alwaysmy/Artix-7_GTP_USB3_WCH_MCU/1_Hardware/SCH_XC7K35T_GTP_USB_Core_LiteRevB.1.sch_2025-10-08.pdf

# XC7A35TCSG325_USB3_Demo

2025-10-07

# 2025-09-28 XC7K35T_GTP_USB_Core_LiteRevB.1.sch

封面
A.W.2666
A.W.2666
Rev.A.0 | A3 | Xxx Studio

审阅

绘制

版本

### 创建日期 物料编码

页 | 共

### 原理图

### 更新日期

尺寸

图页

# 版本说明：这一版是无DDR版

## 1、在RevB上小改动，完善

# XC7K35T_GTP_USB_Core_LiteRevB.1

## CONFIG

# FPGA 配置

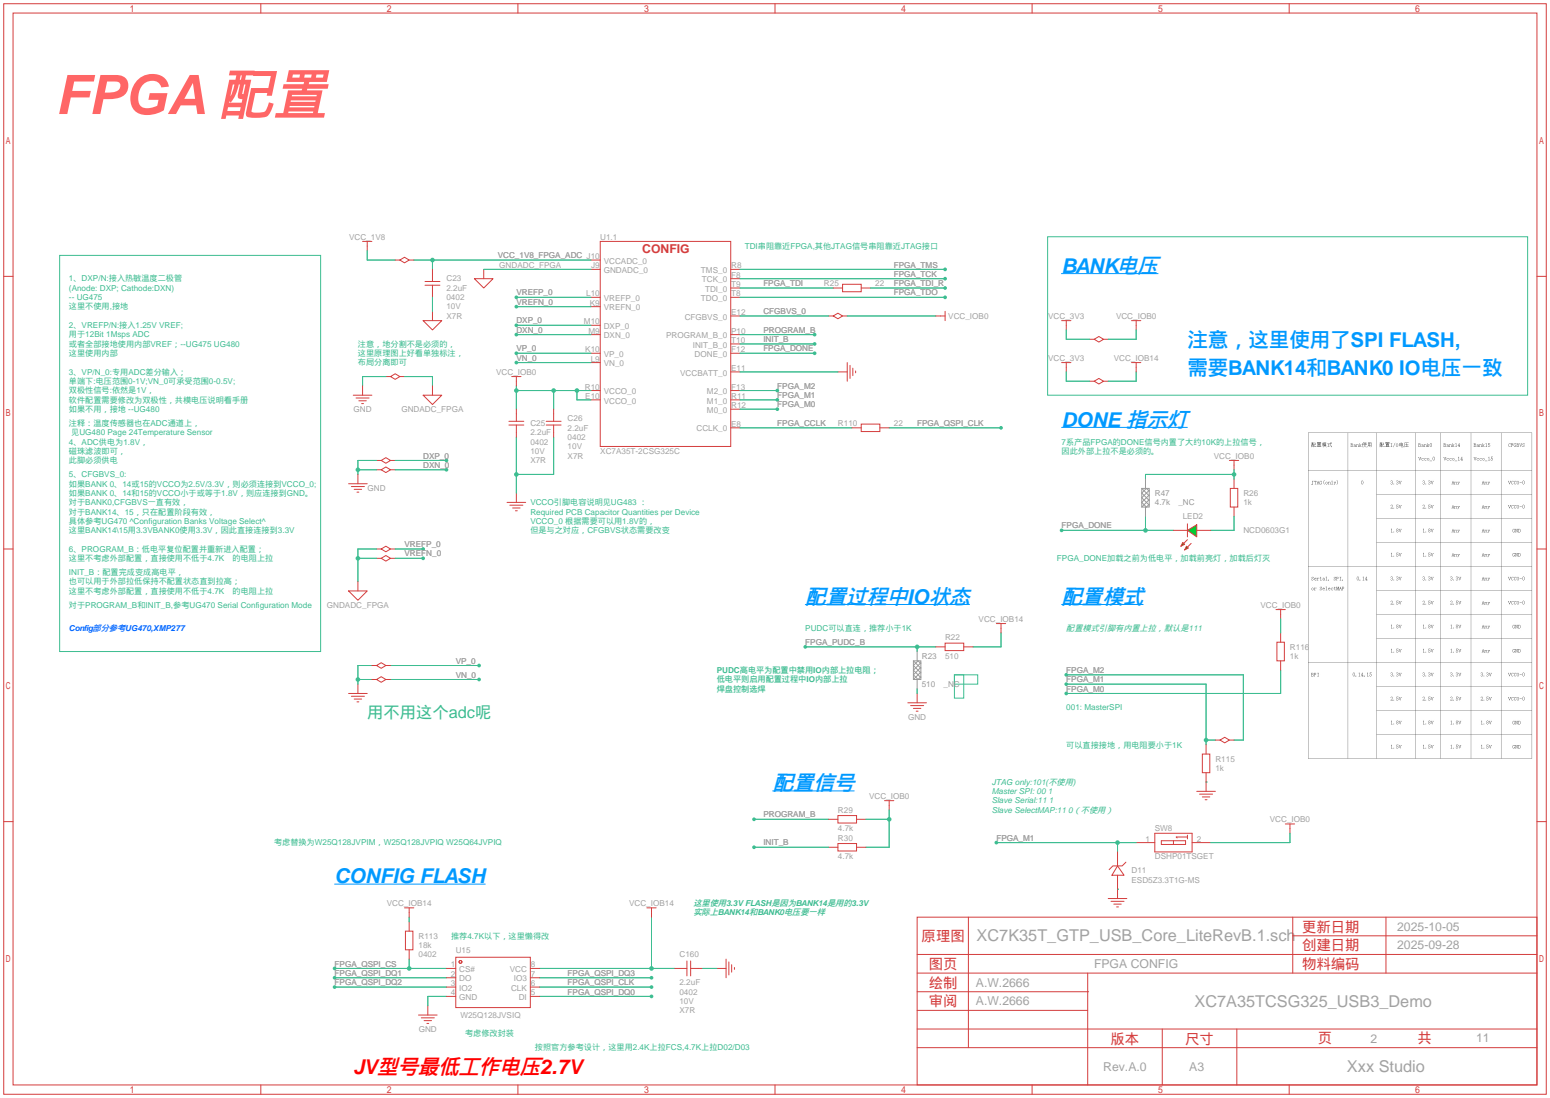
[picture p3: page 2]

VCCO引脚电容说明见UG483 ：
Required PCB Capacitor Quantities per Device
VCCO_0 根据需要可以用1.8V的，
但是与之对应，CFGBVS状态需要改变

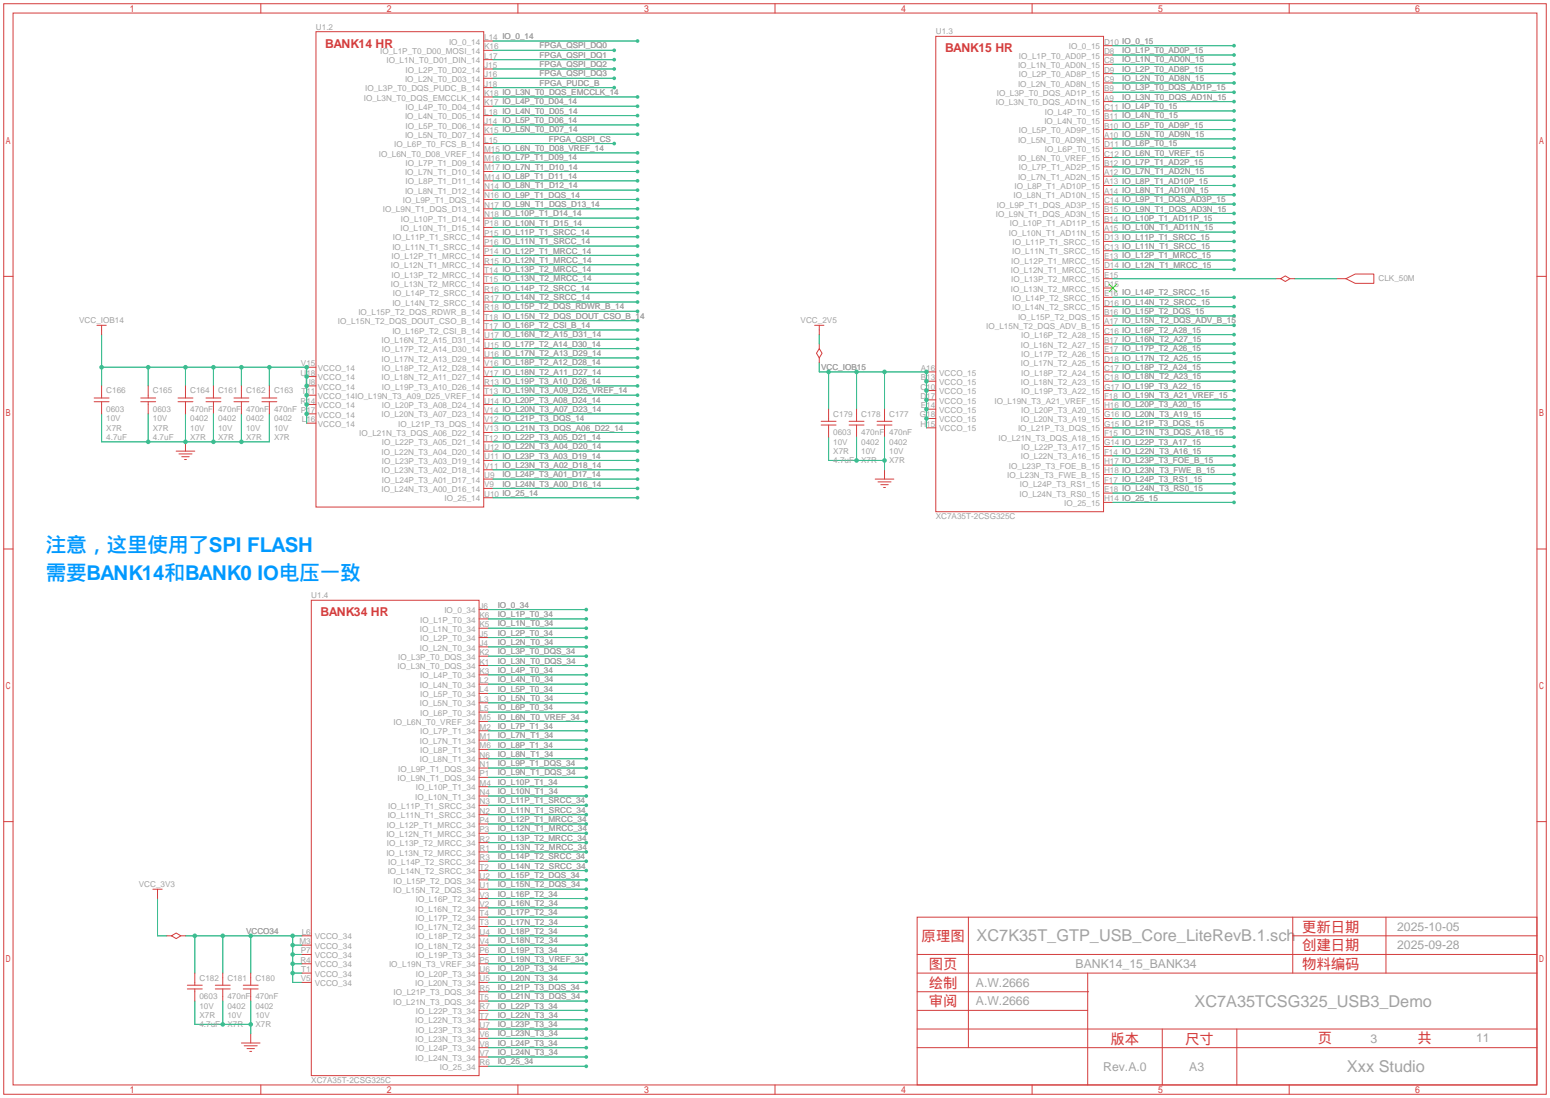
[picture p4: page 3]

## GTP

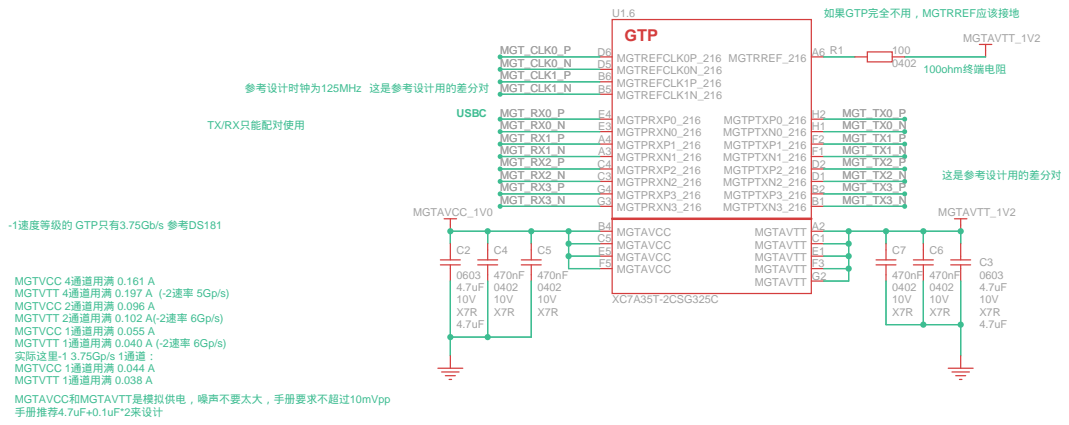
[picture p5: page 4]

## POWER

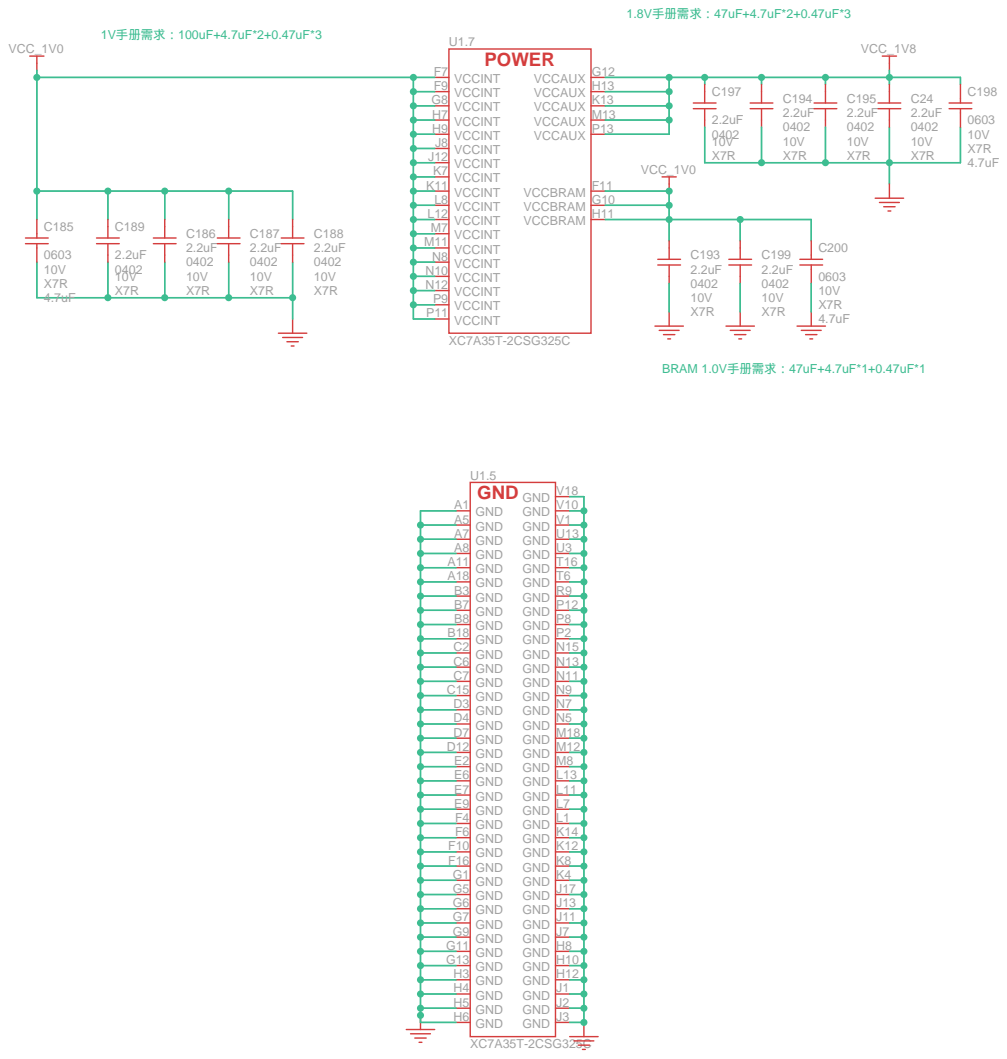
[picture p6: page 5]

# USB3和2都是差分90R

## 提供20对差分对

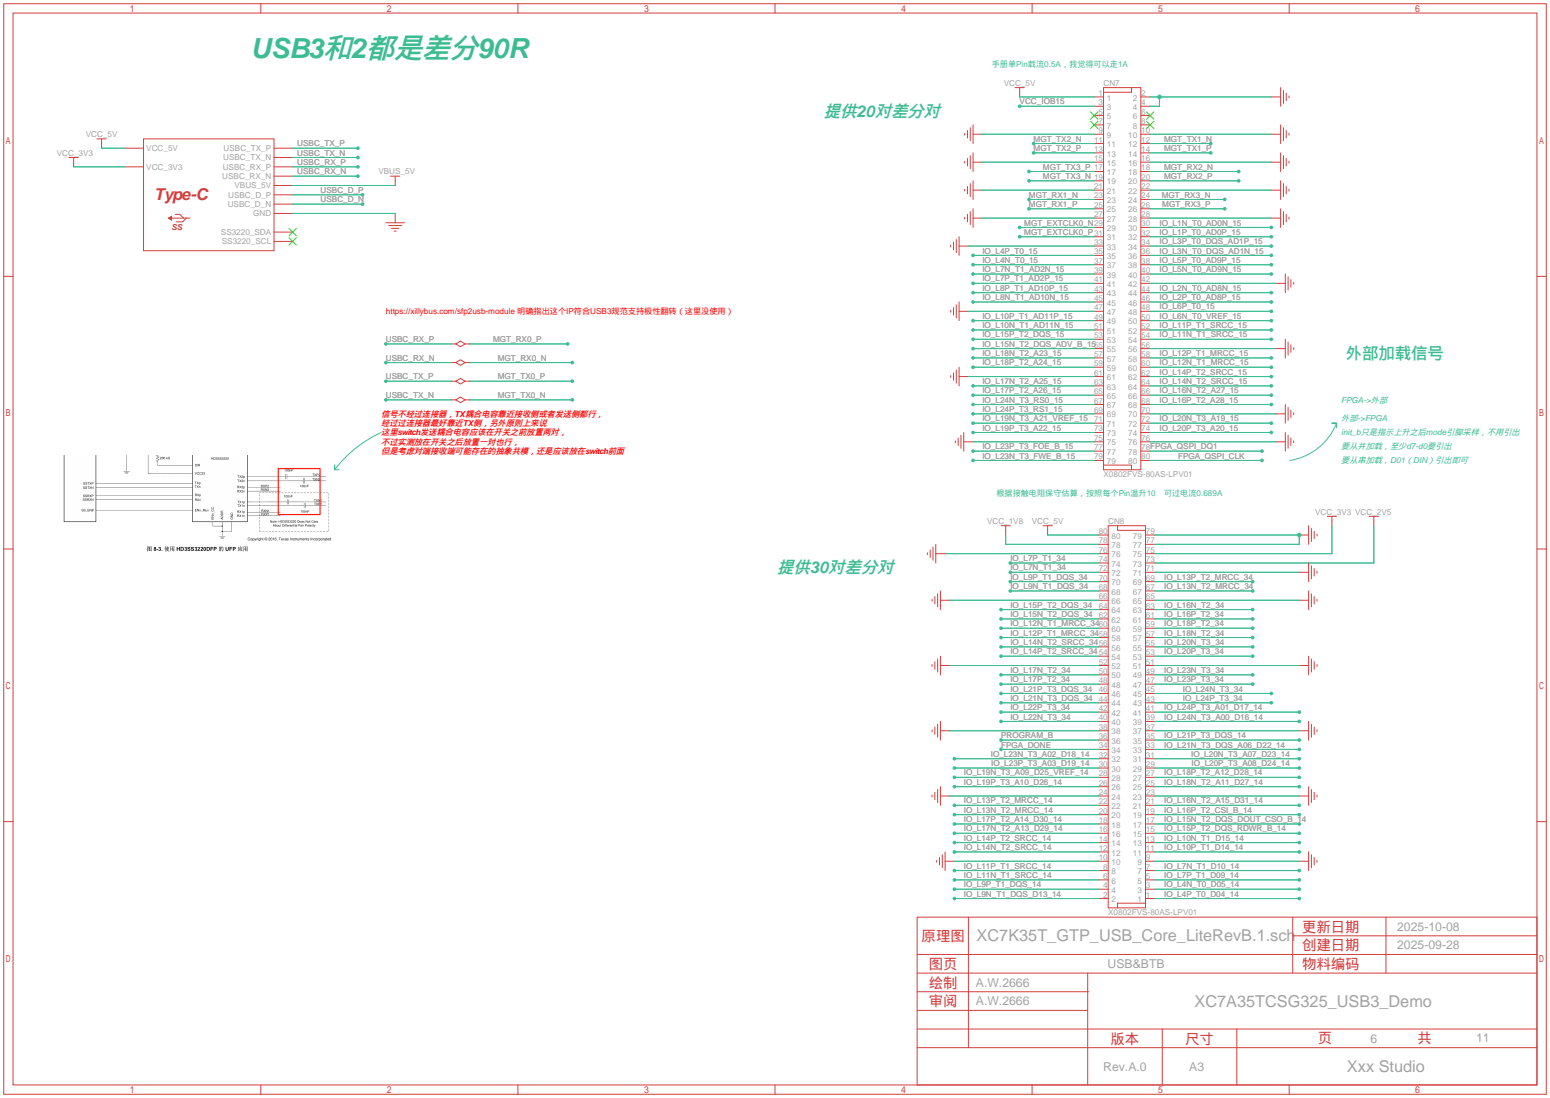
[picture p7: page 6]

https://xillybus.com/sfp2usb-module 明确指出这个IP符合USB3规范支持极性翻转（这里没使用）

# UFP 应用

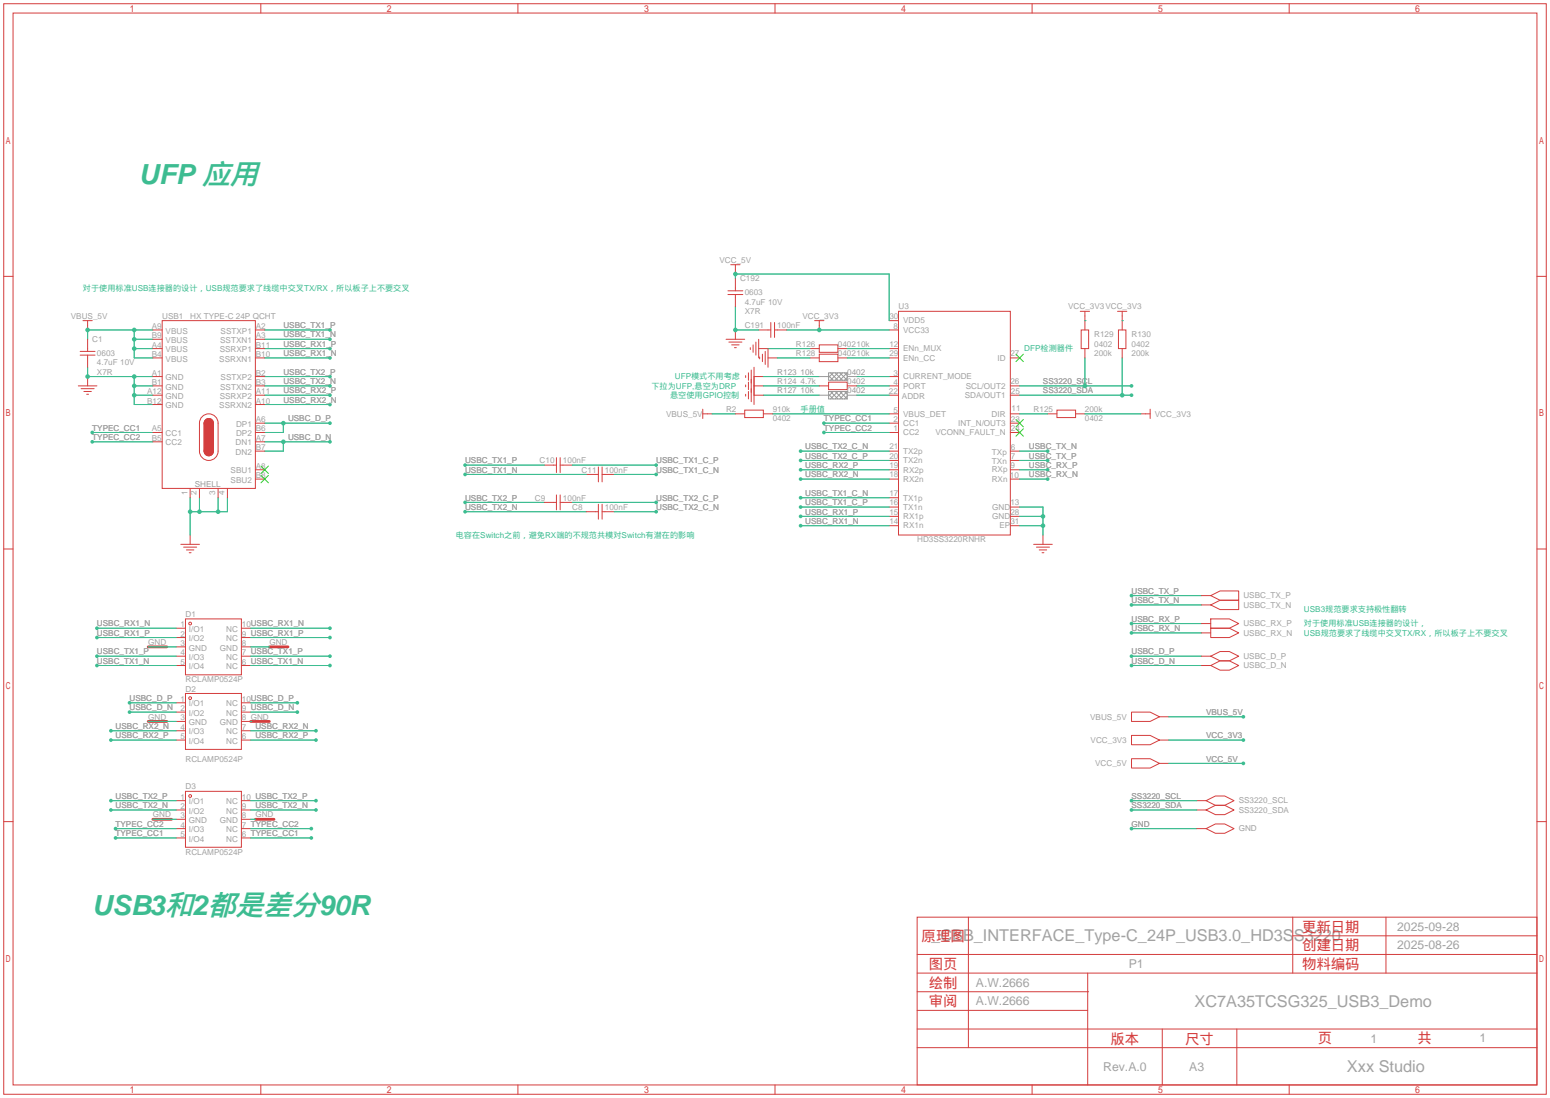
[picture p8: page 7]

对于使用标准USB连接器的设计，USB规范要求了线缆中交叉TX/RX，所以板子上不要交叉

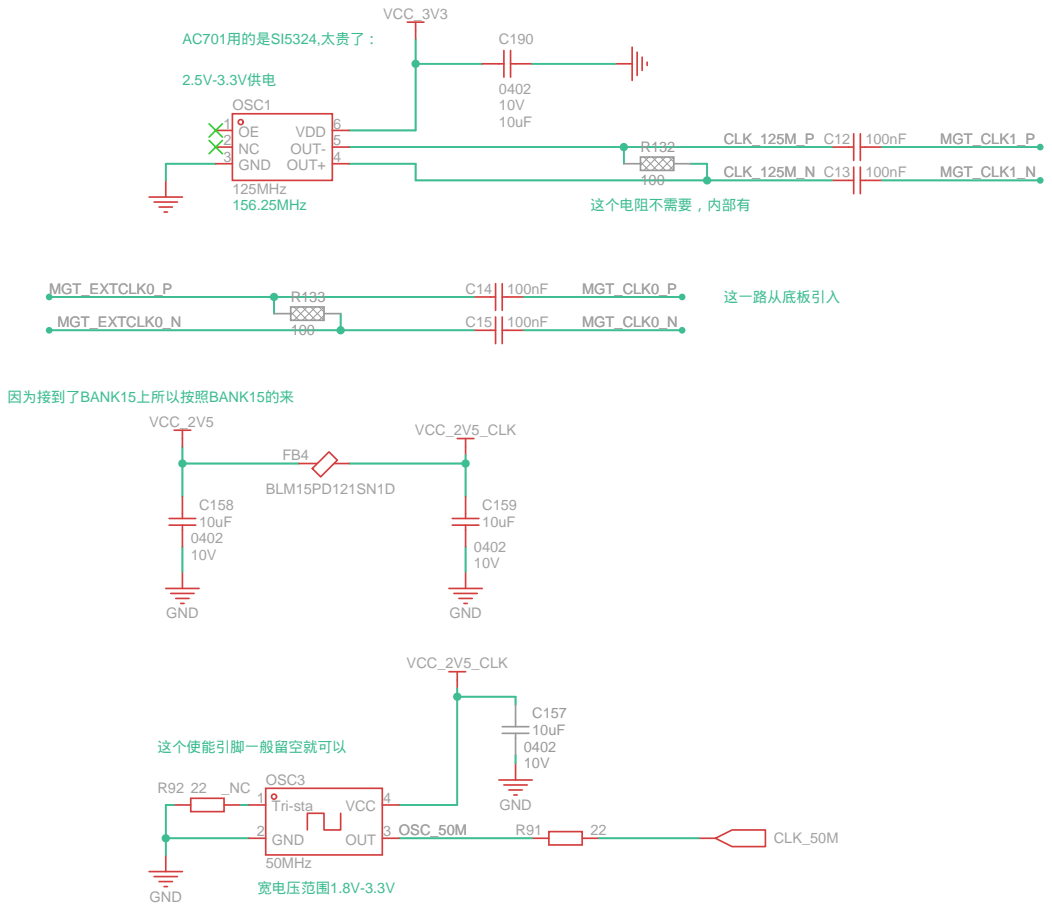
[picture p9: page 8]

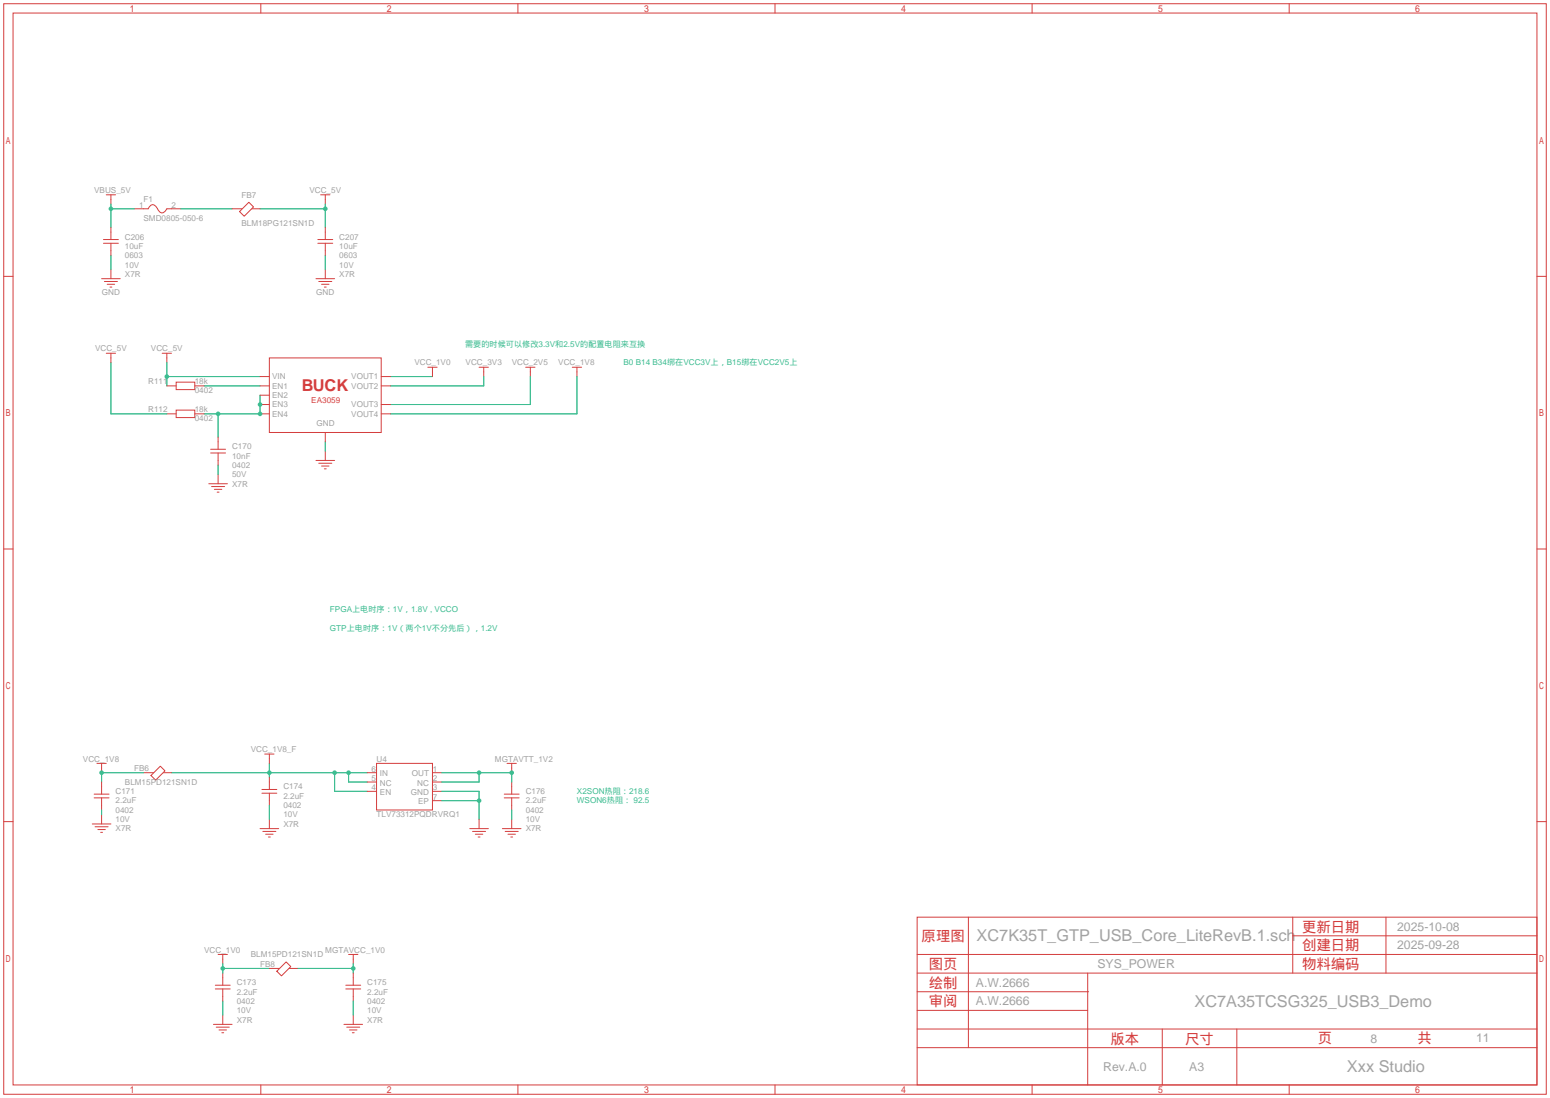
[picture p10: page 9]

# 输出范围0.6V to Vin 工作频率：1.5MHz

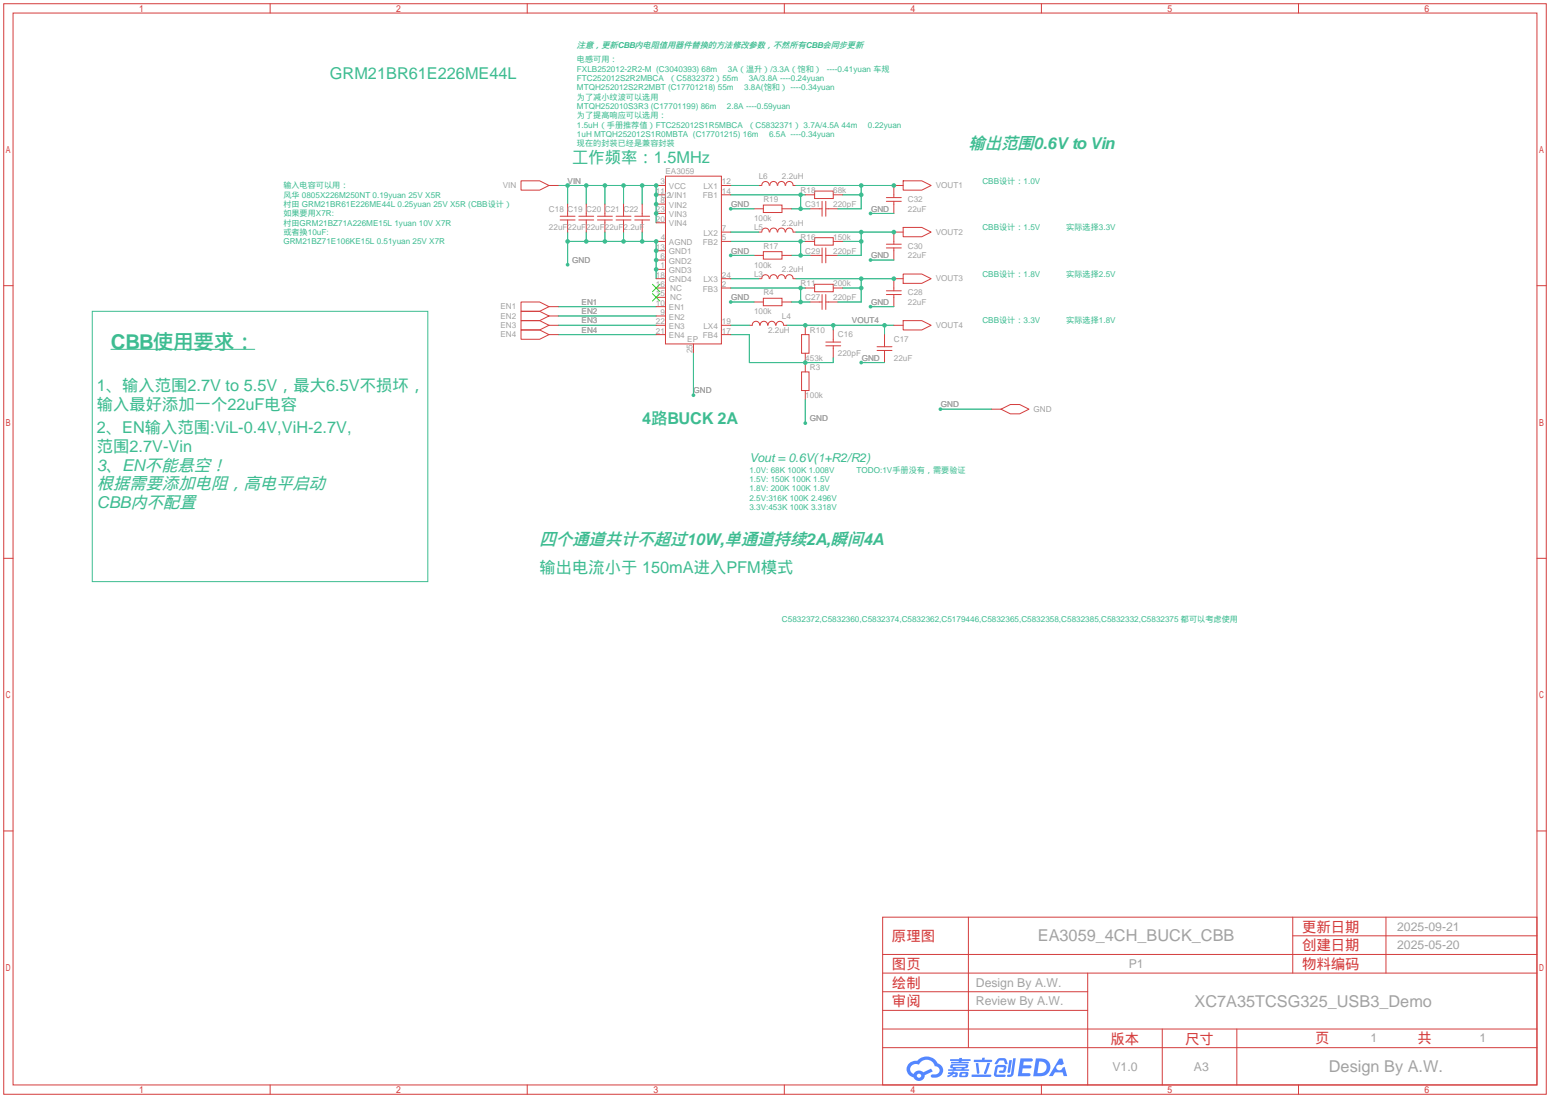
[picture p11: page 10]

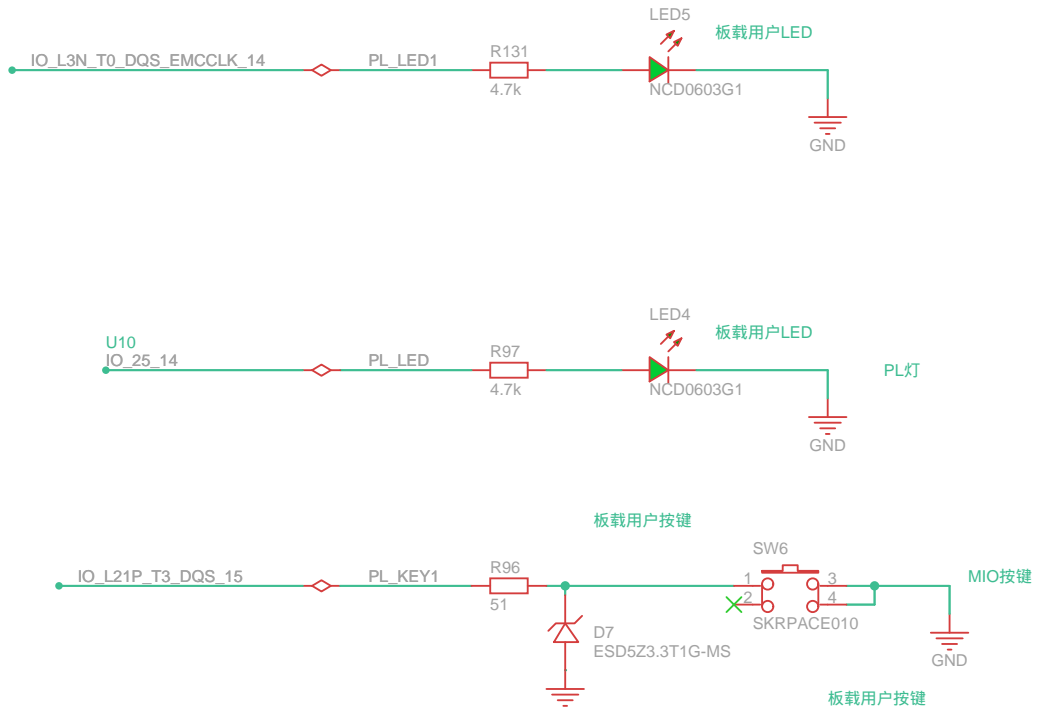
[picture p12: page 11]

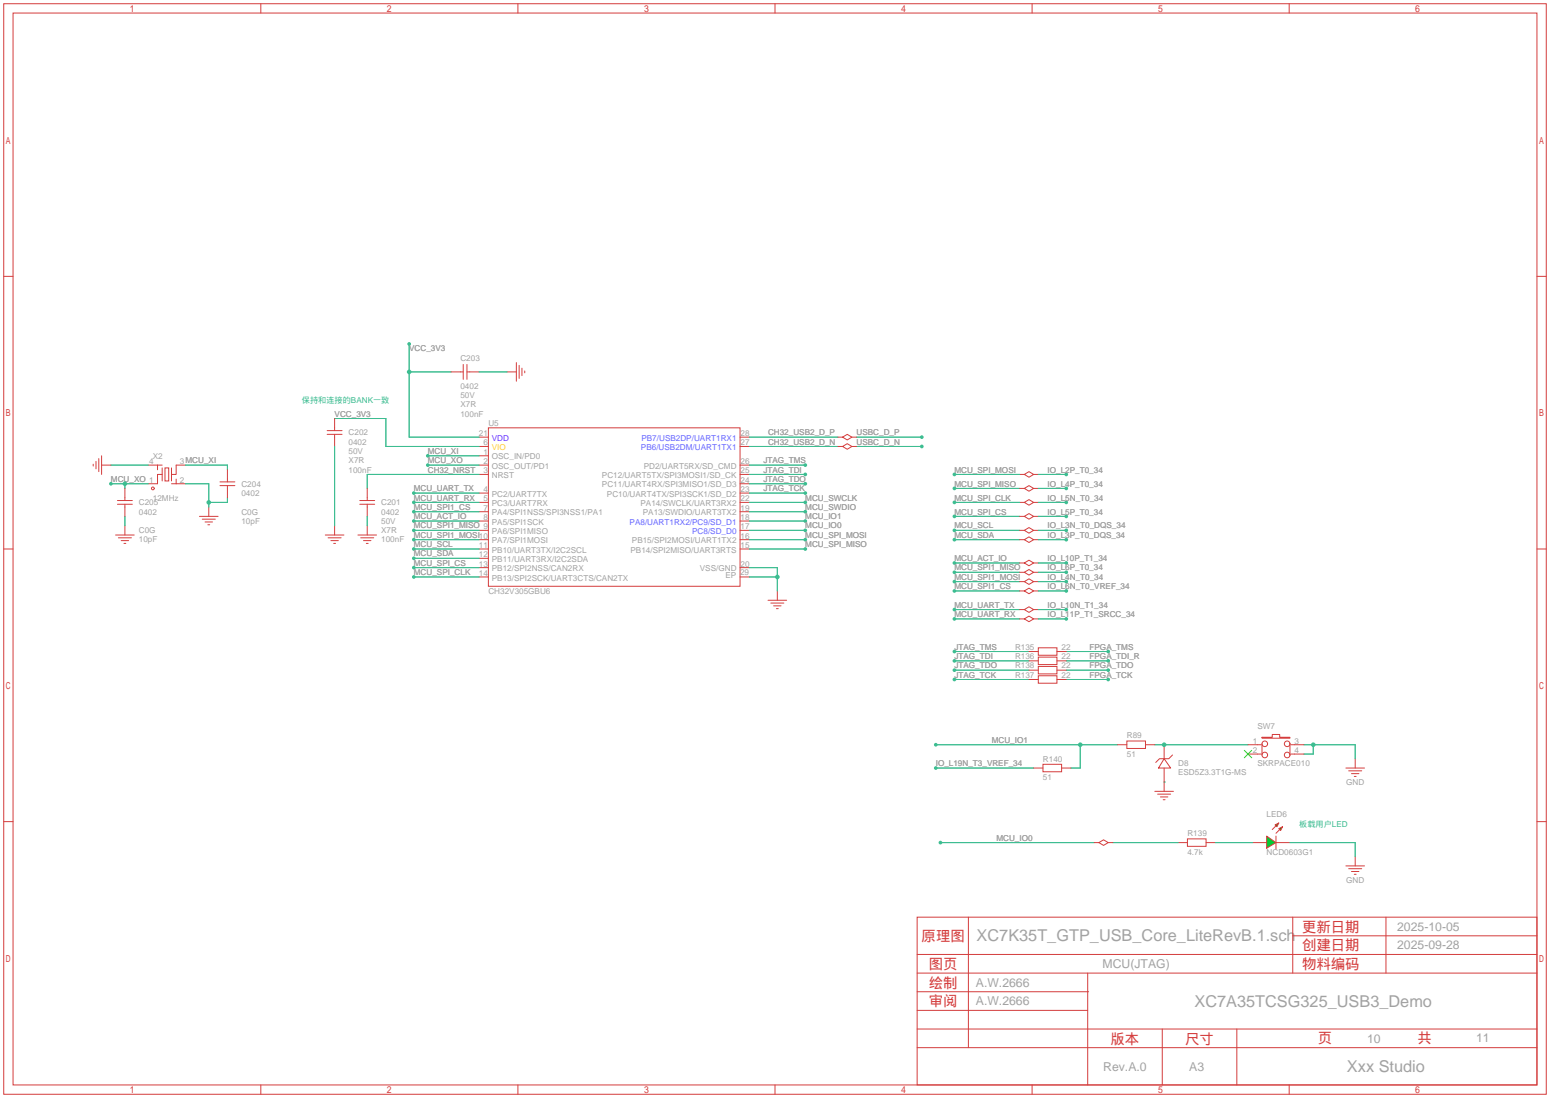
[picture p13: page 12]

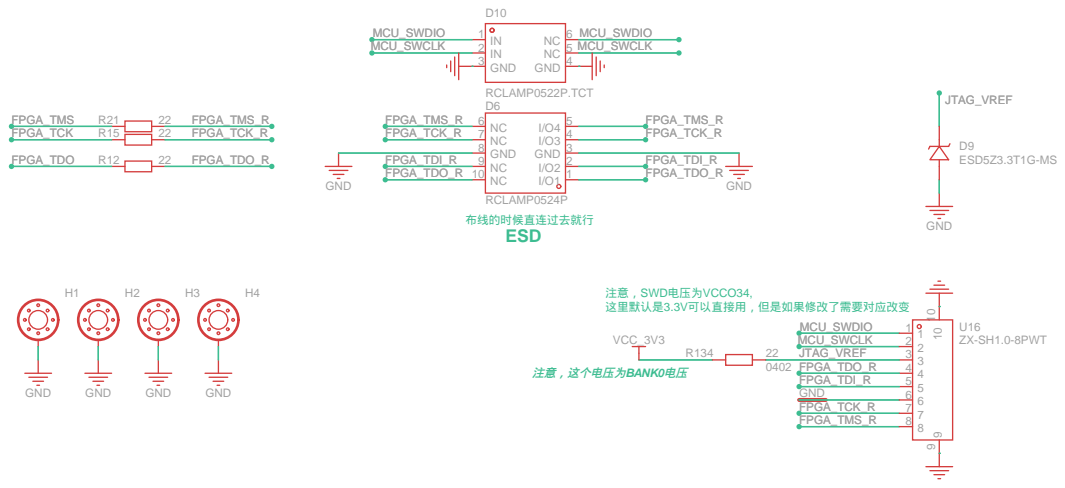
[picture p14: page 13]
