alwaysmy/Artix-7_GTP_USB3_WCH_MCU/(list of files, drawings)

Other design files:
1_Hardware/ProDoc_XC7K35T_GTP_USB_Core_LiteRevB.1.brd_2025-10-08.epro
