alwaysmy/Artix-7_GTP_USB3_WCH_MCU/2_Firmware/Artix-7_GTP_USB3_WCH_MCU_XillyUSB-USBC_SpeedTest/vivado-essentials/fifo_32/fifo_32_sim_netlist.v

// Copyright 1986-2019 Xilinx, Inc. All Rights Reserved.
// --------------------------------------------------------------------------------
// Tool Version: Vivado v.2018.3.1 (win64) Build 2489853 Tue Mar 26 04:20:25 MDT 2019
// Date        : Mon May 19 22:49:03 2025
// Host        : TS-Always running 64-bit major release  (build 9200)
// Command     : write_verilog -force -mode funcsim
//               D:/MyProjects/2_MyDesigns/USB3_Artix_GTP/xillyusb-bundle-artix7-trenz-1.10/vivado-essentials/fifo_32/fifo_32_sim_netlist.v
// Design      : fifo_32
// Purpose     : This verilog netlist is a functional simulation representation of the design and should not be modified
//               or synthesized. This netlist cannot be used for SDF annotated simulation.
// Device      : xc7a35tcsg325-2
// --------------------------------------------------------------------------------
`timescale 1 ps / 1 ps

(* CHECK_LICENSE_TYPE = "fifo_32,fifo_generator_v13_2_3,{}" *) (* downgradeipidentifiedwarnings = "yes" *) (* x_core_info = "fifo_generator_v13_2_3,Vivado 2018.3.1" *) 
(* NotValidForBitStream *)
module fifo_32
   (clk,
    srst,
    din,
    wr_en,
    rd_en,
    dout,
    full,
    empty);
  (* x_interface_info = "xilinx.com:signal:clock:1.0 core_clk CLK" *) (* x_interface_parameter = "XIL_INTERFACENAME core_clk, FREQ_HZ 100000000, PHASE 0.000, INSERT_VIP 0" *) input clk;
  input srst;
  (* x_interface_info = "xilinx.com:interface:fifo_write:1.0 FIFO_WRITE WR_DATA" *) input [31:0]din;
  (* x_interface_info = "xilinx.com:interface:fifo_write:1.0 FIFO_WRITE WR_EN" *) input wr_en;
  (* x_interface_info = "xilinx.com:interface:fifo_read:1.0 FIFO_READ RD_EN" *) input rd_en;
  (* x_interface_info = "xilinx.com:interface:fifo_read:1.0 FIFO_READ RD_DATA" *) output [31:0]dout;
  (* x_interface_info = "xilinx.com:interface:fifo_write:1.0 FIFO_WRITE FULL" *) output full;
  (* x_interface_info = "xilinx.com:interface:fifo_read:1.0 FIFO_READ EMPTY" *) output empty;

  wire clk;
  wire [31:0]din;
  wire [31:0]dout;
  wire empty;
  wire full;
  wire rd_en;
  wire srst;
  wire wr_en;
  wire NLW_U0_almost_empty_UNCONNECTED;
  wire NLW_U0_almost_full_UNCONNECTED;
  wire NLW_U0_axi_ar_dbiterr_UNCONNECTED;
  wire NLW_U0_axi_ar_overflow_UNCONNECTED;
  wire NLW_U0_axi_ar_prog_empty_UNCONNECTED;
  wire NLW_U0_axi_ar_prog_full_UNCONNECTED;
  wire NLW_U0_axi_ar_sbiterr_UNCONNECTED;
  wire NLW_U0_axi_ar_underflow_UNCONNECTED;
  wire NLW_U0_axi_aw_dbiterr_UNCONNECTED;
  wire NLW_U0_axi_aw_overflow_UNCONNECTED;
  wire NLW_U0_axi_aw_prog_empty_UNCONNECTED;
  wire NLW_U0_axi_aw_prog_full_UNCONNECTED;
  wire NLW_U0_axi_aw_sbiterr_UNCONNECTED;
  wire NLW_U0_axi_aw_underflow_UNCONNECTED;
  wire NLW_U0_axi_b_dbiterr_UNCONNECTED;
  wire NLW_U0_axi_b_overflow_UNCONNECTED;
  wire NLW_U0_axi_b_prog_empty_UNCONNECTED;
  wire NLW_U0_axi_b_prog_full_UNCONNECTED;
  wire NLW_U0_axi_b_sbiterr_UNCONNECTED;
  wire NLW_U0_axi_b_underflow_UNCONNECTED;
  wire NLW_U0_axi_r_dbiterr_UNCONNECTED;
  wire NLW_U0_axi_r_overflow_UNCONNECTED;
  wire NLW_U0_axi_r_prog_empty_UNCONNECTED;
  wire NLW_U0_axi_r_prog_full_UNCONNECTED;
  wire NLW_U0_axi_r_sbiterr_UNCONNECTED;
  wire NLW_U0_axi_r_underflow_UNCONNECTED;
  wire NLW_U0_axi_w_dbiterr_UNCONNECTED;
  wire NLW_U0_axi_w_overflow_UNCONNECTED;
  wire NLW_U0_axi_w_prog_empty_UNCONNECTED;
  wire NLW_U0_axi_w_prog_full_UNCONNECTED;
  wire NLW_U0_axi_w_sbiterr_UNCONNECTED;
  wire NLW_U0_axi_w_underflow_UNCONNECTED;
  wire NLW_U0_axis_dbiterr_UNCONNECTED;
  wire NLW_U0_axis_overflow_UNCONNECTED;
  wire NLW_U0_axis_prog_empty_UNCONNECTED;
  wire NLW_U0_axis_prog_full_UNCONNECTED;
  wire NLW_U0_axis_sbiterr_UNCONNECTED;
  wire NLW_U0_axis_underflow_UNCONNECTED;
  wire NLW_U0_dbiterr_UNCONNECTED;
  wire NLW_U0_m_axi_arvalid_UNCONNECTED;
  wire NLW_U0_m_axi_awvalid_UNCONNECTED;
  wire NLW_U0_m_axi_bready_UNCONNECTED;
  wire NLW_U0_m_axi_rready_UNCONNECTED;
  wire NLW_U0_m_axi_wlast_UNCONNECTED;
  wire NLW_U0_m_axi_wvalid_UNCONNECTED;
  wire NLW_U0_m_axis_tlast_UNCONNECTED;
  wire NLW_U0_m_axis_tvalid_UNCONNECTED;
  wire NLW_U0_overflow_UNCONNECTED;
  wire NLW_U0_prog_empty_UNCONNECTED;
  wire NLW_U0_prog_full_UNCONNECTED;
  wire NLW_U0_rd_rst_busy_UNCONNECTED;
  wire NLW_U0_s_axi_arready_UNCONNECTED;
  wire NLW_U0_s_axi_awready_UNCONNECTED;
  wire NLW_U0_s_axi_bvalid_UNCONNECTED;
  wire NLW_U0_s_axi_rlast_UNCONNECTED;
  wire NLW_U0_s_axi_rvalid_UNCONNECTED;
  wire NLW_U0_s_axi_wready_UNCONNECTED;
  wire NLW_U0_s_axis_tready_UNCONNECTED;
  wire NLW_U0_sbiterr_UNCONNECTED;
  wire NLW_U0_underflow_UNCONNECTED;
  wire NLW_U0_valid_UNCONNECTED;
  wire NLW_U0_wr_ack_UNCONNECTED;
  wire NLW_U0_wr_rst_busy_UNCONNECTED;
  wire [4:0]NLW_U0_axi_ar_data_count_UNCONNECTED;
  wire [4:0]NLW_U0_axi_ar_rd_data_count_UNCONNECTED;
  wire [4:0]NLW_U0_axi_ar_wr_data_count_UNCONNECTED;
  wire [4:0]NLW_U0_axi_aw_data_count_UNCONNECTED;
  wire [4:0]NLW_U0_axi_aw_rd_data_count_UNCONNECTED;
  wire [4:0]NLW_U0_axi_aw_wr_data_count_UNCONNECTED;
  wire [4:0]NLW_U0_axi_b_data_count_UNCONNECTED;
  wire [4:0]NLW_U0_axi_b_rd_data_count_UNCONNECTED;
  wire [4:0]NLW_U0_axi_b_wr_data_count_UNCONNECTED;
  wire [10:0]NLW_U0_axi_r_data_count_UNCONNECTED;
  wire [10:0]NLW_U0_axi_r_rd_data_count_UNCONNECTED;
  wire [10:0]NLW_U0_axi_r_wr_data_count_UNCONNECTED;
  wire [10:0]NLW_U0_axi_w_data_count_UNCONNECTED;
  wire [10:0]NLW_U0_axi_w_rd_data_count_UNCONNECTED;
  wire [10:0]NLW_U0_axi_w_wr_data_count_UNCONNECTED;
  wire [10:0]NLW_U0_axis_data_count_UNCONNECTED;
  wire [10:0]NLW_U0_axis_rd_data_count_UNCONNECTED;
  wire [10:0]NLW_U0_axis_wr_data_count_UNCONNECTED;
  wire [13:0]NLW_U0_data_count_UNCONNECTED;
  wire [31:0]NLW_U0_m_axi_araddr_UNCONNECTED;
  wire [1:0]NLW_U0_m_axi_arburst_UNCONNECTED;
  wire [3:0]NLW_U0_m_axi_arcache_UNCONNECTED;
  wire [0:0]NLW_U0_m_axi_arid_UNCONNECTED;
  wire [7:0]NLW_U0_m_axi_arlen_UNCONNECTED;
  wire [0:0]NLW_U0_m_axi_arlock_UNCONNECTED;
  wire [2:0]NLW_U0_m_axi_arprot_UNCONNECTED;
  wire [3:0]NLW_U0_m_axi_arqos_UNCONNECTED;
  wire [3:0]NLW_U0_m_axi_arregion_UNCONNECTED;
  wire [2:0]NLW_U0_m_axi_arsize_UNCONNECTED;
  wire [0:0]NLW_U0_m_axi_aruser_UNCONNECTED;
  wire [31:0]NLW_U0_m_axi_awaddr_UNCONNECTED;
  wire [1:0]NLW_U0_m_axi_awburst_UNCONNECTED;
  wire [3:0]NLW_U0_m_axi_awcache_UNCONNECTED;
  wire [0:0]NLW_U0_m_axi_awid_UNCONNECTED;
  wire [7:0]NLW_U0_m_axi_awlen_UNCONNECTED;
  wire [0:0]NLW_U0_m_axi_awlock_UNCONNECTED;
  wire [2:0]NLW_U0_m_axi_awprot_UNCONNECTED;
  wire [3:0]NLW_U0_m_axi_awqos_UNCONNECTED;
  wire [3:0]NLW_U0_m_axi_awregion_UNCONNECTED;
  wire [2:0]NLW_U0_m_axi_awsize_UNCONNECTED;
  wire [0:0]NLW_U0_m_axi_awuser_UNCONNECTED;
  wire [63:0]NLW_U0_m_axi_wdata_UNCONNECTED;
  wire [0:0]NLW_U0_m_axi_wid_UNCONNECTED;
  wire [7:0]NLW_U0_m_axi_wstrb_UNCONNECTED;
  wire [0:0]NLW_U0_m_axi_wuser_UNCONNECTED;
  wire [0:0]NLW_U0_m_axis_tdata_UNCONNECTED;
  wire [0:0]NLW_U0_m_axis_tdest_UNCONNECTED;
  wire [0:0]NLW_U0_m_axis_tid_UNCONNECTED;
  wire [0:0]NLW_U0_m_axis_tkeep_UNCONNECTED;
  wire [0:0]NLW_U0_m_axis_tstrb_UNCONNECTED;
  wire [3:0]NLW_U0_m_axis_tuser_UNCONNECTED;
  wire [13:0]NLW_U0_rd_data_count_UNCONNECTED;
  wire [0:0]NLW_U0_s_axi_bid_UNCONNECTED;
  wire [1:0]NLW_U0_s_axi_bresp_UNCONNECTED;
  wire [0:0]NLW_U0_s_axi_buser_UNCONNECTED;
  wire [63:0]NLW_U0_s_axi_rdata_UNCONNECTED;
  wire [0:0]NLW_U0_s_axi_rid_UNCONNECTED;
  wire [1:0]NLW_U0_s_axi_rresp_UNCONNECTED;
  wire [0:0]NLW_U0_s_axi_ruser_UNCONNECTED;
  wire [13:0]NLW_U0_wr_data_count_UNCONNECTED;

  (* C_ADD_NGC_CONSTRAINT = "0" *) 
  (* C_APPLICATION_TYPE_AXIS = "0" *) 
  (* C_APPLICATION_TYPE_RACH = "0" *) 
  (* C_APPLICATION_TYPE_RDCH = "0" *) 
  (* C_APPLICATION_TYPE_WACH = "0" *) 
  (* C_APPLICATION_TYPE_WDCH = "0" *) 
  (* C_APPLICATION_TYPE_WRCH = "0" *) 
  (* C_AXIS_TDATA_WIDTH = "1" *) 
  (* C_AXIS_TDEST_WIDTH = "1" *) 
  (* C_AXIS_TID_WIDTH = "1" *) 
  (* C_AXIS_TKEEP_WIDTH = "1" *) 
  (* C_AXIS_TSTRB_WIDTH = "1" *) 
  (* C_AXIS_TUSER_WIDTH = "4" *) 
  (* C_AXIS_TYPE = "0" *) 
  (* C_AXI_ADDR_WIDTH = "32" *) 
  (* C_AXI_ARUSER_WIDTH = "1" *) 
  (* C_AXI_AWUSER_WIDTH = "1" *) 
  (* C_AXI_BUSER_WIDTH = "1" *) 
  (* C_AXI_DATA_WIDTH = "64" *) 
  (* C_AXI_ID_WIDTH = "1" *) 
  (* C_AXI_LEN_WIDTH = "8" *) 
  (* C_AXI_LOCK_WIDTH = "1" *) 
  (* C_AXI_RUSER_WIDTH = "1" *) 
  (* C_AXI_TYPE = "1" *) 
  (* C_AXI_WUSER_WIDTH = "1" *) 
  (* C_COMMON_CLOCK = "1" *) 
  (* C_COUNT_TYPE = "0" *) 
  (* C_DATA_COUNT_WIDTH = "14" *) 
  (* C_DEFAULT_VALUE = "BlankString" *) 
  (* C_DIN_WIDTH = "32" *) 
  (* C_DIN_WIDTH_AXIS = "1" *) 
  (* C_DIN_WIDTH_RACH = "32" *) 
  (* C_DIN_WIDTH_RDCH = "64" *) 
  (* C_DIN_WIDTH_WACH = "1" *) 
  (* C_DIN_WIDTH_WDCH = "64" *) 
  (* C_DIN_WIDTH_WRCH = "2" *) 
  (* C_DOUT_RST_VAL = "0" *) 
  (* C_DOUT_WIDTH = "32" *) 
  (* C_ENABLE_RLOCS = "0" *) 
  (* C_ENABLE_RST_SYNC = "1" *) 
  (* C_EN_SAFETY_CKT = "0" *) 
  (* C_ERROR_INJECTION_TYPE = "0" *) 
  (* C_ERROR_INJECTION_TYPE_AXIS = "0" *) 
  (* C_ERROR_INJECTION_TYPE_RACH = "0" *) 
  (* C_ERROR_INJECTION_TYPE_RDCH = "0" *) 
  (* C_ERROR_INJECTION_TYPE_WACH = "0" *) 
  (* C_ERROR_INJECTION_TYPE_WDCH = "0" *) 
  (* C_ERROR_INJECTION_TYPE_WRCH = "0" *) 
  (* C_FAMILY = "artix7" *) 
  (* C_FULL_FLAGS_RST_VAL = "0" *) 
  (* C_HAS_ALMOST_EMPTY = "0" *) 
  (* C_HAS_ALMOST_FULL = "0" *) 
  (* C_HAS_AXIS_TDATA = "0" *) 
  (* C_HAS_AXIS_TDEST = "0" *) 
  (* C_HAS_AXIS_TID = "0" *) 
  (* C_HAS_AXIS_TKEEP = "0" *) 
  (* C_HAS_AXIS_TLAST = "0" *) 
  (* C_HAS_AXIS_TREADY = "1" *) 
  (* C_HAS_AXIS_TSTRB = "0" *) 
  (* C_HAS_AXIS_TUSER = "1" *) 
  (* C_HAS_AXI_ARUSER = "0" *) 
  (* C_HAS_AXI_AWUSER = "0" *) 
  (* C_HAS_AXI_BUSER = "0" *) 
  (* C_HAS_AXI_ID = "0" *) 
  (* C_HAS_AXI_RD_CHANNEL = "1" *) 
  (* C_HAS_AXI_RUSER = "0" *) 
  (* C_HAS_AXI_WR_CHANNEL = "1" *) 
  (* C_HAS_AXI_WUSER = "0" *) 
  (* C_HAS_BACKUP = "0" *) 
  (* C_HAS_DATA_COUNT = "0" *) 
  (* C_HAS_DATA_COUNTS_AXIS = "0" *) 
  (* C_HAS_DATA_COUNTS_RACH = "0" *) 
  (* C_HAS_DATA_COUNTS_RDCH = "0" *) 
  (* C_HAS_DATA_COUNTS_WACH = "0" *) 
  (* C_HAS_DATA_COUNTS_WDCH = "0" *) 
  (* C_HAS_DATA_COUNTS_WRCH = "0" *) 
  (* C_HAS_INT_CLK = "0" *) 
  (* C_HAS_MASTER_CE = "0" *) 
  (* C_HAS_MEMINIT_FILE = "0" *) 
  (* C_HAS_OVERFLOW = "0" *) 
  (* C_HAS_PROG_FLAGS_AXIS = "0" *) 
  (* C_HAS_PROG_FLAGS_RACH = "0" *) 
  (* C_HAS_PROG_FLAGS_RDCH = "0" *) 
  (* C_HAS_PROG_FLAGS_WACH = "0" *) 
  (* C_HAS_PROG_FLAGS_WDCH = "0" *) 
  (* C_HAS_PROG_FLAGS_WRCH = "0" *) 
  (* C_HAS_RD_DATA_COUNT = "0" *) 
  (* C_HAS_RD_RST = "0" *) 
  (* C_HAS_RST = "0" *) 
  (* C_HAS_SLAVE_CE = "0" *) 
  (* C_HAS_SRST = "1" *) 
  (* C_HAS_UNDERFLOW = "0" *) 
  (* C_HAS_VALID = "0" *) 
  (* C_HAS_WR_ACK = "0" *) 
  (* C_HAS_WR_DATA_COUNT = "0" *) 
  (* C_HAS_WR_RST = "0" *) 
  (* C_IMPLEMENTATION_TYPE = "0" *) 
  (* C_IMPLEMENTATION_TYPE_AXIS = "1" *) 
  (* C_IMPLEMENTATION_TYPE_RACH = "1" *) 
  (* C_IMPLEMENTATION_TYPE_RDCH = "1" *) 
  (* C_IMPLEMENTATION_TYPE_WACH = "1" *) 
  (* C_IMPLEMENTATION_TYPE_WDCH = "1" *) 
  (* C_IMPLEMENTATION_TYPE_WRCH = "1" *) 
  (* C_INIT_WR_PNTR_VAL = "0" *) 
  (* C_INTERFACE_TYPE = "0" *) 
  (* C_MEMORY_TYPE = "1" *) 
  (* C_MIF_FILE_NAME = "BlankString" *) 
  (* C_MSGON_VAL = "1" *) 
  (* C_OPTIMIZATION_MODE = "0" *) 
  (* C_OVERFLOW_LOW = "0" *) 
  (* C_POWER_SAVING_MODE = "0" *) 
  (* C_PRELOAD_LATENCY = "1" *) 
  (* C_PRELOAD_REGS = "0" *) 
  (* C_PRIM_FIFO_TYPE = "8kx4" *) 
  (* C_PRIM_FIFO_TYPE_AXIS = "1kx18" *) 
  (* C_PRIM_FIFO_TYPE_RACH = "512x36" *) 
  (* C_PRIM_FIFO_TYPE_RDCH = "1kx36" *) 
  (* C_PRIM_FIFO_TYPE_WACH = "512x36" *) 
  (* C_PRIM_FIFO_TYPE_WDCH = "1kx36" *) 
  (* C_PRIM_FIFO_TYPE_WRCH = "512x36" *) 
  (* C_PROG_EMPTY_THRESH_ASSERT_VAL = "2" *) 
  (* C_PROG_EMPTY_THRESH_ASSERT_VAL_AXIS = "1022" *) 
  (* C_PROG_EMPTY_THRESH_ASSERT_VAL_RACH = "1022" *) 
  (* C_PROG_EMPTY_THRESH_ASSERT_VAL_RDCH = "1022" *) 
  (* C_PROG_EMPTY_THRESH_ASSERT_VAL_WACH = "1022" *) 
  (* C_PROG_EMPTY_THRESH_ASSERT_VAL_WDCH = "1022" *) 
  (* C_PROG_EMPTY_THRESH_ASSERT_VAL_WRCH = "1022" *) 
  (* C_PROG_EMPTY_THRESH_NEGATE_VAL = "3" *) 
  (* C_PROG_EMPTY_TYPE = "0" *) 
  (* C_PROG_EMPTY_TYPE_AXIS = "0" *) 
  (* C_PROG_EMPTY_TYPE_RACH = "0" *) 
  (* C_PROG_EMPTY_TYPE_RDCH = "0" *) 
  (* C_PROG_EMPTY_TYPE_WACH = "0" *) 
  (* C_PROG_EMPTY_TYPE_WDCH = "0" *) 
  (* C_PROG_EMPTY_TYPE_WRCH = "0" *) 
  (* C_PROG_FULL_THRESH_ASSERT_VAL = "16382" *) 
  (* C_PROG_FULL_THRESH_ASSERT_VAL_AXIS = "1023" *) 
  (* C_PROG_FULL_THRESH_ASSERT_VAL_RACH = "1023" *) 
  (* C_PROG_FULL_THRESH_ASSERT_VAL_RDCH = "1023" *) 
  (* C_PROG_FULL_THRESH_ASSERT_VAL_WACH = "1023" *) 
  (* C_PROG_FULL_THRESH_ASSERT_VAL_WDCH = "1023" *) 
  (* C_PROG_FULL_THRESH_ASSERT_VAL_WRCH = "1023" *) 
  (* C_PROG_FULL_THRESH_NEGATE_VAL = "16381" *) 
  (* C_PROG_FULL_TYPE = "0" *) 
  (* C_PROG_FULL_TYPE_AXIS = "0" *) 
  (* C_PROG_FULL_TYPE_RACH = "0" *) 
  (* C_PROG_FULL_TYPE_RDCH = "0" *) 
  (* C_PROG_FULL_TYPE_WACH = "0" *) 
  (* C_PROG_FULL_TYPE_WDCH = "0" *) 
  (* C_PROG_FULL_TYPE_WRCH = "0" *) 
  (* C_RACH_TYPE = "0" *) 
  (* C_RDCH_TYPE = "0" *) 
  (* C_RD_DATA_COUNT_WIDTH = "14" *) 
  (* C_RD_DEPTH = "16384" *) 
  (* C_RD_FREQ = "1" *) 
  (* C_RD_PNTR_WIDTH = "14" *) 
  (* C_REG_SLICE_MODE_AXIS = "0" *) 
  (* C_REG_SLICE_MODE_RACH = "0" *) 
  (* C_REG_SLICE_MODE_RDCH = "0" *) 
  (* C_REG_SLICE_MODE_WACH = "0" *) 
  (* C_REG_SLICE_MODE_WDCH = "0" *) 
  (* C_REG_SLICE_MODE_WRCH = "0" *) 
  (* C_SELECT_XPM = "0" *) 
  (* C_SYNCHRONIZER_STAGE = "2" *) 
  (* C_UNDERFLOW_LOW = "0" *) 
  (* C_USE_COMMON_OVERFLOW = "0" *) 
  (* C_USE_COMMON_UNDERFLOW = "0" *) 
  (* C_USE_DEFAULT_SETTINGS = "0" *) 
  (* C_USE_DOUT_RST = "1" *) 
  (* C_USE_ECC = "0" *) 
  (* C_USE_ECC_AXIS = "0" *) 
  (* C_USE_ECC_RACH = "0" *) 
  (* C_USE_ECC_RDCH = "0" *) 
  (* C_USE_ECC_WACH = "0" *) 
  (* C_USE_ECC_WDCH = "0" *) 
  (* C_USE_ECC_WRCH = "0" *) 
  (* C_USE_EMBEDDED_REG = "0" *) 
  (* C_USE_FIFO16_FLAGS = "0" *) 
  (* C_USE_FWFT_DATA_COUNT = "0" *) 
  (* C_USE_PIPELINE_REG = "0" *) 
  (* C_VALID_LOW = "0" *) 
  (* C_WACH_TYPE = "0" *) 
  (* C_WDCH_TYPE = "0" *) 
  (* C_WRCH_TYPE = "0" *) 
  (* C_WR_ACK_LOW = "0" *) 
  (* C_WR_DATA_COUNT_WIDTH = "14" *) 
  (* C_WR_DEPTH = "16384" *) 
  (* C_WR_DEPTH_AXIS = "1024" *) 
  (* C_WR_DEPTH_RACH = "16" *) 
  (* C_WR_DEPTH_RDCH = "1024" *) 
  (* C_WR_DEPTH_WACH = "16" *) 
  (* C_WR_DEPTH_WDCH = "1024" *) 
  (* C_WR_DEPTH_WRCH = "16" *) 
  (* C_WR_FREQ = "1" *) 
  (* C_WR_PNTR_WIDTH = "14" *) 
  (* C_WR_PNTR_WIDTH_AXIS = "10" *) 
  (* C_WR_PNTR_WIDTH_RACH = "4" *) 
  (* C_WR_PNTR_WIDTH_RDCH = "10" *) 
  (* C_WR_PNTR_WIDTH_WACH = "4" *) 
  (* C_WR_PNTR_WIDTH_WDCH = "10" *) 
  (* C_WR_PNTR_WIDTH_WRCH = "4" *) 
  (* C_WR_RESPONSE_LATENCY = "1" *) 
  fifo_32_fifo_generator_v13_2_3 U0
       (.almost_empty(NLW_U0_almost_empty_UNCONNECTED),
        .almost_full(NLW_U0_almost_full_UNCONNECTED),
        .axi_ar_data_count(NLW_U0_axi_ar_data_count_UNCONNECTED[4:0]),
        .axi_ar_dbiterr(NLW_U0_axi_ar_dbiterr_UNCONNECTED),
        .axi_ar_injectdbiterr(1'b0),
        .axi_ar_injectsbiterr(1'b0),
        .axi_ar_overflow(NLW_U0_axi_ar_overflow_UNCONNECTED),
        .axi_ar_prog_empty(NLW_U0_axi_ar_prog_empty_UNCONNECTED),
        .axi_ar_prog_empty_thresh({1'b0,1'b0,1'b0,1'b0}),
        .axi_ar_prog_full(NLW_U0_axi_ar_prog_full_UNCONNECTED),
        .axi_ar_prog_full_thresh({1'b0,1'b0,1'b0,1'b0}),
        .axi_ar_rd_data_count(NLW_U0_axi_ar_rd_data_count_UNCONNECTED[4:0]),
        .axi_ar_sbiterr(NLW_U0_axi_ar_sbiterr_UNCONNECTED),
        .axi_ar_underflow(NLW_U0_axi_ar_underflow_UNCONNECTED),
        .axi_ar_wr_data_count(NLW_U0_axi_ar_wr_data_count_UNCONNECTED[4:0]),
        .axi_aw_data_count(NLW_U0_axi_aw_data_count_UNCONNECTED[4:0]),
        .axi_aw_dbiterr(NLW_U0_axi_aw_dbiterr_UNCONNECTED),
        .axi_aw_injectdbiterr(1'b0),
        .axi_aw_injectsbiterr(1'b0),
        .axi_aw_overflow(NLW_U0_axi_aw_overflow_UNCONNECTED),
        .axi_aw_prog_empty(NLW_U0_axi_aw_prog_empty_UNCONNECTED),
        .axi_aw_prog_empty_thresh({1'b0,1'b0,1'b0,1'b0}),
        .axi_aw_prog_full(NLW_U0_axi_aw_prog_full_UNCONNECTED),
        .axi_aw_prog_full_thresh({1'b0,1'b0,1'b0,1'b0}),
        .axi_aw_rd_data_count(NLW_U0_axi_aw_rd_data_count_UNCONNECTED[4:0]),
        .axi_aw_sbiterr(NLW_U0_axi_aw_sbiterr_UNCONNECTED),
        .axi_aw_underflow(NLW_U0_axi_aw_underflow_UNCONNECTED),
        .axi_aw_wr_data_count(NLW_U0_axi_aw_wr_data_count_UNCONNECTED[4:0]),
        .axi_b_data_count(NLW_U0_axi_b_data_count_UNCONNECTED[4:0]),
        .axi_b_dbiterr(NLW_U0_axi_b_dbiterr_UNCONNECTED),
        .axi_b_injectdbiterr(1'b0),
        .axi_b_injectsbiterr(1'b0),
        .axi_b_overflow(NLW_U0_axi_b_overflow_UNCONNECTED),
        .axi_b_prog_empty(NLW_U0_axi_b_prog_empty_UNCONNECTED),
        .axi_b_prog_empty_thresh({1'b0,1'b0,1'b0,1'b0}),
        .axi_b_prog_full(NLW_U0_axi_b_prog_full_UNCONNECTED),
        .axi_b_prog_full_thresh({1'b0,1'b0,1'b0,1'b0}),
        .axi_b_rd_data_count(NLW_U0_axi_b_rd_data_count_UNCONNECTED[4:0]),
        .axi_b_sbiterr(NLW_U0_axi_b_sbiterr_UNCONNECTED),
        .axi_b_underflow(NLW_U0_axi_b_underflow_UNCONNECTED),
        .axi_b_wr_data_count(NLW_U0_axi_b_wr_data_count_UNCONNECTED[4:0]),
        .axi_r_data_count(NLW_U0_axi_r_data_count_UNCONNECTED[10:0]),
        .axi_r_dbiterr(NLW_U0_axi_r_dbiterr_UNCONNECTED),
        .axi_r_injectdbiterr(1'b0),
        .axi_r_injectsbiterr(1'b0),
        .axi_r_overflow(NLW_U0_axi_r_overflow_UNCONNECTED),
        .axi_r_prog_empty(NLW_U0_axi_r_prog_empty_UNCONNECTED),
        .axi_r_prog_empty_thresh({1'b0,1'b0,1'b0,1'b0,1'b0,1'b0,1'b0,1'b0,1'b0,1'b0}),
        .axi_r_prog_full(NLW_U0_axi_r_prog_full_UNCONNECTED),
        .axi_r_prog_full_thresh({1'b0,1'b0,1'b0,1'b0,1'b0,1'b0,1'b0,1'b0,1'b0,1'b0}),
        .axi_r_rd_data_count(NLW_U0_axi_r_rd_data_count_UNCONNECTED[10:0]),
        .axi_r_sbiterr(NLW_U0_axi_r_sbiterr_UNCONNECTED),
        .axi_r_underflow(NLW_U0_axi_r_underflow_UNCONNECTED),
        .axi_r_wr_data_count(NLW_U0_axi_r_wr_data_count_UNCONNECTED[10:0]),
        .axi_w_data_count(NLW_U0_axi_w_data_count_UNCONNECTED[10:0]),
        .axi_w_dbiterr(NLW_U0_axi_w_dbiterr_UNCONNECTED),
        .axi_w_injectdbiterr(1'b0),
        .axi_w_injectsbiterr(1'b0),
        .axi_w_overflow(NLW_U0_axi_w_overflow_UNCONNECTED),
        .axi_w_prog_empty(NLW_U0_axi_w_prog_empty_UNCONNECTED),
        .axi_w_prog_empty_thresh({1'b0,1'b0,1'b0,1'b0,1'b0,1'b0,1'b0,1'b0,1'b0,1'b0}),
        .axi_w_prog_full(NLW_U0_axi_w_prog_full_UNCONNECTED),
        .axi_w_prog_full_thresh({1'b0,1'b0,1'b0,1'b0,1'b0,1'b0,1'b0,1'b0,1'b0,1'b0}),
        .axi_w_rd_data_count(NLW_U0_axi_w_rd_data_count_UNCONNECTED[10:0]),
        .axi_w_sbiterr(NLW_U0_axi_w_sbiterr_UNCONNECTED),
        .axi_w_underflow(NLW_U0_axi_w_underflow_UNCONNECTED),
        .axi_w_wr_data_count(NLW_U0_axi_w_wr_data_count_UNCONNECTED[10:0]),
        .axis_data_count(NLW_U0_axis_data_count_UNCONNECTED[10:0]),
        .axis_dbiterr(NLW_U0_axis_dbiterr_UNCONNECTED),
        .axis_injectdbiterr(1'b0),
        .axis_injectsbiterr(1'b0),
        .axis_overflow(NLW_U0_axis_overflow_UNCONNECTED),
        .axis_prog_empty(NLW_U0_axis_prog_empty_UNCONNECTED),
        .axis_prog_empty_thresh({1'b0,1'b0,1'b0,1'b0,1'b0,1'b0,1'b0,1'b0,1'b0,1'b0}),
        .axis_prog_full(NLW_U0_axis_prog_full_UNCONNECTED),
        .axis_prog_full_thresh({1'b0,1'b0,1'b0,1'b0,1'b0,1'b0,1'b0,1'b0,1'b0,1'b0}),
        .axis_rd_data_count(NLW_U0_axis_rd_data_count_UNCONNECTED[10:0]),
        .axis_sbiterr(NLW_U0_axis_sbiterr_UNCONNECTED),
        .axis_underflow(NLW_U0_axis_underflow_UNCONNECTED),
        .axis_wr_data_count(NLW_U0_axis_wr_data_count_UNCONNECTED[10:0]),
        .backup(1'b0),
        .backup_marker(1'b0),
        .clk(clk),
        .data_count(NLW_U0_data_count_UNCONNECTED[13:0]),
        .dbiterr(NLW_U0_dbiterr_UNCONNECTED),
        .din(din),
        .dout(dout),
        .empty(empty),
        .full(full),
        .injectdbiterr(1'b0),
        .injectsbiterr(1'b0),
        .int_clk(1'b0),
        .m_aclk(1'b0),
        .m_aclk_en(1'b0),
        .m_axi_araddr(NLW_U0_m_axi_araddr_UNCONNECTED[31:0]),
        .m_axi_arburst(NLW_U0_m_axi_arburst_UNCONNECTED[1:0]),
        .m_axi_arcache(NLW_U0_m_axi_arcache_UNCONNECTED[3:0]),
        .m_axi_arid(NLW_U0_m_axi_arid_UNCONNECTED[0]),
        .m_axi_arlen(NLW_U0_m_axi_arlen_UNCONNECTED[7:0]),
        .m_axi_arlock(NLW_U0_m_axi_arlock_UNCONNECTED[0]),
        .m_axi_arprot(NLW_U0_m_axi_arprot_UNCONNECTED[2:0]),
        .m_axi_arqos(NLW_U0_m_axi_arqos_UNCONNECTED[3:0]),
        .m_axi_arready(1'b0),
        .m_axi_arregion(NLW_U0_m_axi_arregion_UNCONNECTED[3:0]),
        .m_axi_arsize(NLW_U0_m_axi_arsize_UNCONNECTED[2:0]),
        .m_axi_aruser(NLW_U0_m_axi_aruser_UNCONNECTED[0]),
        .m_axi_arvalid(NLW_U0_m_axi_arvalid_UNCONNECTED),
        .m_axi_awaddr(NLW_U0_m_axi_awaddr_UNCONNECTED[31:0]),
        .m_axi_awburst(NLW_U0_m_axi_awburst_UNCONNECTED[1:0]),
        .m_axi_awcache(NLW_U0_m_axi_awcache_UNCONNECTED[3:0]),
        .m_axi_awid(NLW_U0_m_axi_awid_UNCONNECTED[0]),
        .m_axi_awlen(NLW_U0_m_axi_awlen_UNCONNECTED[7:0]),
        .m_axi_awlock(NLW_U0_m_axi_awlock_UNCONNECTED[0]),
        .m_axi_awprot(NLW_U0_m_axi_awprot_UNCONNECTED[2:0]),
        .m_axi_awqos(NLW_U0_m_axi_awqos_UNCONNECTED[3:0]),
        .m_axi_awready(1'b0),
        .m_axi_awregion(NLW_U0_m_axi_awregion_UNCONNECTED[3:0]),
        .m_axi_awsize(NLW_U0_m_axi_awsize_UNCONNECTED[2:0]),
        .m_axi_awuser(NLW_U0_m_axi_awuser_UNCONNECTED[0]),
        .m_axi_awvalid(NLW_U0_m_axi_awvalid_UNCONNECTED),
        .m_axi_bid(1'b0),
        .m_axi_bready(NLW_U0_m_axi_bready_UNCONNECTED),
        .m_axi_bresp({1'b0,1'b0}),
        .m_axi_buser(1'b0),
        .m_axi_bvalid(1'b0),
        .m_axi_rdata({1'b0,1'b0,1'b0,1'b0,1'b0,1'b0,1'b0,1'b0,1'b0,1'b0,1'b0,1'b0,1'b0,1'b0,1'b0,1'b0,1'b0,1'b0,1'b0,1'b0,1'b0,1'b0,1'b0,1'b0,1'b0,1'b0,1'b0,1'b0,1'b0,1'b0,1'b0,1'b0,1'b0,1'b0,1'b0,1'b0,1'b0,1'b0,1'b0,1'b0,1'b0,1'b0,1'b0,1'b0,1'b0,1'b0,1'b0,1'b0,1'b0,1'b0,1'b0,1'b0,1'b0,1'b0,1'b0,1'b0,1'b0,1'b0,1'b0,1'b0,1'b0,1'b0,1'b0,1'b0}),
        .m_axi_rid(1'b0),
        .m_axi_rlast(1'b0),
        .m_axi_rready(NLW_U0_m_axi_rready_UNCONNECTED),
        .m_axi_rresp({1'b0,1'b0}),
        .m_axi_ruser(1'b0),
        .m_axi_rvalid(1'b0),
        .m_axi_wdata(NLW_U0_m_axi_wdata_UNCONNECTED[63:0]),
        .m_axi_wid(NLW_U0_m_axi_wid_UNCONNECTED[0]),
        .m_axi_wlast(NLW_U0_m_axi_wlast_UNCONNECTED),
        .m_axi_wready(1'b0),
        .m_axi_wstrb(NLW_U0_m_axi_wstrb_UNCONNECTED[7:0]),
        .m_axi_wuser(NLW_U0_m_axi_wuser_UNCONNECTED[0]),
        .m_axi_wvalid(NLW_U0_m_axi_wvalid_UNCONNECTED),
        .m_axis_tdata(NLW_U0_m_axis_tdata_UNCONNECTED[0]),
        .m_axis_tdest(NLW_U0_m_axis_tdest_UNCONNECTED[0]),
        .m_axis_tid(NLW_U0_m_axis_tid_UNCONNECTED[0]),
        .m_axis_tkeep(NLW_U0_m_axis_tkeep_UNCONNECTED[0]),
        .m_axis_tlast(NLW_U0_m_axis_tlast_UNCONNECTED),
        .m_axis_tready(1'b0),
        .m_axis_tstrb(NLW_U0_m_axis_tstrb_UNCONNECTED[0]),
        .m_axis_tuser(NLW_U0_m_axis_tuser_UNCONNECTED[3:0]),
        .m_axis_tvalid(NLW_U0_m_axis_tvalid_UNCONNECTED),
        .overflow(NLW_U0_overflow_UNCONNECTED),
        .prog_empty(NLW_U0_prog_empty_UNCONNECTED),
        .prog_empty_thresh({1'b0,1'b0,1'b0,1'b0,1'b0,1'b0,1'b0,1'b0,1'b0,1'b0,1'b0,1'b0,1'b0,1'b0}),
        .prog_empty_thresh_assert({1'b0,1'b0,1'b0,1'b0,1'b0,1'b0,1'b0,1'b0,1'b0,1'b0,1'b0,1'b0,1'b0,1'b0}),
        .prog_empty_thresh_negate({1'b0,1'b0,1'b0,1'b0,1'b0,1'b0,1'b0,1'b0,1'b0,1'b0,1'b0,1'b0,1'b0,1'b0}),
        .prog_full(NLW_U0_prog_full_UNCONNECTED),
        .prog_full_thresh({1'b0,1'b0,1'b0,1'b0,1'b0,1'b0,1'b0,1'b0,1'b0,1'b0,1'b0,1'b0,1'b0,1'b0}),
        .prog_full_thresh_assert({1'b0,1'b0,1'b0,1'b0,1'b0,1'b0,1'b0,1'b0,1'b0,1'b0,1'b0,1'b0,1'b0,1'b0}),
        .prog_full_thresh_negate({1'b0,1'b0,1'b0,1'b0,1'b0,1'b0,1'b0,1'b0,1'b0,1'b0,1'b0,1'b0,1'b0,1'b0}),
        .rd_clk(1'b0),
        .rd_data_count(NLW_U0_rd_data_count_UNCONNECTED[13:0]),
        .rd_en(rd_en),
        .rd_rst(1'b0),
        .rd_rst_busy(NLW_U0_rd_rst_busy_UNCONNECTED),
        .rst(1'b0),
        .s_aclk(1'b0),
        .s_aclk_en(1'b0),
        .s_aresetn(1'b0),
        .s_axi_araddr({1'b0,1'b0,1'b0,1'b0,1'b0,1'b0,1'b0,1'b0,1'b0,1'b0,1'b0,1'b0,1'b0,1'b0,1'b0,1'b0,1'b0,1'b0,1'b0,1'b0,1'b0,1'b0,1'b0,1'b0,1'b0,1'b0,1'b0,1'b0,1'b0,1'b0,1'b0,1'b0}),
        .s_axi_arburst({1'b0,1'b0}),
        .s_axi_arcache({1'b0,1'b0,1'b0,1'b0}),
        .s_axi_arid(1'b0),
        .s_axi_arlen({1'b0,1'b0,1'b0,1'b0,1'b0,1'b0,1'b0,1'b0}),
        .s_axi_arlock(1'b0),
        .s_axi_arprot({1'b0,1'b0,1'b0}),
        .s_axi_arqos({1'b0,1'b0,1'b0,1'b0}),
        .s_axi_arready(NLW_U0_s_axi_arready_UNCONNECTED),
        .s_axi_arregion({1'b0,1'b0,1'b0,1'b0}),
        .s_axi_arsize({1'b0,1'b0,1'b0}),
        .s_axi_aruser(1'b0),
        .s_axi_arvalid(1'b0),
        .s_axi_awaddr({1'b0,1'b0,1'b0,1'b0,1'b0,1'b0,1'b0,1'b0,1'b0,1'b0,1'b0,1'b0,1'b0,1'b0,1'b0,1'b0,1'b0,1'b0,1'b0,1'b0,1'b0,1'b0,1'b0,1'b0,1'b0,1'b0,1'b0,1'b0,1'b0,1'b0,1'b0,1'b0}),
        .s_axi_awburst({1'b0,1'b0}),
        .s_axi_awcache({1'b0,1'b0,1'b0,1'b0}),
        .s_axi_awid(1'b0),
        .s_axi_awlen({1'b0,1'b0,1'b0,1'b0,1'b0,1'b0,1'b0,1'b0}),
        .s_axi_awlock(1'b0),
        .s_axi_awprot({1'b0,1'b0,1'b0}),
        .s_axi_awqos({1'b0,1'b0,1'b0,1'b0}),
        .s_axi_awready(NLW_U0_s_axi_awready_UNCONNECTED),
        .s_axi_awregion({1'b0,1'b0,1'b0,1'b0}),
        .s_axi_awsize({1'b0,1'b0,1'b0}),
        .s_axi_awuser(1'b0),
        .s_axi_awvalid(1'b0),
        .s_axi_bid(NLW_U0_s_axi_bid_UNCONNECTED[0]),
        .s_axi_bready(1'b0),
        .s_axi_bresp(NLW_U0_s_axi_bresp_UNCONNECTED[1:0]),
        .s_axi_buser(NLW_U0_s_axi_buser_UNCONNECTED[0]),
        .s_axi_bvalid(NLW_U0_s_axi_bvalid_UNCONNECTED),
        .s_axi_rdata(NLW_U0_s_axi_rdata_UNCONNECTED[63:0]),
        .s_axi_rid(NLW_U0_s_axi_rid_UNCONNECTED[0]),
        .s_axi_rlast(NLW_U0_s_axi_rlast_UNCONNECTED),
        .s_axi_rready(1'b0),
        .s_axi_rresp(NLW_U0_s_axi_rresp_UNCONNECTED[1:0]),
        .s_axi_ruser(NLW_U0_s_axi_ruser_UNCONNECTED[0]),
        .s_axi_rvalid(NLW_U0_s_axi_rvalid_UNCONNECTED),
        .s_axi_wdata({1'b0,1'b0,1'b0,1'b0,1'b0,1'b0,1'b0,1'b0,1'b0,1'b0,1'b0,1'b0,1'b0,1'b0,1'b0,1'b0,1'b0,1'b0,1'b0,1'b0,1'b0,1'b0,1'b0,1'b0,1'b0,1'b0,1'b0,1'b0,1'b0,1'b0,1'b0,1'b0,1'b0,1'b0,1'b0,1'b0,1'b0,1'b0,1'b0,1'b0,1'b0,1'b0,1'b0,1'b0,1'b0,1'b0,1'b0,1'b0,1'b0,1'b0,1'b0,1'b0,1'b0,1'b0,1'b0,1'b0,1'b0,1'b0,1'b0,1'b0,1'b0,1'b0,1'b0,1'b0}),
        .s_axi_wid(1'b0),
        .s_axi_wlast(1'b0),
        .s_axi_wready(NLW_U0_s_axi_wready_UNCONNECTED),
        .s_axi_wstrb({1'b0,1'b0,1'b0,1'b0,1'b0,1'b0,1'b0,1'b0}),
        .s_axi_wuser(1'b0),
        .s_axi_wvalid(1'b0),
        .s_axis_tdata(1'b0),
        .s_axis_tdest(1'b0),
        .s_axis_tid(1'b0),
        .s_axis_tkeep(1'b0),
        .s_axis_tlast(1'b0),
        .s_axis_tready(NLW_U0_s_axis_tready_UNCONNECTED),
        .s_axis_tstrb(1'b0),
        .s_axis_tuser({1'b0,1'b0,1'b0,1'b0}),
        .s_axis_tvalid(1'b0),
        .sbiterr(NLW_U0_sbiterr_UNCONNECTED),
        .sleep(1'b0),
        .srst(srst),
        .underflow(NLW_U0_underflow_UNCONNECTED),
        .valid(NLW_U0_valid_UNCONNECTED),
        .wr_ack(NLW_U0_wr_ack_UNCONNECTED),
        .wr_clk(1'b0),
        .wr_data_count(NLW_U0_wr_data_count_UNCONNECTED[13:0]),
        .wr_en(wr_en),
        .wr_rst(1'b0),
        .wr_rst_busy(NLW_U0_wr_rst_busy_UNCONNECTED));
endmodule

(* ORIG_REF_NAME = "blk_mem_gen_generic_cstr" *) 
module fifo_32_blk_mem_gen_generic_cstr
   (dout,
    clk,
    \DEVICE_7SERIES.NO_BMM_INFO.SDP.SIMPLE_PRIM36.ram ,
    \DEVICE_7SERIES.NO_BMM_INFO.SDP.SIMPLE_PRIM36.ram_0 ,
    srst,
    Q,
    \DEVICE_7SERIES.NO_BMM_INFO.SDP.SIMPLE_PRIM36.ram_1 ,
    din,
    \DEVICE_7SERIES.NO_BMM_INFO.SDP.SIMPLE_PRIM36.ram_2 ,
    \DEVICE_7SERIES.NO_BMM_INFO.SDP.SIMPLE_PRIM36.ram_3 ,
    ena_array,
    enb_array,
    \DEVICE_7SERIES.NO_BMM_INFO.SDP.SIMPLE_PRIM36.ram_4 ,
    \DEVICE_7SERIES.NO_BMM_INFO.SDP.SIMPLE_PRIM36.ram_5 ,
    WEA,
    \DEVICE_7SERIES.NO_BMM_INFO.SDP.SIMPLE_PRIM36.ram_6 ,
    out,
    rd_en);
  output [31:0]dout;
  input clk;
  input \DEVICE_7SERIES.NO_BMM_INFO.SDP.SIMPLE_PRIM36.ram ;
  input \DEVICE_7SERIES.NO_BMM_INFO.SDP.SIMPLE_PRIM36.ram_0 ;
  input srst;
  input [13:0]Q;
  input [13:0]\DEVICE_7SERIES.NO_BMM_INFO.SDP.SIMPLE_PRIM36.ram_1 ;
  input [31:0]din;
  input [0:0]\DEVICE_7SERIES.NO_BMM_INFO.SDP.SIMPLE_PRIM36.ram_2 ;
  input [1:0]\DEVICE_7SERIES.NO_BMM_INFO.SDP.SIMPLE_PRIM36.ram_3 ;
  input [2:0]ena_array;
  input [2:0]enb_array;
  input \DEVICE_7SERIES.NO_BMM_INFO.SDP.SIMPLE_PRIM36.ram_4 ;
  input \DEVICE_7SERIES.NO_BMM_INFO.SDP.SIMPLE_PRIM36.ram_5 ;
  input [1:0]WEA;
  input [0:0]\DEVICE_7SERIES.NO_BMM_INFO.SDP.SIMPLE_PRIM36.ram_6 ;
  input out;
  input rd_en;

  wire \DEVICE_7SERIES.NO_BMM_INFO.SDP.SIMPLE_PRIM36.ram ;
  wire \DEVICE_7SERIES.NO_BMM_INFO.SDP.SIMPLE_PRIM36.ram_0 ;
  wire [13:0]\DEVICE_7SERIES.NO_BMM_INFO.SDP.SIMPLE_PRIM36.ram_1 ;
  wire [0:0]\DEVICE_7SERIES.NO_BMM_INFO.SDP.SIMPLE_PRIM36.ram_2 ;
  wire [1:0]\DEVICE_7SERIES.NO_BMM_INFO.SDP.SIMPLE_PRIM36.ram_3 ;
  wire \DEVICE_7SERIES.NO_BMM_INFO.SDP.SIMPLE_PRIM36.ram_4 ;
  wire \DEVICE_7SERIES.NO_BMM_INFO.SDP.SIMPLE_PRIM36.ram_5 ;
  wire [0:0]\DEVICE_7SERIES.NO_BMM_INFO.SDP.SIMPLE_PRIM36.ram_6 ;
  wire [13:0]Q;
  wire [1:0]WEA;
  wire clk;
  wire [31:0]din;
  wire [31:0]dout;
  wire [2:0]ena_array;
  wire [2:0]enb_array;
  wire out;
  wire \ramloop[10].ram.r_n_0 ;
  wire \ramloop[10].ram.r_n_1 ;
  wire \ramloop[10].ram.r_n_2 ;
  wire \ramloop[10].ram.r_n_3 ;
  wire \ramloop[10].ram.r_n_4 ;
  wire \ramloop[10].ram.r_n_5 ;
  wire \ramloop[10].ram.r_n_6 ;
  wire \ramloop[10].ram.r_n_7 ;
  wire \ramloop[10].ram.r_n_8 ;
  wire \ramloop[11].ram.r_n_0 ;
  wire \ramloop[11].ram.r_n_1 ;
  wire \ramloop[11].ram.r_n_2 ;
  wire \ramloop[11].ram.r_n_3 ;
  wire \ramloop[11].ram.r_n_4 ;
  wire \ramloop[11].ram.r_n_5 ;
  wire \ramloop[11].ram.r_n_6 ;
  wire \ramloop[11].ram.r_n_7 ;
  wire \ramloop[11].ram.r_n_8 ;
  wire \ramloop[12].ram.r_n_0 ;
  wire \ramloop[12].ram.r_n_1 ;
  wire \ramloop[12].ram.r_n_2 ;
  wire \ramloop[12].ram.r_n_3 ;
  wire \ramloop[12].ram.r_n_4 ;
  wire \ramloop[12].ram.r_n_5 ;
  wire \ramloop[12].ram.r_n_6 ;
  wire \ramloop[12].ram.r_n_7 ;
  wire \ramloop[12].ram.r_n_8 ;
  wire \ramloop[13].ram.r_n_0 ;
  wire \ramloop[13].ram.r_n_1 ;
  wire \ramloop[13].ram.r_n_2 ;
  wire \ramloop[13].ram.r_n_3 ;
  wire \ramloop[13].ram.r_n_4 ;
  wire \ramloop[13].ram.r_n_5 ;
  wire \ramloop[13].ram.r_n_6 ;
  wire \ramloop[13].ram.r_n_7 ;
  wire \ramloop[13].ram.r_n_8 ;
  wire \ramloop[14].ram.r_n_0 ;
  wire \ramloop[14].ram.r_n_1 ;
  wire \ramloop[14].ram.r_n_2 ;
  wire \ramloop[14].ram.r_n_3 ;
  wire \ramloop[14].ram.r_n_4 ;
  wire \ramloop[14].ram.r_n_5 ;
  wire \ramloop[14].ram.r_n_6 ;
  wire \ramloop[14].ram.r_n_7 ;
  wire \ramloop[14].ram.r_n_8 ;
  wire \ramloop[3].ram.r_n_0 ;
  wire \ramloop[3].ram.r_n_1 ;
  wire \ramloop[3].ram.r_n_2 ;
  wire \ramloop[3].ram.r_n_3 ;
  wire \ramloop[3].ram.r_n_4 ;
  wire \ramloop[3].ram.r_n_5 ;
  wire \ramloop[3].ram.r_n_6 ;
  wire \ramloop[3].ram.r_n_7 ;
  wire \ramloop[3].ram.r_n_8 ;
  wire \ramloop[4].ram.r_n_0 ;
  wire \ramloop[4].ram.r_n_1 ;
  wire \ramloop[4].ram.r_n_2 ;
  wire \ramloop[4].ram.r_n_3 ;
  wire \ramloop[4].ram.r_n_4 ;
  wire \ramloop[4].ram.r_n_5 ;
  wire \ramloop[4].ram.r_n_6 ;
  wire \ramloop[4].ram.r_n_7 ;
  wire \ramloop[4].ram.r_n_8 ;
  wire \ramloop[5].ram.r_n_0 ;
  wire \ramloop[5].ram.r_n_1 ;
  wire \ramloop[5].ram.r_n_2 ;
  wire \ramloop[5].ram.r_n_3 ;
  wire \ramloop[5].ram.r_n_4 ;
  wire \ramloop[5].ram.r_n_5 ;
  wire \ramloop[5].ram.r_n_6 ;
  wire \ramloop[5].ram.r_n_7 ;
  wire \ramloop[5].ram.r_n_8 ;
  wire \ramloop[6].ram.r_n_0 ;
  wire \ramloop[6].ram.r_n_1 ;
  wire \ramloop[6].ram.r_n_2 ;
  wire \ramloop[6].ram.r_n_3 ;
  wire \ramloop[6].ram.r_n_4 ;
  wire \ramloop[6].ram.r_n_5 ;
  wire \ramloop[6].ram.r_n_6 ;
  wire \ramloop[6].ram.r_n_7 ;
  wire \ramloop[6].ram.r_n_8 ;
  wire \ramloop[7].ram.r_n_0 ;
  wire \ramloop[7].ram.r_n_1 ;
  wire \ramloop[7].ram.r_n_2 ;
  wire \ramloop[7].ram.r_n_3 ;
  wire \ramloop[7].ram.r_n_4 ;
  wire \ramloop[7].ram.r_n_5 ;
  wire \ramloop[7].ram.r_n_6 ;
  wire \ramloop[7].ram.r_n_7 ;
  wire \ramloop[7].ram.r_n_8 ;
  wire \ramloop[8].ram.r_n_0 ;
  wire \ramloop[8].ram.r_n_1 ;
  wire \ramloop[8].ram.r_n_2 ;
  wire \ramloop[8].ram.r_n_3 ;
  wire \ramloop[8].ram.r_n_4 ;
  wire \ramloop[8].ram.r_n_5 ;
  wire \ramloop[8].ram.r_n_6 ;
  wire \ramloop[8].ram.r_n_7 ;
  wire \ramloop[8].ram.r_n_8 ;
  wire \ramloop[9].ram.r_n_0 ;
  wire \ramloop[9].ram.r_n_1 ;
  wire \ramloop[9].ram.r_n_2 ;
  wire \ramloop[9].ram.r_n_3 ;
  wire \ramloop[9].ram.r_n_4 ;
  wire \ramloop[9].ram.r_n_5 ;
  wire \ramloop[9].ram.r_n_6 ;
  wire \ramloop[9].ram.r_n_7 ;
  wire \ramloop[9].ram.r_n_8 ;
  wire rd_en;
  wire srst;

  fifo_32_blk_mem_gen_mux__parameterized0 \has_mux_b.B 
       (.DOBDO({\ramloop[13].ram.r_n_0 ,\ramloop[13].ram.r_n_1 ,\ramloop[13].ram.r_n_2 ,\ramloop[13].ram.r_n_3 ,\ramloop[13].ram.r_n_4 ,\ramloop[13].ram.r_n_5 ,\ramloop[13].ram.r_n_6 ,\ramloop[13].ram.r_n_7 }),
        .DOPBDOP(\ramloop[13].ram.r_n_8 ),
        .clk(clk),
        .dout(dout[31:5]),
        .\dout[12] ({\ramloop[5].ram.r_n_0 ,\ramloop[5].ram.r_n_1 ,\ramloop[5].ram.r_n_2 ,\ramloop[5].ram.r_n_3 ,\ramloop[5].ram.r_n_4 ,\ramloop[5].ram.r_n_5 ,\ramloop[5].ram.r_n_6 ,\ramloop[5].ram.r_n_7 }),
        .\dout[12]_0 ({\ramloop[6].ram.r_n_0 ,\ramloop[6].ram.r_n_1 ,\ramloop[6].ram.r_n_2 ,\ramloop[6].ram.r_n_3 ,\ramloop[6].ram.r_n_4 ,\ramloop[6].ram.r_n_5 ,\ramloop[6].ram.r_n_6 ,\ramloop[6].ram.r_n_7 }),
        .\dout[12]_1 ({\ramloop[3].ram.r_n_0 ,\ramloop[3].ram.r_n_1 ,\ramloop[3].ram.r_n_2 ,\ramloop[3].ram.r_n_3 ,\ramloop[3].ram.r_n_4 ,\ramloop[3].ram.r_n_5 ,\ramloop[3].ram.r_n_6 ,\ramloop[3].ram.r_n_7 }),
        .\dout[12]_2 ({\ramloop[4].ram.r_n_0 ,\ramloop[4].ram.r_n_1 ,\ramloop[4].ram.r_n_2 ,\ramloop[4].ram.r_n_3 ,\ramloop[4].ram.r_n_4 ,\ramloop[4].ram.r_n_5 ,\ramloop[4].ram.r_n_6 ,\ramloop[4].ram.r_n_7 }),
        .\dout[13] (\ramloop[5].ram.r_n_8 ),
        .\dout[13]_0 (\ramloop[6].ram.r_n_8 ),
        .\dout[13]_1 (\ramloop[3].ram.r_n_8 ),
        .\dout[13]_2 (\ramloop[4].ram.r_n_8 ),
        .\dout[21] ({\ramloop[9].ram.r_n_0 ,\ramloop[9].ram.r_n_1 ,\ramloop[9].ram.r_n_2 ,\ramloop[9].ram.r_n_3 ,\ramloop[9].ram.r_n_4 ,\ramloop[9].ram.r_n_5 ,\ramloop[9].ram.r_n_6 ,\ramloop[9].ram.r_n_7 }),
        .\dout[21]_0 ({\ramloop[10].ram.r_n_0 ,\ramloop[10].ram.r_n_1 ,\ramloop[10].ram.r_n_2 ,\ramloop[10].ram.r_n_3 ,\ramloop[10].ram.r_n_4 ,\ramloop[10].ram.r_n_5 ,\ramloop[10].ram.r_n_6 ,\ramloop[10].ram.r_n_7 }),
        .\dout[21]_1 ({\ramloop[7].ram.r_n_0 ,\ramloop[7].ram.r_n_1 ,\ramloop[7].ram.r_n_2 ,\ramloop[7].ram.r_n_3 ,\ramloop[7].ram.r_n_4 ,\ramloop[7].ram.r_n_5 ,\ramloop[7].ram.r_n_6 ,\ramloop[7].ram.r_n_7 }),
        .\dout[21]_2 ({\ramloop[8].ram.r_n_0 ,\ramloop[8].ram.r_n_1 ,\ramloop[8].ram.r_n_2 ,\ramloop[8].ram.r_n_3 ,\ramloop[8].ram.r_n_4 ,\ramloop[8].ram.r_n_5 ,\ramloop[8].ram.r_n_6 ,\ramloop[8].ram.r_n_7 }),
        .\dout[22] (\ramloop[9].ram.r_n_8 ),
        .\dout[22]_0 (\ramloop[10].ram.r_n_8 ),
        .\dout[22]_1 (\ramloop[7].ram.r_n_8 ),
        .\dout[22]_2 (\ramloop[8].ram.r_n_8 ),
        .\dout[30] ({\ramloop[14].ram.r_n_0 ,\ramloop[14].ram.r_n_1 ,\ramloop[14].ram.r_n_2 ,\ramloop[14].ram.r_n_3 ,\ramloop[14].ram.r_n_4 ,\ramloop[14].ram.r_n_5 ,\ramloop[14].ram.r_n_6 ,\ramloop[14].ram.r_n_7 }),
        .\dout[30]_0 ({\ramloop[11].ram.r_n_0 ,\ramloop[11].ram.r_n_1 ,\ramloop[11].ram.r_n_2 ,\ramloop[11].ram.r_n_3 ,\ramloop[11].ram.r_n_4 ,\ramloop[11].ram.r_n_5 ,\ramloop[11].ram.r_n_6 ,\ramloop[11].ram.r_n_7 }),
        .\dout[30]_1 ({\ramloop[12].ram.r_n_0 ,\ramloop[12].ram.r_n_1 ,\ramloop[12].ram.r_n_2 ,\ramloop[12].ram.r_n_3 ,\ramloop[12].ram.r_n_4 ,\ramloop[12].ram.r_n_5 ,\ramloop[12].ram.r_n_6 ,\ramloop[12].ram.r_n_7 }),
        .\dout[31] (\ramloop[14].ram.r_n_8 ),
        .\dout[31]_0 (\ramloop[11].ram.r_n_8 ),
        .\dout[31]_1 (\ramloop[12].ram.r_n_8 ),
        .\no_softecc_sel_reg.ce_pri.sel_pipe_reg[1]_0 (\DEVICE_7SERIES.NO_BMM_INFO.SDP.SIMPLE_PRIM36.ram_1 [13:12]),
        .out(out),
        .rd_en(rd_en),
        .srst(srst));
  fifo_32_blk_mem_gen_prim_width \ramloop[0].ram.r 
       (.\DEVICE_7SERIES.NO_BMM_INFO.SDP.SIMPLE_PRIM18.ram (\DEVICE_7SERIES.NO_BMM_INFO.SDP.SIMPLE_PRIM36.ram ),
        .\DEVICE_7SERIES.NO_BMM_INFO.SDP.SIMPLE_PRIM18.ram_0 (\DEVICE_7SERIES.NO_BMM_INFO.SDP.SIMPLE_PRIM36.ram_0 ),
        .\DEVICE_7SERIES.NO_BMM_INFO.SDP.SIMPLE_PRIM18.ram_1 (\DEVICE_7SERIES.NO_BMM_INFO.SDP.SIMPLE_PRIM36.ram_1 ),
        .\DEVICE_7SERIES.NO_BMM_INFO.SDP.SIMPLE_PRIM18.ram_2 (\DEVICE_7SERIES.NO_BMM_INFO.SDP.SIMPLE_PRIM36.ram_2 ),
        .Q(Q),
        .clk(clk),
        .din(din[0]),
        .dout(dout[0]),
        .srst(srst));
  fifo_32_blk_mem_gen_prim_width__parameterized9 \ramloop[10].ram.r 
       (.\DEVICE_7SERIES.NO_BMM_INFO.SDP.SIMPLE_PRIM36.ram ({\ramloop[10].ram.r_n_0 ,\ramloop[10].ram.r_n_1 ,\ramloop[10].ram.r_n_2 ,\ramloop[10].ram.r_n_3 ,\ramloop[10].ram.r_n_4 ,\ramloop[10].ram.r_n_5 ,\ramloop[10].ram.r_n_6 ,\ramloop[10].ram.r_n_7 }),
        .\DEVICE_7SERIES.NO_BMM_INFO.SDP.SIMPLE_PRIM36.ram_0 (\ramloop[10].ram.r_n_8 ),
        .\DEVICE_7SERIES.NO_BMM_INFO.SDP.SIMPLE_PRIM36.ram_1 (\DEVICE_7SERIES.NO_BMM_INFO.SDP.SIMPLE_PRIM36.ram_4 ),
        .\DEVICE_7SERIES.NO_BMM_INFO.SDP.SIMPLE_PRIM36.ram_2 (\DEVICE_7SERIES.NO_BMM_INFO.SDP.SIMPLE_PRIM36.ram_5 ),
        .\DEVICE_7SERIES.NO_BMM_INFO.SDP.SIMPLE_PRIM36.ram_3 (\DEVICE_7SERIES.NO_BMM_INFO.SDP.SIMPLE_PRIM36.ram_1 [11:0]),
        .Q(Q[11:0]),
        .WEA(WEA),
        .clk(clk),
        .din(din[22:14]),
        .srst(srst));
  fifo_32_blk_mem_gen_prim_width__parameterized10 \ramloop[11].ram.r 
       (.\DEVICE_7SERIES.NO_BMM_INFO.SDP.SIMPLE_PRIM36.ram ({\ramloop[11].ram.r_n_0 ,\ramloop[11].ram.r_n_1 ,\ramloop[11].ram.r_n_2 ,\ramloop[11].ram.r_n_3 ,\ramloop[11].ram.r_n_4 ,\ramloop[11].ram.r_n_5 ,\ramloop[11].ram.r_n_6 ,\ramloop[11].ram.r_n_7 }),
        .\DEVICE_7SERIES.NO_BMM_INFO.SDP.SIMPLE_PRIM36.ram_0 (\ramloop[11].ram.r_n_8 ),
        .\DEVICE_7SERIES.NO_BMM_INFO.SDP.SIMPLE_PRIM36.ram_1 (\DEVICE_7SERIES.NO_BMM_INFO.SDP.SIMPLE_PRIM36.ram_1 [11:0]),
        .\DEVICE_7SERIES.NO_BMM_INFO.SDP.SIMPLE_PRIM36.ram_2 (\DEVICE_7SERIES.NO_BMM_INFO.SDP.SIMPLE_PRIM36.ram_6 ),
        .Q(Q[11:0]),
        .clk(clk),
        .din(din[31:23]),
        .ena_array(ena_array[0]),
        .enb_array(enb_array[0]),
        .srst(srst));
  fifo_32_blk_mem_gen_prim_width__parameterized11 \ramloop[12].ram.r 
       (.\DEVICE_7SERIES.NO_BMM_INFO.SDP.SIMPLE_PRIM36.ram ({\ramloop[12].ram.r_n_0 ,\ramloop[12].ram.r_n_1 ,\ramloop[12].ram.r_n_2 ,\ramloop[12].ram.r_n_3 ,\ramloop[12].ram.r_n_4 ,\ramloop[12].ram.r_n_5 ,\ramloop[12].ram.r_n_6 ,\ramloop[12].ram.r_n_7 }),
        .\DEVICE_7SERIES.NO_BMM_INFO.SDP.SIMPLE_PRIM36.ram_0 (\ramloop[12].ram.r_n_8 ),
        .\DEVICE_7SERIES.NO_BMM_INFO.SDP.SIMPLE_PRIM36.ram_1 (\DEVICE_7SERIES.NO_BMM_INFO.SDP.SIMPLE_PRIM36.ram_1 [11:0]),
        .Q(Q[11:0]),
        .WEA(WEA[0]),
        .clk(clk),
        .din(din[31:23]),
        .ena_array(ena_array[1]),
        .enb_array(enb_array[1]),
        .srst(srst));
  fifo_32_blk_mem_gen_prim_width__parameterized12 \ramloop[13].ram.r 
       (.\DEVICE_7SERIES.NO_BMM_INFO.SDP.SIMPLE_PRIM36.ram (\DEVICE_7SERIES.NO_BMM_INFO.SDP.SIMPLE_PRIM36.ram_1 [11:0]),
        .\DEVICE_7SERIES.NO_BMM_INFO.SDP.SIMPLE_PRIM36.ram_0 (\DEVICE_7SERIES.NO_BMM_INFO.SDP.SIMPLE_PRIM36.ram_6 ),
        .DOBDO({\ramloop[13].ram.r_n_0 ,\ramloop[13].ram.r_n_1 ,\ramloop[13].ram.r_n_2 ,\ramloop[13].ram.r_n_3 ,\ramloop[13].ram.r_n_4 ,\ramloop[13].ram.r_n_5 ,\ramloop[13].ram.r_n_6 ,\ramloop[13].ram.r_n_7 }),
        .DOPBDOP(\ramloop[13].ram.r_n_8 ),
        .Q(Q[11:0]),
        .clk(clk),
        .din(din[31:23]),
        .ena_array(ena_array[2]),
        .enb_array(enb_array[2]),
        .srst(srst));
  fifo_32_blk_mem_gen_prim_width__parameterized13 \ramloop[14].ram.r 
       (.\DEVICE_7SERIES.NO_BMM_INFO.SDP.SIMPLE_PRIM36.ram ({\ramloop[14].ram.r_n_0 ,\ramloop[14].ram.r_n_1 ,\ramloop[14].ram.r_n_2 ,\ramloop[14].ram.r_n_3 ,\ramloop[14].ram.r_n_4 ,\ramloop[14].ram.r_n_5 ,\ramloop[14].ram.r_n_6 ,\ramloop[14].ram.r_n_7 }),
        .\DEVICE_7SERIES.NO_BMM_INFO.SDP.SIMPLE_PRIM36.ram_0 (\ramloop[14].ram.r_n_8 ),
        .\DEVICE_7SERIES.NO_BMM_INFO.SDP.SIMPLE_PRIM36.ram_1 (\DEVICE_7SERIES.NO_BMM_INFO.SDP.SIMPLE_PRIM36.ram_4 ),
        .\DEVICE_7SERIES.NO_BMM_INFO.SDP.SIMPLE_PRIM36.ram_2 (\DEVICE_7SERIES.NO_BMM_INFO.SDP.SIMPLE_PRIM36.ram_5 ),
        .\DEVICE_7SERIES.NO_BMM_INFO.SDP.SIMPLE_PRIM36.ram_3 (\DEVICE_7SERIES.NO_BMM_INFO.SDP.SIMPLE_PRIM36.ram_1 [11:0]),
        .Q(Q[11:0]),
        .WEA(WEA[0]),
        .clk(clk),
        .din(din[31:23]),
        .srst(srst));
  fifo_32_blk_mem_gen_prim_width__parameterized0 \ramloop[1].ram.r 
       (.\DEVICE_7SERIES.NO_BMM_INFO.SDP.SIMPLE_PRIM36.ram (\DEVICE_7SERIES.NO_BMM_INFO.SDP.SIMPLE_PRIM36.ram ),
        .\DEVICE_7SERIES.NO_BMM_INFO.SDP.SIMPLE_PRIM36.ram_0 (\DEVICE_7SERIES.NO_BMM_INFO.SDP.SIMPLE_PRIM36.ram_0 ),
        .\DEVICE_7SERIES.NO_BMM_INFO.SDP.SIMPLE_PRIM36.ram_1 (\DEVICE_7SERIES.NO_BMM_INFO.SDP.SIMPLE_PRIM36.ram_1 ),
        .\DEVICE_7SERIES.NO_BMM_INFO.SDP.SIMPLE_PRIM36.ram_2 (\DEVICE_7SERIES.NO_BMM_INFO.SDP.SIMPLE_PRIM36.ram_3 [1]),
        .Q(Q),
        .clk(clk),
        .din(din[2:1]),
        .dout(dout[2:1]),
        .srst(srst));
  fifo_32_blk_mem_gen_prim_width__parameterized1 \ramloop[2].ram.r 
       (.\DEVICE_7SERIES.NO_BMM_INFO.SDP.SIMPLE_PRIM36.ram (\DEVICE_7SERIES.NO_BMM_INFO.SDP.SIMPLE_PRIM36.ram ),
        .\DEVICE_7SERIES.NO_BMM_INFO.SDP.SIMPLE_PRIM36.ram_0 (\DEVICE_7SERIES.NO_BMM_INFO.SDP.SIMPLE_PRIM36.ram_0 ),
        .\DEVICE_7SERIES.NO_BMM_INFO.SDP.SIMPLE_PRIM36.ram_1 (\DEVICE_7SERIES.NO_BMM_INFO.SDP.SIMPLE_PRIM36.ram_1 ),
        .\DEVICE_7SERIES.NO_BMM_INFO.SDP.SIMPLE_PRIM36.ram_2 (\DEVICE_7SERIES.NO_BMM_INFO.SDP.SIMPLE_PRIM36.ram_2 ),
        .Q(Q),
        .clk(clk),
        .din(din[4:3]),
        .dout(dout[4:3]),
        .srst(srst));
  fifo_32_blk_mem_gen_prim_width__parameterized2 \ramloop[3].ram.r 
       (.\DEVICE_7SERIES.NO_BMM_INFO.SDP.SIMPLE_PRIM36.ram ({\ramloop[3].ram.r_n_0 ,\ramloop[3].ram.r_n_1 ,\ramloop[3].ram.r_n_2 ,\ramloop[3].ram.r_n_3 ,\ramloop[3].ram.r_n_4 ,\ramloop[3].ram.r_n_5 ,\ramloop[3].ram.r_n_6 ,\ramloop[3].ram.r_n_7 }),
        .\DEVICE_7SERIES.NO_BMM_INFO.SDP.SIMPLE_PRIM36.ram_0 (\ramloop[3].ram.r_n_8 ),
        .\DEVICE_7SERIES.NO_BMM_INFO.SDP.SIMPLE_PRIM36.ram_1 (\DEVICE_7SERIES.NO_BMM_INFO.SDP.SIMPLE_PRIM36.ram_1 [11:0]),
        .\DEVICE_7SERIES.NO_BMM_INFO.SDP.SIMPLE_PRIM36.ram_2 (\DEVICE_7SERIES.NO_BMM_INFO.SDP.SIMPLE_PRIM36.ram_3 [1]),
        .Q(Q[11:0]),
        .clk(clk),
        .din(din[13:5]),
        .ena_array(ena_array[0]),
        .enb_array(enb_array[0]),
        .srst(srst));
  fifo_32_blk_mem_gen_prim_width__parameterized3 \ramloop[4].ram.r 
       (.\DEVICE_7SERIES.NO_BMM_INFO.SDP.SIMPLE_PRIM36.ram ({\ramloop[4].ram.r_n_0 ,\ramloop[4].ram.r_n_1 ,\ramloop[4].ram.r_n_2 ,\ramloop[4].ram.r_n_3 ,\ramloop[4].ram.r_n_4 ,\ramloop[4].ram.r_n_5 ,\ramloop[4].ram.r_n_6 ,\ramloop[4].ram.r_n_7 }),
        .\DEVICE_7SERIES.NO_BMM_INFO.SDP.SIMPLE_PRIM36.ram_0 (\ramloop[4].ram.r_n_8 ),
        .\DEVICE_7SERIES.NO_BMM_INFO.SDP.SIMPLE_PRIM36.ram_1 (\DEVICE_7SERIES.NO_BMM_INFO.SDP.SIMPLE_PRIM36.ram_1 [11:0]),
        .\DEVICE_7SERIES.NO_BMM_INFO.SDP.SIMPLE_PRIM36.ram_2 (\DEVICE_7SERIES.NO_BMM_INFO.SDP.SIMPLE_PRIM36.ram_2 ),
        .Q(Q[11:0]),
        .clk(clk),
        .din(din[13:5]),
        .ena_array(ena_array[1]),
        .enb_array(enb_array[1]),
        .srst(srst));
  fifo_32_blk_mem_gen_prim_width__parameterized4 \ramloop[5].ram.r 
       (.\DEVICE_7SERIES.NO_BMM_INFO.SDP.SIMPLE_PRIM36.ram ({\ramloop[5].ram.r_n_0 ,\ramloop[5].ram.r_n_1 ,\ramloop[5].ram.r_n_2 ,\ramloop[5].ram.r_n_3 ,\ramloop[5].ram.r_n_4 ,\ramloop[5].ram.r_n_5 ,\ramloop[5].ram.r_n_6 ,\ramloop[5].ram.r_n_7 }),
        .\DEVICE_7SERIES.NO_BMM_INFO.SDP.SIMPLE_PRIM36.ram_0 (\ramloop[5].ram.r_n_8 ),
        .\DEVICE_7SERIES.NO_BMM_INFO.SDP.SIMPLE_PRIM36.ram_1 (\DEVICE_7SERIES.NO_BMM_INFO.SDP.SIMPLE_PRIM36.ram_1 [11:0]),
        .\DEVICE_7SERIES.NO_BMM_INFO.SDP.SIMPLE_PRIM36.ram_2 (\DEVICE_7SERIES.NO_BMM_INFO.SDP.SIMPLE_PRIM36.ram_3 ),
        .Q(Q[11:0]),
        .clk(clk),
        .din(din[13:5]),
        .ena_array(ena_array[2]),
        .enb_array(enb_array[2]),
        .srst(srst));
  fifo_32_blk_mem_gen_prim_width__parameterized5 \ramloop[6].ram.r 
       (.\DEVICE_7SERIES.NO_BMM_INFO.SDP.SIMPLE_PRIM36.ram ({\ramloop[6].ram.r_n_0 ,\ramloop[6].ram.r_n_1 ,\ramloop[6].ram.r_n_2 ,\ramloop[6].ram.r_n_3 ,\ramloop[6].ram.r_n_4 ,\ramloop[6].ram.r_n_5 ,\ramloop[6].ram.r_n_6 ,\ramloop[6].ram.r_n_7 }),
        .\DEVICE_7SERIES.NO_BMM_INFO.SDP.SIMPLE_PRIM36.ram_0 (\ramloop[6].ram.r_n_8 ),
        .\DEVICE_7SERIES.NO_BMM_INFO.SDP.SIMPLE_PRIM36.ram_1 (\DEVICE_7SERIES.NO_BMM_INFO.SDP.SIMPLE_PRIM36.ram_4 ),
        .\DEVICE_7SERIES.NO_BMM_INFO.SDP.SIMPLE_PRIM36.ram_2 (\DEVICE_7SERIES.NO_BMM_INFO.SDP.SIMPLE_PRIM36.ram_5 ),
        .\DEVICE_7SERIES.NO_BMM_INFO.SDP.SIMPLE_PRIM36.ram_3 (\DEVICE_7SERIES.NO_BMM_INFO.SDP.SIMPLE_PRIM36.ram_1 [11:0]),
        .Q(Q[11:0]),
        .WEA(WEA[1]),
        .clk(clk),
        .din(din[13:5]),
        .srst(srst));
  fifo_32_blk_mem_gen_prim_width__parameterized6 \ramloop[7].ram.r 
       (.\DEVICE_7SERIES.NO_BMM_INFO.SDP.SIMPLE_PRIM36.ram ({\ramloop[7].ram.r_n_0 ,\ramloop[7].ram.r_n_1 ,\ramloop[7].ram.r_n_2 ,\ramloop[7].ram.r_n_3 ,\ramloop[7].ram.r_n_4 ,\ramloop[7].ram.r_n_5 ,\ramloop[7].ram.r_n_6 ,\ramloop[7].ram.r_n_7 }),
        .\DEVICE_7SERIES.NO_BMM_INFO.SDP.SIMPLE_PRIM36.ram_0 (\ramloop[7].ram.r_n_8 ),
        .\DEVICE_7SERIES.NO_BMM_INFO.SDP.SIMPLE_PRIM36.ram_1 (\DEVICE_7SERIES.NO_BMM_INFO.SDP.SIMPLE_PRIM36.ram_1 [11:0]),
        .\DEVICE_7SERIES.NO_BMM_INFO.SDP.SIMPLE_PRIM36.ram_2 (\DEVICE_7SERIES.NO_BMM_INFO.SDP.SIMPLE_PRIM36.ram_3 [0]),
        .Q(Q[11:0]),
        .clk(clk),
        .din(din[22:14]),
        .ena_array(ena_array[0]),
        .enb_array(enb_array[0]),
        .srst(srst));
  fifo_32_blk_mem_gen_prim_width__parameterized7 \ramloop[8].ram.r 
       (.\DEVICE_7SERIES.NO_BMM_INFO.SDP.SIMPLE_PRIM36.ram ({\ramloop[8].ram.r_n_0 ,\ramloop[8].ram.r_n_1 ,\ramloop[8].ram.r_n_2 ,\ramloop[8].ram.r_n_3 ,\ramloop[8].ram.r_n_4 ,\ramloop[8].ram.r_n_5 ,\ramloop[8].ram.r_n_6 ,\ramloop[8].ram.r_n_7 }),
        .\DEVICE_7SERIES.NO_BMM_INFO.SDP.SIMPLE_PRIM36.ram_0 (\ramloop[8].ram.r_n_8 ),
        .\DEVICE_7SERIES.NO_BMM_INFO.SDP.SIMPLE_PRIM36.ram_1 (\DEVICE_7SERIES.NO_BMM_INFO.SDP.SIMPLE_PRIM36.ram_1 [11:0]),
        .Q(Q[11:0]),
        .WEA(WEA[1]),
        .clk(clk),
        .din(din[22:14]),
        .ena_array(ena_array[1]),
        .enb_array(enb_array[1]),
        .srst(srst));
  fifo_32_blk_mem_gen_prim_width__parameterized8 \ramloop[9].ram.r 
       (.\DEVICE_7SERIES.NO_BMM_INFO.SDP.SIMPLE_PRIM36.ram ({\ramloop[9].ram.r_n_0 ,\ramloop[9].ram.r_n_1 ,\ramloop[9].ram.r_n_2 ,\ramloop[9].ram.r_n_3 ,\ramloop[9].ram.r_n_4 ,\ramloop[9].ram.r_n_5 ,\ramloop[9].ram.r_n_6 ,\ramloop[9].ram.r_n_7 }),
        .\DEVICE_7SERIES.NO_BMM_INFO.SDP.SIMPLE_PRIM36.ram_0 (\ramloop[9].ram.r_n_8 ),
        .\DEVICE_7SERIES.NO_BMM_INFO.SDP.SIMPLE_PRIM36.ram_1 (\DEVICE_7SERIES.NO_BMM_INFO.SDP.SIMPLE_PRIM36.ram_1 [11:0]),
        .\DEVICE_7SERIES.NO_BMM_INFO.SDP.SIMPLE_PRIM36.ram_2 (\DEVICE_7SERIES.NO_BMM_INFO.SDP.SIMPLE_PRIM36.ram_3 [0]),
        .Q(Q[11:0]),
        .clk(clk),
        .din(din[22:14]),
        .ena_array(ena_array[2]),
        .enb_array(enb_array[2]),
        .srst(srst));
endmodule

(* ORIG_REF_NAME = "blk_mem_gen_mux" *) 
module fifo_32_blk_mem_gen_mux__parameterized0
   (dout,
    \no_softecc_sel_reg.ce_pri.sel_pipe_reg[1]_0 ,
    out,
    rd_en,
    srst,
    clk,
    DOPBDOP,
    \dout[31] ,
    \dout[31]_0 ,
    \dout[31]_1 ,
    DOBDO,
    \dout[30] ,
    \dout[30]_0 ,
    \dout[30]_1 ,
    \dout[22] ,
    \dout[22]_0 ,
    \dout[22]_1 ,
    \dout[22]_2 ,
    \dout[21] ,
    \dout[21]_0 ,
    \dout[21]_1 ,
    \dout[21]_2 ,
    \dout[13] ,
    \dout[13]_0 ,
    \dout[13]_1 ,
    \dout[13]_2 ,
    \dout[12] ,
    \dout[12]_0 ,
    \dout[12]_1 ,
    \dout[12]_2 );
  output [26:0]dout;
  input [1:0]\no_softecc_sel_reg.ce_pri.sel_pipe_reg[1]_0 ;
  input out;
  input rd_en;
  input srst;
  input clk;
  input [0:0]DOPBDOP;
  input [0:0]\dout[31] ;
  input [0:0]\dout[31]_0 ;
  input [0:0]\dout[31]_1 ;
  input [7:0]DOBDO;
  input [7:0]\dout[30] ;
  input [7:0]\dout[30]_0 ;
  input [7:0]\dout[30]_1 ;
  input [0:0]\dout[22] ;
  input [0:0]\dout[22]_0 ;
  input [0:0]\dout[22]_1 ;
  input [0:0]\dout[22]_2 ;
  input [7:0]\dout[21] ;
  input [7:0]\dout[21]_0 ;
  input [7:0]\dout[21]_1 ;
  input [7:0]\dout[21]_2 ;
  input [0:0]\dout[13] ;
  input [0:0]\dout[13]_0 ;
  input [0:0]\dout[13]_1 ;
  input [0:0]\dout[13]_2 ;
  input [7:0]\dout[12] ;
  input [7:0]\dout[12]_0 ;
  input [7:0]\dout[12]_1 ;
  input [7:0]\dout[12]_2 ;

  wire [7:0]DOBDO;
  wire [0:0]DOPBDOP;
  wire clk;
  wire [26:0]dout;
  wire [7:0]\dout[12] ;
  wire [7:0]\dout[12]_0 ;
  wire [7:0]\dout[12]_1 ;
  wire [7:0]\dout[12]_2 ;
  wire [0:0]\dout[13] ;
  wire [0:0]\dout[13]_0 ;
  wire [0:0]\dout[13]_1 ;
  wire [0:0]\dout[13]_2 ;
  wire [7:0]\dout[21] ;
  wire [7:0]\dout[21]_0 ;
  wire [7:0]\dout[21]_1 ;
  wire [7:0]\dout[21]_2 ;
  wire [0:0]\dout[22] ;
  wire [0:0]\dout[22]_0 ;
  wire [0:0]\dout[22]_1 ;
  wire [0:0]\dout[22]_2 ;
  wire [7:0]\dout[30] ;
  wire [7:0]\dout[30]_0 ;
  wire [7:0]\dout[30]_1 ;
  wire [0:0]\dout[31] ;
  wire [0:0]\dout[31]_0 ;
  wire [0:0]\dout[31]_1 ;
  wire \no_softecc_sel_reg.ce_pri.sel_pipe[0]_i_1_n_0 ;
  wire \no_softecc_sel_reg.ce_pri.sel_pipe[1]_i_1_n_0 ;
  wire [1:0]\no_softecc_sel_reg.ce_pri.sel_pipe_reg[1]_0 ;
  wire out;
  wire rd_en;
  wire [1:0]sel_pipe;
  wire srst;

  LUT6 #(
    .INIT(64'hCCFFAAF0CC00AAF0)) 
    \dout[10]_INST_0 
       (.I0(\dout[12] [5]),
        .I1(\dout[12]_0 [5]),
        .I2(\dout[12]_1 [5]),
        .I3(sel_pipe[1]),
        .I4(sel_pipe[0]),
        .I5(\dout[12]_2 [5]),
        .O(dout[5]));
  LUT6 #(
    .INIT(64'hCCFFAAF0CC00AAF0)) 
    \dout[11]_INST_0 
       (.I0(\dout[12] [6]),
        .I1(\dout[12]_0 [6]),
        .I2(\dout[12]_1 [6]),
        .I3(sel_pipe[1]),
        .I4(sel_pipe[0]),
        .I5(\dout[12]_2 [6]),
        .O(dout[6]));
  LUT6 #(
    .INIT(64'hCCFFAAF0CC00AAF0)) 
    \dout[12]_INST_0 
       (.I0(\dout[12] [7]),
        .I1(\dout[12]_0 [7]),
        .I2(\dout[12]_1 [7]),
        .I3(sel_pipe[1]),
        .I4(sel_pipe[0]),
        .I5(\dout[12]_2 [7]),
        .O(dout[7]));
  LUT6 #(
    .INIT(64'hCCFFAAF0CC00AAF0)) 
    \dout[13]_INST_0 
       (.I0(\dout[13] ),
        .I1(\dout[13]_0 ),
        .I2(\dout[13]_1 ),
        .I3(sel_pipe[1]),
        .I4(sel_pipe[0]),
        .I5(\dout[13]_2 ),
        .O(dout[8]));
  LUT6 #(
    .INIT(64'hCCFFAAF0CC00AAF0)) 
    \dout[14]_INST_0 
       (.I0(\dout[21] [0]),
        .I1(\dout[21]_0 [0]),
        .I2(\dout[21]_1 [0]),
        .I3(sel_pipe[1]),
        .I4(sel_pipe[0]),
        .I5(\dout[21]_2 [0]),
        .O(dout[9]));
  LUT6 #(
    .INIT(64'hCCFFAAF0CC00AAF0)) 
    \dout[15]_INST_0 
       (.I0(\dout[21] [1]),
        .I1(\dout[21]_0 [1]),
        .I2(\dout[21]_1 [1]),
        .I3(sel_pipe[1]),
        .I4(sel_pipe[0]),
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
        .I1(\dout[12]_0 [0]),
        .I2(\dout[12]_1 [0]),
        .I3(sel_pipe[1]),
        .I4(sel_pipe[0]),
        .I5(\dout[12]_2 [0]),
        .O(dout[0]));
  LUT6 #(
    .INIT(64'hCCFFAAF0CC00AAF0)) 
    \dout[6]_INST_0 
       (.I0(\dout[12] [1]),
        .I1(\dout[12]_0 [1]),
        .I2(\dout[12]_1 [1]),
        .I3(sel_pipe[1]),
        .I4(sel_pipe[0]),
        .I5(\dout[12]_2 [1]),
        .O(dout[1]));
  LUT6 #(
    .INIT(64'hCCFFAAF0CC00AAF0)) 
    \dout[7]_INST_0 
       (.I0(\dout[12] [2]),
        .I1(\dout[12]_0 [2]),
        .I2(\dout[12]_1 [2]),
        .I3(sel_pipe[1]),
        .I4(sel_pipe[0]),
        .I5(\dout[12]_2 [2]),
        .O(dout[2]));
  LUT6 #(
    .INIT(64'hCCFFAAF0CC00AAF0)) 
    \dout[8]_INST_0 
       (.I0(\dout[12] [3]),
        .I1(\dout[12]_0 [3]),
        .I2(\dout[12]_1 [3]),
        .I3(sel_pipe[1]),
        .I4(sel_pipe[0]),
        .I5(\dout[12]_2 [3]),
        .O(dout[3]));
  LUT6 #(
    .INIT(64'hCCFFAAF0CC00AAF0)) 
    \dout[9]_INST_0 
       (.I0(\dout[12] [4]),
        .I1(\dout[12]_0 [4]),
        .I2(\dout[12]_1 [4]),
        .I3(sel_pipe[1]),
        .I4(sel_pipe[0]),
        .I5(\dout[12]_2 [4]),
        .O(dout[4]));
  LUT5 #(
    .INIT(32'hAAEFAA20)) 
    \no_softecc_sel_reg.ce_pri.sel_pipe[0]_i_1 
       (.I0(\no_softecc_sel_reg.ce_pri.sel_pipe_reg[1]_0 [0]),
        .I1(out),
        .I2(rd_en),
        .I3(srst),
        .I4(sel_pipe[0]),
        .O(\no_softecc_sel_reg.ce_pri.sel_pipe[0]_i_1_n_0 ));
  LUT5 #(
    .INIT(32'hAAEFAA20)) 
    \no_softecc_sel_reg.ce_pri.sel_pipe[1]_i_1 
       (.I0(\no_softecc_sel_reg.ce_pri.sel_pipe_reg[1]_0 [1]),
        .I1(out),
        .I2(rd_en),
        .I3(srst),
        .I4(sel_pipe[1]),
        .O(\no_softecc_sel_reg.ce_pri.sel_pipe[1]_i_1_n_0 ));
  FDRE #(
    .INIT(1'b0)) 
    \no_softecc_sel_reg.ce_pri.sel_pipe_reg[0] 
       (.C(clk),
        .CE(1'b1),
        .D(\no_softecc_sel_reg.ce_pri.sel_pipe[0]_i_1_n_0 ),
        .Q(sel_pipe[0]),
        .R(1'b0));
  FDRE #(
    .INIT(1'b0)) 
    \no_softecc_sel_reg.ce_pri.sel_pipe_reg[1] 
       (.C(clk),
        .CE(1'b1),
        .D(\no_softecc_sel_reg.ce_pri.sel_pipe[1]_i_1_n_0 ),
        .Q(sel_pipe[1]),
        .R(1'b0));
endmodule

(* ORIG_REF_NAME = "blk_mem_gen_prim_width" *) 
module fifo_32_blk_mem_gen_prim_width
   (dout,
    clk,
    \DEVICE_7SERIES.NO_BMM_INFO.SDP.SIMPLE_PRIM18.ram ,
    \DEVICE_7SERIES.NO_BMM_INFO.SDP.SIMPLE_PRIM18.ram_0 ,
    srst,
    Q,
    \DEVICE_7SERIES.NO_BMM_INFO.SDP.SIMPLE_PRIM18.ram_1 ,
    din,
    \DEVICE_7SERIES.NO_BMM_INFO.SDP.SIMPLE_PRIM18.ram_2 );
  output [0:0]dout;
  input clk;
  input \DEVICE_7SERIES.NO_BMM_INFO.SDP.SIMPLE_PRIM18.ram ;
  input \DEVICE_7SERIES.NO_BMM_INFO.SDP.SIMPLE_PRIM18.ram_0 ;
  input srst;
  input [13:0]Q;
  input [13:0]\DEVICE_7SERIES.NO_BMM_INFO.SDP.SIMPLE_PRIM18.ram_1 ;
  input [0:0]din;
  input [0:0]\DEVICE_7SERIES.NO_BMM_INFO.SDP.SIMPLE_PRIM18.ram_2 ;

  wire \DEVICE_7SERIES.NO_BMM_INFO.SDP.SIMPLE_PRIM18.ram ;
  wire \DEVICE_7SERIES.NO_BMM_INFO.SDP.SIMPLE_PRIM18.ram_0 ;
  wire [13:0]\DEVICE_7SERIES.NO_BMM_INFO.SDP.SIMPLE_PRIM18.ram_1 ;
  wire [0:0]\DEVICE_7SERIES.NO_BMM_INFO.SDP.SIMPLE_PRIM18.ram_2 ;
  wire [13:0]Q;
  wire clk;
  wire [0:0]din;
  wire [0:0]dout;
  wire srst;

  fifo_32_blk_mem_gen_prim_wrapper \prim_noinit.ram 
       (.\DEVICE_7SERIES.NO_BMM_INFO.SDP.SIMPLE_PRIM18.ram_0 (\DEVICE_7SERIES.NO_BMM_INFO.SDP.SIMPLE_PRIM18.ram ),
        .\DEVICE_7SERIES.NO_BMM_INFO.SDP.SIMPLE_PRIM18.ram_1 (\DEVICE_7SERIES.NO_BMM_INFO.SDP.SIMPLE_PRIM18.ram_0 ),
        .\DEVICE_7SERIES.NO_BMM_INFO.SDP.SIMPLE_PRIM18.ram_2 (\DEVICE_7SERIES.NO_BMM_INFO.SDP.SIMPLE_PRIM18.ram_1 ),
        .\DEVICE_7SERIES.NO_BMM_INFO.SDP.SIMPLE_PRIM18.ram_3 (\DEVICE_7SERIES.NO_BMM_INFO.SDP.SIMPLE_PRIM18.ram_2 ),
        .Q(Q),
        .clk(clk),
        .din(din),
        .dout(dout),
        .srst(srst));
endmodule

(* ORIG_REF_NAME = "blk_mem_gen_prim_width" *) 
module fifo_32_blk_mem_gen_prim_width__parameterized0
   (dout,
    clk,
    \DEVICE_7SERIES.NO_BMM_INFO.SDP.SIMPLE_PRIM36.ram ,
    \DEVICE_7SERIES.NO_BMM_INFO.SDP.SIMPLE_PRIM36.ram_0 ,
    srst,
    Q,
    \DEVICE_7SERIES.NO_BMM_INFO.SDP.SIMPLE_PRIM36.ram_1 ,
    din,
    \DEVICE_7SERIES.NO_BMM_INFO.SDP.SIMPLE_PRIM36.ram_2 );
  output [1:0]dout;
  input clk;
  input \DEVICE_7SERIES.NO_BMM_INFO.SDP.SIMPLE_PRIM36.ram ;
  input \DEVICE_7SERIES.NO_BMM_INFO.SDP.SIMPLE_PRIM36.ram_0 ;
  input srst;
  input [13:0]Q;
  input [13:0]\DEVICE_7SERIES.NO_BMM_INFO.SDP.SIMPLE_PRIM36.ram_1 ;
  input [1:0]din;
  input [0:0]\DEVICE_7SERIES.NO_BMM_INFO.SDP.SIMPLE_PRIM36.ram_2 ;

  wire \DEVICE_7SERIES.NO_BMM_INFO.SDP.SIMPLE_PRIM36.ram ;
  wire \DEVICE_7SERIES.NO_BMM_INFO.SDP.SIMPLE_PRIM36.ram_0 ;
  wire [13:0]\DEVICE_7SERIES.NO_BMM_INFO.SDP.SIMPLE_PRIM36.ram_1 ;
  wire [0:0]\DEVICE_7SERIES.NO_BMM_INFO.SDP.SIMPLE_PRIM36.ram_2 ;
  wire [13:0]Q;
  wire clk;
  wire [1:0]din;
  wire [1:0]dout;
  wire srst;

  fifo_32_blk_mem_gen_prim_wrapper__parameterized0 \prim_noinit.ram 
       (.\DEVICE_7SERIES.NO_BMM_INFO.SDP.SIMPLE_PRIM36.ram_0 (\DEVICE_7SERIES.NO_BMM_INFO.SDP.SIMPLE_PRIM36.ram ),
        .\DEVICE_7SERIES.NO_BMM_INFO.SDP.SIMPLE_PRIM36.ram_1 (\DEVICE_7SERIES.NO_BMM_INFO.SDP.SIMPLE_PRIM36.ram_0 ),
        .\DEVICE_7SERIES.NO_BMM_INFO.SDP.SIMPLE_PRIM36.ram_2 (\DEVICE_7SERIES.NO_BMM_INFO.SDP.SIMPLE_PRIM36.ram_1 ),
        .\DEVICE_7SERIES.NO_BMM_INFO.SDP.SIMPLE_PRIM36.ram_3 (\DEVICE_7SERIES.NO_BMM_INFO.SDP.SIMPLE_PRIM36.ram_2 ),
        .Q(Q),
        .clk(clk),
        .din(din),
        .dout(dout),
        .srst(srst));
endmodule

(* ORIG_REF_NAME = "blk_mem_gen_prim_width" *) 
module fifo_32_blk_mem_gen_prim_width__parameterized1
   (dout,
    clk,
    \DEVICE_7SERIES.NO_BMM_INFO.SDP.SIMPLE_PRIM36.ram ,
    \DEVICE_7SERIES.NO_BMM_INFO.SDP.SIMPLE_PRIM36.ram_0 ,
    srst,
    Q,
    \DEVICE_7SERIES.NO_BMM_INFO.SDP.SIMPLE_PRIM36.ram_1 ,
    din,
    \DEVICE_7SERIES.NO_BMM_INFO.SDP.SIMPLE_PRIM36.ram_2 );
  output [1:0]dout;
  input clk;
  input \DEVICE_7SERIES.NO_BMM_INFO.SDP.SIMPLE_PRIM36.ram ;
  input \DEVICE_7SERIES.NO_BMM_INFO.SDP.SIMPLE_PRIM36.ram_0 ;
  input srst;
  input [13:0]Q;
  input [13:0]\DEVICE_7SERIES.NO_BMM_INFO.SDP.SIMPLE_PRIM36.ram_1 ;
  input [1:0]din;
  input [0:0]\DEVICE_7SERIES.NO_BMM_INFO.SDP.SIMPLE_PRIM36.ram_2 ;

  wire \DEVICE_7SERIES.NO_BMM_INFO.SDP.SIMPLE_PRIM36.ram ;
  wire \DEVICE_7SERIES.NO_BMM_INFO.SDP.SIMPLE_PRIM36.ram_0 ;
  wire [13:0]\DEVICE_7SERIES.NO_BMM_INFO.SDP.SIMPLE_PRIM36.ram_1 ;
  wire [0:0]\DEVICE_7SERIES.NO_BMM_INFO.SDP.SIMPLE_PRIM36.ram_2 ;
  wire [13:0]Q;
  wire clk;
  wire [1:0]din;
  wire [1:0]dout;
  wire srst;

  fifo_32_blk_mem_gen_prim_wrapper__parameterized1 \prim_noinit.ram 
       (.\DEVICE_7SERIES.NO_BMM_INFO.SDP.SIMPLE_PRIM36.ram_0 (\DEVICE_7SERIES.NO_BMM_INFO.SDP.SIMPLE_PRIM36.ram ),
        .\DEVICE_7SERIES.NO_BMM_INFO.SDP.SIMPLE_PRIM36.ram_1 (\DEVICE_7SERIES.NO_BMM_INFO.SDP.SIMPLE_PRIM36.ram_0 ),
        .\DEVICE_7SERIES.NO_BMM_INFO.SDP.SIMPLE_PRIM36.ram_2 (\DEVICE_7SERIES.NO_BMM_INFO.SDP.SIMPLE_PRIM36.ram_1 ),
        .\DEVICE_7SERIES.NO_BMM_INFO.SDP.SIMPLE_PRIM36.ram_3 (\DEVICE_7SERIES.NO_BMM_INFO.SDP.SIMPLE_PRIM36.ram_2 ),
        .Q(Q),
        .clk(clk),
        .din(din),
        .dout(dout),
        .srst(srst));
endmodule

(* ORIG_REF_NAME = "blk_mem_gen_prim_width" *) 
module fifo_32_blk_mem_gen_prim_width__parameterized10
   (\DEVICE_7SERIES.NO_BMM_INFO.SDP.SIMPLE_PRIM36.ram ,
    \DEVICE_7SERIES.NO_BMM_INFO.SDP.SIMPLE_PRIM36.ram_0 ,
    clk,
    ena_array,
    enb_array,
    srst,
    Q,
    \DEVICE_7SERIES.NO_BMM_INFO.SDP.SIMPLE_PRIM36.ram_1 ,
    din,
    \DEVICE_7SERIES.NO_BMM_INFO.SDP.SIMPLE_PRIM36.ram_2 );
  output [7:0]\DEVICE_7SERIES.NO_BMM_INFO.SDP.SIMPLE_PRIM36.ram ;
  output [0:0]\DEVICE_7SERIES.NO_BMM_INFO.SDP.SIMPLE_PRIM36.ram_0 ;
  input clk;
  input [0:0]ena_array;
  input [0:0]enb_array;
  input srst;
  input [11:0]Q;
  input [11:0]\DEVICE_7SERIES.NO_BMM_INFO.SDP.SIMPLE_PRIM36.ram_1 ;
  input [8:0]din;
  input [0:0]\DEVICE_7SERIES.NO_BMM_INFO.SDP.SIMPLE_PRIM36.ram_2 ;

  wire [7:0]\DEVICE_7SERIES.NO_BMM_INFO.SDP.SIMPLE_PRIM36.ram ;
  wire [0:0]\DEVICE_7SERIES.NO_BMM_INFO.SDP.SIMPLE_PRIM36.ram_0 ;
  wire [11:0]\DEVICE_7SERIES.NO_BMM_INFO.SDP.SIMPLE_PRIM36.ram_1 ;
  wire [0:0]\DEVICE_7SERIES.NO_BMM_INFO.SDP.SIMPLE_PRIM36.ram_2 ;
  wire [11:0]Q;
  wire clk;
  wire [8:0]din;
  wire [0:0]ena_array;
  wire [0:0]enb_array;
  wire srst;

  fifo_32_blk_mem_gen_prim_wrapper__parameterized10 \prim_noinit.ram 
       (.\DEVICE_7SERIES.NO_BMM_INFO.SDP.SIMPLE_PRIM36.ram_0 (\DEVICE_7SERIES.NO_BMM_INFO.SDP.SIMPLE_PRIM36.ram ),
        .\DEVICE_7SERIES.NO_BMM_INFO.SDP.SIMPLE_PRIM36.ram_1 (\DEVICE_7SERIES.NO_BMM_INFO.SDP.SIMPLE_PRIM36.ram_0 ),
        .\DEVICE_7SERIES.NO_BMM_INFO.SDP.SIMPLE_PRIM36.ram_2 (\DEVICE_7SERIES.NO_BMM_INFO.SDP.SIMPLE_PRIM36.ram_1 ),
        .\DEVICE_7SERIES.NO_BMM_INFO.SDP.SIMPLE_PRIM36.ram_3 (\DEVICE_7SERIES.NO_BMM_INFO.SDP.SIMPLE_PRIM36.ram_2 ),
        .Q(Q),
        .clk(clk),
        .din(din),
        .ena_array(ena_array),
        .enb_array(enb_array),
        .srst(srst));
endmodule

(* ORIG_REF_NAME = "blk_mem_gen_prim_width" *) 
module fifo_32_blk_mem_gen_prim_width__parameterized11
   (\DEVICE_7SERIES.NO_BMM_INFO.SDP.SIMPLE_PRIM36.ram ,
    \DEVICE_7SERIES.NO_BMM_INFO.SDP.SIMPLE_PRIM36.ram_0 ,
    clk,
    ena_array,
    enb_array,
    srst,
    Q,
    \DEVICE_7SERIES.NO_BMM_INFO.SDP.SIMPLE_PRIM36.ram_1 ,
    din,
    WEA);
  output [7:0]\DEVICE_7SERIES.NO_BMM_INFO.SDP.SIMPLE_PRIM36.ram ;
  output [0:0]\DEVICE_7SERIES.NO_BMM_INFO.SDP.SIMPLE_PRIM36.ram_0 ;
  input clk;
  input [0:0]ena_array;
  input [0:0]enb_array;
  input srst;
  input [11:0]Q;
  input [11:0]\DEVICE_7SERIES.NO_BMM_INFO.SDP.SIMPLE_PRIM36.ram_1 ;
  input [8:0]din;
  input [0:0]WEA;

  wire [7:0]\DEVICE_7SERIES.NO_BMM_INFO.SDP.SIMPLE_PRIM36.ram ;
  wire [0:0]\DEVICE_7SERIES.NO_BMM_INFO.SDP.SIMPLE_PRIM36.ram_0 ;
  wire [11:0]\DEVICE_7SERIES.NO_BMM_INFO.SDP.SIMPLE_PRIM36.ram_1 ;
  wire [11:0]Q;
  wire [0:0]WEA;
  wire clk;
  wire [8:0]din;
  wire [0:0]ena_array;
  wire [0:0]enb_array;
  wire srst;

  fifo_32_blk_mem_gen_prim_wrapper__parameterized11 \prim_noinit.ram 
       (.\DEVICE_7SERIES.NO_BMM_INFO.SDP.SIMPLE_PRIM36.ram_0 (\DEVICE_7SERIES.NO_BMM_INFO.SDP.SIMPLE_PRIM36.ram ),
        .\DEVICE_7SERIES.NO_BMM_INFO.SDP.SIMPLE_PRIM36.ram_1 (\DEVICE_7SERIES.NO_BMM_INFO.SDP.SIMPLE_PRIM36.ram_0 ),
        .\DEVICE_7SERIES.NO_BMM_INFO.SDP.SIMPLE_PRIM36.ram_2 (\DEVICE_7SERIES.NO_BMM_INFO.SDP.SIMPLE_PRIM36.ram_1 ),
        .Q(Q),
        .WEA(WEA),
        .clk(clk),
        .din(din),
        .ena_array(ena_array),
        .enb_array(enb_array),
        .srst(srst));
endmodule

(* ORIG_REF_NAME = "blk_mem_gen_prim_width" *) 
module fifo_32_blk_mem_gen_prim_width__parameterized12
   (DOBDO,
    DOPBDOP,
    clk,
    ena_array,
    enb_array,
    srst,
    Q,
    \DEVICE_7SERIES.NO_BMM_INFO.SDP.SIMPLE_PRIM36.ram ,
    din,
    \DEVICE_7SERIES.NO_BMM_INFO.SDP.SIMPLE_PRIM36.ram_0 );
  output [7:0]DOBDO;
  output [0:0]DOPBDOP;
  input clk;
  input [0:0]ena_array;
  input [0:0]enb_array;
  input srst;
  input [11:0]Q;
  input [11:0]\DEVICE_7SERIES.NO_BMM_INFO.SDP.SIMPLE_PRIM36.ram ;
  input [8:0]din;
  input [0:0]\DEVICE_7SERIES.NO_BMM_INFO.SDP.SIMPLE_PRIM36.ram_0 ;

  wire [11:0]\DEVICE_7SERIES.NO_BMM_INFO.SDP.SIMPLE_PRIM36.ram ;
  wire [0:0]\DEVICE_7SERIES.NO_BMM_INFO.SDP.SIMPLE_PRIM36.ram_0 ;
  wire [7:0]DOBDO;
  wire [0:0]DOPBDOP;
  wire [11:0]Q;
  wire clk;
  wire [8:0]din;
  wire [0:0]ena_array;
  wire [0:0]enb_array;
  wire srst;

  fifo_32_blk_mem_gen_prim_wrapper__parameterized12 \prim_noinit.ram 
       (.\DEVICE_7SERIES.NO_BMM_INFO.SDP.SIMPLE_PRIM36.ram_0 (\DEVICE_7SERIES.NO_BMM_INFO.SDP.SIMPLE_PRIM36.ram ),
        .\DEVICE_7SERIES.NO_BMM_INFO.SDP.SIMPLE_PRIM36.ram_1 (\DEVICE_7SERIES.NO_BMM_INFO.SDP.SIMPLE_PRIM36.ram_0 ),
        .DOBDO(DOBDO),
        .DOPBDOP(DOPBDOP),
        .Q(Q),
        .clk(clk),
        .din(din),
        .ena_array(ena_array),
        .enb_array(enb_array),
        .srst(srst));
endmodule

(* ORIG_REF_NAME = "blk_mem_gen_prim_width" *) 
module fifo_32_blk_mem_gen_prim_width__parameterized13
   (\DEVICE_7SERIES.NO_BMM_INFO.SDP.SIMPLE_PRIM36.ram ,
    \DEVICE_7SERIES.NO_BMM_INFO.SDP.SIMPLE_PRIM36.ram_0 ,
    clk,
    \DEVICE_7SERIES.NO_BMM_INFO.SDP.SIMPLE_PRIM36.ram_1 ,
    \DEVICE_7SERIES.NO_BMM_INFO.SDP.SIMPLE_PRIM36.ram_2 ,
    srst,
    Q,
    \DEVICE_7SERIES.NO_BMM_INFO.SDP.SIMPLE_PRIM36.ram_3 ,
    din,
    WEA);
  output [7:0]\DEVICE_7SERIES.NO_BMM_INFO.SDP.SIMPLE_PRIM36.ram ;
  output [0:0]\DEVICE_7SERIES.NO_BMM_INFO.SDP.SIMPLE_PRIM36.ram_0 ;
  input clk;
  input \DEVICE_7SERIES.NO_BMM_INFO.SDP.SIMPLE_PRIM36.ram_1 ;
  input \DEVICE_7SERIES.NO_BMM_INFO.SDP.SIMPLE_PRIM36.ram_2 ;
  input srst;
  input [11:0]Q;
  input [11:0]\DEVICE_7SERIES.NO_BMM_INFO.SDP.SIMPLE_PRIM36.ram_3 ;
  input [8:0]din;
  input [0:0]WEA;

  wire [7:0]\DEVICE_7SERIES.NO_BMM_INFO.SDP.SIMPLE_PRIM36.ram ;
  wire [0:0]\DEVICE_7SERIES.NO_BMM_INFO.SDP.SIMPLE_PRIM36.ram_0 ;
  wire \DEVICE_7SERIES.NO_BMM_INFO.SDP.SIMPLE_PRIM36.ram_1 ;
  wire \DEVICE_7SERIES.NO_BMM_INFO.SDP.SIMPLE_PRIM36.ram_2 ;
  wire [11:0]\DEVICE_7SERIES.NO_BMM_INFO.SDP.SIMPLE_PRIM36.ram_3 ;
  wire [11:0]Q;
  wire [0:0]WEA;
  wire clk;
  wire [8:0]din;
  wire srst;

  fifo_32_blk_mem_gen_prim_wrapper__parameterized13 \prim_noinit.ram 
       (.\DEVICE_7SERIES.NO_BMM_INFO.SDP.SIMPLE_PRIM36.ram_0 (\DEVICE_7SERIES.NO_BMM_INFO.SDP.SIMPLE_PRIM36.ram ),
        .\DEVICE_7SERIES.NO_BMM_INFO.SDP.SIMPLE_PRIM36.ram_1 (\DEVICE_7SERIES.NO_BMM_INFO.SDP.SIMPLE_PRIM36.ram_0 ),
        .\DEVICE_7SERIES.NO_BMM_INFO.SDP.SIMPLE_PRIM36.ram_2 (\DEVICE_7SERIES.NO_BMM_INFO.SDP.SIMPLE_PRIM36.ram_1 ),
        .\DEVICE_7SERIES.NO_BMM_INFO.SDP.SIMPLE_PRIM36.ram_3 (\DEVICE_7SERIES.NO_BMM_INFO.SDP.SIMPLE_PRIM36.ram_2 ),
        .\DEVICE_7SERIES.NO_BMM_INFO.SDP.SIMPLE_PRIM36.ram_4 (\DEVICE_7SERIES.NO_BMM_INFO.SDP.SIMPLE_PRIM36.ram_3 ),
        .Q(Q),
        .WEA(WEA),
        .clk(clk),
        .din(din),
        .srst(srst));
endmodule

(* ORIG_REF_NAME = "blk_mem_gen_prim_width" *) 
module fifo_32_blk_mem_gen_prim_width__parameterized2
   (\DEVICE_7SERIES.NO_BMM_INFO.SDP.SIMPLE_PRIM36.ram ,
    \DEVICE_7SERIES.NO_BMM_INFO.SDP.SIMPLE_PRIM36.ram_0 ,
    clk,
    ena_array,
    enb_array,
    srst,
    Q,
    \DEVICE_7SERIES.NO_BMM_INFO.SDP.SIMPLE_PRIM36.ram_1 ,
    din,
    \DEVICE_7SERIES.NO_BMM_INFO.SDP.SIMPLE_PRIM36.ram_2 );
  output [7:0]\DEVICE_7SERIES.NO_BMM_INFO.SDP.SIMPLE_PRIM36.ram ;
  output [0:0]\DEVICE_7SERIES.NO_BMM_INFO.SDP.SIMPLE_PRIM36.ram_0 ;
  input clk;
  input [0:0]ena_array;
  input [0:0]enb_array;
  input srst;
  input [11:0]Q;
  input [11:0]\DEVICE_7SERIES.NO_BMM_INFO.SDP.SIMPLE_PRIM36.ram_1 ;
  input [8:0]din;
  input [0:0]\DEVICE_7SERIES.NO_BMM_INFO.SDP.SIMPLE_PRIM36.ram_2 ;

  wire [7:0]\DEVICE_7SERIES.NO_BMM_INFO.SDP.SIMPLE_PRIM36.ram ;
  wire [0:0]\DEVICE_7SERIES.NO_BMM_INFO.SDP.SIMPLE_PRIM36.ram_0 ;
  wire [11:0]\DEVICE_7SERIES.NO_BMM_INFO.SDP.SIMPLE_PRIM36.ram_1 ;
  wire [0:0]\DEVICE_7SERIES.NO_BMM_INFO.SDP.SIMPLE_PRIM36.ram_2 ;
  wire [11:0]Q;
  wire clk;
  wire [8:0]din;
  wire [0:0]ena_array;
  wire [0:0]enb_array;
  wire srst;

  fifo_32_blk_mem_gen_prim_wrapper__parameterized2 \prim_noinit.ram 
       (.\DEVICE_7SERIES.NO_BMM_INFO.SDP.SIMPLE_PRIM36.ram_0 (\DEVICE_7SERIES.NO_BMM_INFO.SDP.SIMPLE_PRIM36.ram ),
        .\DEVICE_7SERIES.NO_BMM_INFO.SDP.SIMPLE_PRIM36.ram_1 (\DEVICE_7SERIES.NO_BMM_INFO.SDP.SIMPLE_PRIM36.ram_0 ),
        .\DEVICE_7SERIES.NO_BMM_INFO.SDP.SIMPLE_PRIM36.ram_2 (\DEVICE_7SERIES.NO_BMM_INFO.SDP.SIMPLE_PRIM36.ram_1 ),
        .\DEVICE_7SERIES.NO_BMM_INFO.SDP.SIMPLE_PRIM36.ram_3 (\DEVICE_7SERIES.NO_BMM_INFO.SDP.SIMPLE_PRIM36.ram_2 ),
        .Q(Q),
        .clk(clk),
        .din(din),
        .ena_array(ena_array),
        .enb_array(enb_array),
        .srst(srst));
endmodule

(* ORIG_REF_NAME = "blk_mem_gen_prim_width" *) 
module fifo_32_blk_mem_gen_prim_width__parameterized3
   (\DEVICE_7SERIES.NO_BMM_INFO.SDP.SIMPLE_PRIM36.ram ,
    \DEVICE_7SERIES.NO_BMM_INFO.SDP.SIMPLE_PRIM36.ram_0 ,
    clk,
    ena_array,
    enb_array,
    srst,
    Q,
    \DEVICE_7SERIES.NO_BMM_INFO.SDP.SIMPLE_PRIM36.ram_1 ,
    din,
    \DEVICE_7SERIES.NO_BMM_INFO.SDP.SIMPLE_PRIM36.ram_2 );
  output [7:0]\DEVICE_7SERIES.NO_BMM_INFO.SDP.SIMPLE_PRIM36.ram ;
  output [0:0]\DEVICE_7SERIES.NO_BMM_INFO.SDP.SIMPLE_PRIM36.ram_0 ;
  input clk;
  input [0:0]ena_array;
  input [0:0]enb_array;
  input srst;
  input [11:0]Q;
  input [11:0]\DEVICE_7SERIES.NO_BMM_INFO.SDP.SIMPLE_PRIM36.ram_1 ;
  input [8:0]din;
  input [0:0]\DEVICE_7SERIES.NO_BMM_INFO.SDP.SIMPLE_PRIM36.ram_2 ;

  wire [7:0]\DEVICE_7SERIES.NO_BMM_INFO.SDP.SIMPLE_PRIM36.ram ;
  wire [0:0]\DEVICE_7SERIES.NO_BMM_INFO.SDP.SIMPLE_PRIM36.ram_0 ;
  wire [11:0]\DEVICE_7SERIES.NO_BMM_INFO.SDP.SIMPLE_PRIM36.ram_1 ;
  wire [0:0]\DEVICE_7SERIES.NO_BMM_INFO.SDP.SIMPLE_PRIM36.ram_2 ;
  wire [11:0]Q;
  wire clk;
  wire [8:0]din;
  wire [0:0]ena_array;
  wire [0:0]enb_array;
  wire srst;

  fifo_32_blk_mem_gen_prim_wrapper__parameterized3 \prim_noinit.ram 
       (.\DEVICE_7SERIES.NO_BMM_INFO.SDP.SIMPLE_PRIM36.ram_0 (\DEVICE_7SERIES.NO_BMM_INFO.SDP.SIMPLE_PRIM36.ram ),
        .\DEVICE_7SERIES.NO_BMM_INFO.SDP.SIMPLE_PRIM36.ram_1 (\DEVICE_7SERIES.NO_BMM_INFO.SDP.SIMPLE_PRIM36.ram_0 ),
        .\DEVICE_7SERIES.NO_BMM_INFO.SDP.SIMPLE_PRIM36.ram_2 (\DEVICE_7SERIES.NO_BMM_INFO.SDP.SIMPLE_PRIM36.ram_1 ),
        .\DEVICE_7SERIES.NO_BMM_INFO.SDP.SIMPLE_PRIM36.ram_3 (\DEVICE_7SERIES.NO_BMM_INFO.SDP.SIMPLE_PRIM36.ram_2 ),
        .Q(Q),
        .clk(clk),
        .din(din),
        .ena_array(ena_array),
        .enb_array(enb_array),
        .srst(srst));
endmodule

(* ORIG_REF_NAME = "blk_mem_gen_prim_width" *) 
module fifo_32_blk_mem_gen_prim_width__parameterized4
   (\DEVICE_7SERIES.NO_BMM_INFO.SDP.SIMPLE_PRIM36.ram ,
    \DEVICE_7SERIES.NO_BMM_INFO.SDP.SIMPLE_PRIM36.ram_0 ,
    clk,
    ena_array,
    enb_array,
    srst,
    Q,
    \DEVICE_7SERIES.NO_BMM_INFO.SDP.SIMPLE_PRIM36.ram_1 ,
    din,
    \DEVICE_7SERIES.NO_BMM_INFO.SDP.SIMPLE_PRIM36.ram_2 );
  output [7:0]\DEVICE_7SERIES.NO_BMM_INFO.SDP.SIMPLE_PRIM36.ram ;
  output [0:0]\DEVICE_7SERIES.NO_BMM_INFO.SDP.SIMPLE_PRIM36.ram_0 ;
  input clk;
  input [0:0]ena_array;
  input [0:0]enb_array;
  input srst;
  input [11:0]Q;
  input [11:0]\DEVICE_7SERIES.NO_BMM_INFO.SDP.SIMPLE_PRIM36.ram_1 ;
  input [8:0]din;
  input [1:0]\DEVICE_7SERIES.NO_BMM_INFO.SDP.SIMPLE_PRIM36.ram_2 ;

  wire [7:0]\DEVICE_7SERIES.NO_BMM_INFO.SDP.SIMPLE_PRIM36.ram ;
  wire [0:0]\DEVICE_7SERIES.NO_BMM_INFO.SDP.SIMPLE_PRIM36.ram_0 ;
  wire [11:0]\DEVICE_7SERIES.NO_BMM_INFO.SDP.SIMPLE_PRIM36.ram_1 ;
  wire [1:0]\DEVICE_7SERIES.NO_BMM_INFO.SDP.SIMPLE_PRIM36.ram_2 ;
  wire [11:0]Q;
  wire clk;
  wire [8:0]din;
  wire [0:0]ena_array;
  wire [0:0]enb_array;
  wire srst;

  fifo_32_blk_mem_gen_prim_wrapper__parameterized4 \prim_noinit.ram 
       (.\DEVICE_7SERIES.NO_BMM_INFO.SDP.SIMPLE_PRIM36.ram_0 (\DEVICE_7SERIES.NO_BMM_INFO.SDP.SIMPLE_PRIM36.ram ),
        .\DEVICE_7SERIES.NO_BMM_INFO.SDP.SIMPLE_PRIM36.ram_1 (\DEVICE_7SERIES.NO_BMM_INFO.SDP.SIMPLE_PRIM36.ram_0 ),
        .\DEVICE_7SERIES.NO_BMM_INFO.SDP.SIMPLE_PRIM36.ram_2 (\DEVICE_7SERIES.NO_BMM_INFO.SDP.SIMPLE_PRIM36.ram_1 ),
        .\DEVICE_7SERIES.NO_BMM_INFO.SDP.SIMPLE_PRIM36.ram_3 (\DEVICE_7SERIES.NO_BMM_INFO.SDP.SIMPLE_PRIM36.ram_2 ),
        .Q(Q),
        .clk(clk),
        .din(din),
        .ena_array(ena_array),
        .enb_array(enb_array),
        .srst(srst));
endmodule

(* ORIG_REF_NAME = "blk_mem_gen_prim_width" *) 
module fifo_32_blk_mem_gen_prim_width__parameterized5
   (\DEVICE_7SERIES.NO_BMM_INFO.SDP.SIMPLE_PRIM36.ram ,
    \DEVICE_7SERIES.NO_BMM_INFO.SDP.SIMPLE_PRIM36.ram_0 ,
    clk,
    \DEVICE_7SERIES.NO_BMM_INFO.SDP.SIMPLE_PRIM36.ram_1 ,
    \DEVICE_7SERIES.NO_BMM_INFO.SDP.SIMPLE_PRIM36.ram_2 ,
    srst,
    Q,
    \DEVICE_7SERIES.NO_BMM_INFO.SDP.SIMPLE_PRIM36.ram_3 ,
    din,
    WEA);
  output [7:0]\DEVICE_7SERIES.NO_BMM_INFO.SDP.SIMPLE_PRIM36.ram ;
  output [0:0]\DEVICE_7SERIES.NO_BMM_INFO.SDP.SIMPLE_PRIM36.ram_0 ;
  input clk;
  input \DEVICE_7SERIES.NO_BMM_INFO.SDP.SIMPLE_PRIM36.ram_1 ;
  input \DEVICE_7SERIES.NO_BMM_INFO.SDP.SIMPLE_PRIM36.ram_2 ;
  input srst;
  input [11:0]Q;
  input [11:0]\DEVICE_7SERIES.NO_BMM_INFO.SDP.SIMPLE_PRIM36.ram_3 ;
  input [8:0]din;
  input [0:0]WEA;

  wire [7:0]\DEVICE_7SERIES.NO_BMM_INFO.SDP.SIMPLE_PRIM36.ram ;
  wire [0:0]\DEVICE_7SERIES.NO_BMM_INFO.SDP.SIMPLE_PRIM36.ram_0 ;
  wire \DEVICE_7SERIES.NO_BMM_INFO.SDP.SIMPLE_PRIM36.ram_1 ;
  wire \DEVICE_7SERIES.NO_BMM_INFO.SDP.SIMPLE_PRIM36.ram_2 ;
  wire [11:0]\DEVICE_7SERIES.NO_BMM_INFO.SDP.SIMPLE_PRIM36.ram_3 ;
  wire [11:0]Q;
  wire [0:0]WEA;
  wire clk;
  wire [8:0]din;
  wire srst;

  fifo_32_blk_mem_gen_prim_wrapper__parameterized5 \prim_noinit.ram 
       (.\DEVICE_7SERIES.NO_BMM_INFO.SDP.SIMPLE_PRIM36.ram_0 (\DEVICE_7SERIES.NO_BMM_INFO.SDP.SIMPLE_PRIM36.ram ),
        .\DEVICE_7SERIES.NO_BMM_INFO.SDP.SIMPLE_PRIM36.ram_1 (\DEVICE_7SERIES.NO_BMM_INFO.SDP.SIMPLE_PRIM36.ram_0 ),
        .\DEVICE_7SERIES.NO_BMM_INFO.SDP.SIMPLE_PRIM36.ram_2 (\DEVICE_7SERIES.NO_BMM_INFO.SDP.SIMPLE_PRIM36.ram_1 ),
        .\DEVICE_7SERIES.NO_BMM_INFO.SDP.SIMPLE_PRIM36.ram_3 (\DEVICE_7SERIES.NO_BMM_INFO.SDP.SIMPLE_PRIM36.ram_2 ),
        .\DEVICE_7SERIES.NO_BMM_INFO.SDP.SIMPLE_PRIM36.ram_4 (\DEVICE_7SERIES.NO_BMM_INFO.SDP.SIMPLE_PRIM36.ram_3 ),
        .Q(Q),
        .WEA(WEA),
        .clk(clk),
        .din(din),
        .srst(srst));
endmodule

(* ORIG_REF_NAME = "blk_mem_gen_prim_width" *) 
module fifo_32_blk_mem_gen_prim_width__parameterized6
   (\DEVICE_7SERIES.NO_BMM_INFO.SDP.SIMPLE_PRIM36.ram ,
    \DEVICE_7SERIES.NO_BMM_INFO.SDP.SIMPLE_PRIM36.ram_0 ,
    clk,
    ena_array,
    enb_array,
    srst,
    Q,
    \DEVICE_7SERIES.NO_BMM_INFO.SDP.SIMPLE_PRIM36.ram_1 ,
    din,
    \DEVICE_7SERIES.NO_BMM_INFO.SDP.SIMPLE_PRIM36.ram_2 );
  output [7:0]\DEVICE_7SERIES.NO_BMM_INFO.SDP.SIMPLE_PRIM36.ram ;
  output [0:0]\DEVICE_7SERIES.NO_BMM_INFO.SDP.SIMPLE_PRIM36.ram_0 ;
  input clk;
  input [0:0]ena_array;
  input [0:0]enb_array;
  input srst;
  input [11:0]Q;
  input [11:0]\DEVICE_7SERIES.NO_BMM_INFO.SDP.SIMPLE_PRIM36.ram_1 ;
  input [8:0]din;
  input [0:0]\DEVICE_7SERIES.NO_BMM_INFO.SDP.SIMPLE_PRIM36.ram_2 ;

  wire [7:0]\DEVICE_7SERIES.NO_BMM_INFO.SDP.SIMPLE_PRIM36.ram ;
  wire [0:0]\DEVICE_7SERIES.NO_BMM_INFO.SDP.SIMPLE_PRIM36.ram_0 ;
  wire [11:0]\DEVICE_7SERIES.NO_BMM_INFO.SDP.SIMPLE_PRIM36.ram_1 ;
  wire [0:0]\DEVICE_7SERIES.NO_BMM_INFO.SDP.SIMPLE_PRIM36.ram_2 ;
  wire [11:0]Q;
  wire clk;
  wire [8:0]din;
  wire [0:0]ena_array;
  wire [0:0]enb_array;
  wire srst;

  fifo_32_blk_mem_gen_prim_wrapper__parameterized6 \prim_noinit.ram 
       (.\DEVICE_7SERIES.NO_BMM_INFO.SDP.SIMPLE_PRIM36.ram_0 (\DEVICE_7SERIES.NO_BMM_INFO.SDP.SIMPLE_PRIM36.ram ),
        .\DEVICE_7SERIES.NO_BMM_INFO.SDP.SIMPLE_PRIM36.ram_1 (\DEVICE_7SERIES.NO_BMM_INFO.SDP.SIMPLE_PRIM36.ram_0 ),
        .\DEVICE_7SERIES.NO_BMM_INFO.SDP.SIMPLE_PRIM36.ram_2 (\DEVICE_7SERIES.NO_BMM_INFO.SDP.SIMPLE_PRIM36.ram_1 ),
        .\DEVICE_7SERIES.NO_BMM_INFO.SDP.SIMPLE_PRIM36.ram_3 (\DEVICE_7SERIES.NO_BMM_INFO.SDP.SIMPLE_PRIM36.ram_2 ),
        .Q(Q),
        .clk(clk),
        .din(din),
        .ena_array(ena_array),
        .enb_array(enb_array),
        .srst(srst));
endmodule

(* ORIG_REF_NAME = "blk_mem_gen_prim_width" *) 
module fifo_32_blk_mem_gen_prim_width__parameterized7
   (\DEVICE_7SERIES.NO_BMM_INFO.SDP.SIMPLE_PRIM36.ram ,
    \DEVICE_7SERIES.NO_BMM_INFO.SDP.SIMPLE_PRIM36.ram_0 ,
    clk,
    ena_array,
    enb_array,
    srst,
    Q,
    \DEVICE_7SERIES.NO_BMM_INFO.SDP.SIMPLE_PRIM36.ram_1 ,
    din,
    WEA);
  output [7:0]\DEVICE_7SERIES.NO_BMM_INFO.SDP.SIMPLE_PRIM36.ram ;
  output [0:0]\DEVICE_7SERIES.NO_BMM_INFO.SDP.SIMPLE_PRIM36.ram_0 ;
  input clk;
  input [0:0]ena_array;
  input [0:0]enb_array;
  input srst;
  input [11:0]Q;
  input [11:0]\DEVICE_7SERIES.NO_BMM_INFO.SDP.SIMPLE_PRIM36.ram_1 ;
  input [8:0]din;
  input [0:0]WEA;

  wire [7:0]\DEVICE_7SERIES.NO_BMM_INFO.SDP.SIMPLE_PRIM36.ram ;
  wire [0:0]\DEVICE_7SERIES.NO_BMM_INFO.SDP.SIMPLE_PRIM36.ram_0 ;
  wire [11:0]\DEVICE_7SERIES.NO_BMM_INFO.SDP.SIMPLE_PRIM36.ram_1 ;
  wire [11:0]Q;
  wire [0:0]WEA;
  wire clk;
  wire [8:0]din;
  wire [0:0]ena_array;
  wire [0:0]enb_array;
  wire srst;

  fifo_32_blk_mem_gen_prim_wrapper__parameterized7 \prim_noinit.ram 
       (.\DEVICE_7SERIES.NO_BMM_INFO.SDP.SIMPLE_PRIM36.ram_0 (\DEVICE_7SERIES.NO_BMM_INFO.SDP.SIMPLE_PRIM36.ram ),
        .\DEVICE_7SERIES.NO_BMM_INFO.SDP.SIMPLE_PRIM36.ram_1 (\DEVICE_7SERIES.NO_BMM_INFO.SDP.SIMPLE_PRIM36.ram_0 ),
        .\DEVICE_7SERIES.NO_BMM_INFO.SDP.SIMPLE_PRIM36.ram_2 (\DEVICE_7SERIES.NO_BMM_INFO.SDP.SIMPLE_PRIM36.ram_1 ),
        .Q(Q),
        .WEA(WEA),
        .clk(clk),
        .din(din),
        .ena_array(ena_array),
        .enb_array(enb_array),
        .srst(srst));
endmodule

(* ORIG_REF_NAME = "blk_mem_gen_prim_width" *) 
module fifo_32_blk_mem_gen_prim_width__parameterized8
   (\DEVICE_7SERIES.NO_BMM_INFO.SDP.SIMPLE_PRIM36.ram ,
    \DEVICE_7SERIES.NO_BMM_INFO.SDP.SIMPLE_PRIM36.ram_0 ,
    clk,
    ena_array,
    enb_array,
    srst,
    Q,
    \DEVICE_7SERIES.NO_BMM_INFO.SDP.SIMPLE_PRIM36.ram_1 ,
    din,
    \DEVICE_7SERIES.NO_BMM_INFO.SDP.SIMPLE_PRIM36.ram_2 );
  output [7:0]\DEVICE_7SERIES.NO_BMM_INFO.SDP.SIMPLE_PRIM36.ram ;
  output [0:0]\DEVICE_7SERIES.NO_BMM_INFO.SDP.SIMPLE_PRIM36.ram_0 ;
  input clk;
  input [0:0]ena_array;
  input [0:0]enb_array;
  input srst;
  input [11:0]Q;
  input [11:0]\DEVICE_7SERIES.NO_BMM_INFO.SDP.SIMPLE_PRIM36.ram_1 ;
  input [8:0]din;
  input [0:0]\DEVICE_7SERIES.NO_BMM_INFO.SDP.SIMPLE_PRIM36.ram_2 ;

  wire [7:0]\DEVICE_7SERIES.NO_BMM_INFO.SDP.SIMPLE_PRIM36.ram ;
  wire [0:0]\DEVICE_7SERIES.NO_BMM_INFO.SDP.SIMPLE_PRIM36.ram_0 ;
  wire [11:0]\DEVICE_7SERIES.NO_BMM_INFO.SDP.SIMPLE_PRIM36.ram_1 ;
  wire [0:0]\DEVICE_7SERIES.NO_BMM_INFO.SDP.SIMPLE_PRIM36.ram_2 ;
  wire [11:0]Q;
  wire clk;
  wire [8:0]din;
  wire [0:0]ena_array;
  wire [0:0]enb_array;
  wire srst;

  fifo_32_blk_mem_gen_prim_wrapper__parameterized8 \prim_noinit.ram 
       (.\DEVICE_7SERIES.NO_BMM_INFO.SDP.SIMPLE_PRIM36.ram_0 (\DEVICE_7SERIES.NO_BMM_INFO.SDP.SIMPLE_PRIM36.ram ),
        .\DEVICE_7SERIES.NO_BMM_INFO.SDP.SIMPLE_PRIM36.ram_1 (\DEVICE_7SERIES.NO_BMM_INFO.SDP.SIMPLE_PRIM36.ram_0 ),
        .\DEVICE_7SERIES.NO_BMM_INFO.SDP.SIMPLE_PRIM36.ram_2 (\DEVICE_7SERIES.NO_BMM_INFO.SDP.SIMPLE_PRIM36.ram_1 ),
        .\DEVICE_7SERIES.NO_BMM_INFO.SDP.SIMPLE_PRIM36.ram_3 (\DEVICE_7SERIES.NO_BMM_INFO.SDP.SIMPLE_PRIM36.ram_2 ),
        .Q(Q),
        .clk(clk),
        .din(din),
        .ena_array(ena_array),
        .enb_array(enb_array),
        .srst(srst));
endmodule

(* ORIG_REF_NAME = "blk_mem_gen_prim_width" *) 
module fifo_32_blk_mem_gen_prim_width__parameterized9
   (\DEVICE_7SERIES.NO_BMM_INFO.SDP.SIMPLE_PRIM36.ram ,
    \DEVICE_7SERIES.NO_BMM_INFO.SDP.SIMPLE_PRIM36.ram_0 ,
    clk,
    \DEVICE_7SERIES.NO_BMM_INFO.SDP.SIMPLE_PRIM36.ram_1 ,
    \DEVICE_7SERIES.NO_BMM_INFO.SDP.SIMPLE_PRIM36.ram_2 ,
    srst,
    Q,
    \DEVICE_7SERIES.NO_BMM_INFO.SDP.SIMPLE_PRIM36.ram_3 ,
    din,
    WEA);
  output [7:0]\DEVICE_7SERIES.NO_BMM_INFO.SDP.SIMPLE_PRIM36.ram ;
  output [0:0]\DEVICE_7SERIES.NO_BMM_INFO.SDP.SIMPLE_PRIM36.ram_0 ;
  input clk;
  input \DEVICE_7SERIES.NO_BMM_INFO.SDP.SIMPLE_PRIM36.ram_1 ;
  input \DEVICE_7SERIES.NO_BMM_INFO.SDP.SIMPLE_PRIM36.ram_2 ;
  input srst;
  input [11:0]Q;
  input [11:0]\DEVICE_7SERIES.NO_BMM_INFO.SDP.SIMPLE_PRIM36.ram_3 ;
  input [8:0]din;
  input [1:0]WEA;

  wire [7:0]\DEVICE_7SERIES.NO_BMM_INFO.SDP.SIMPLE_PRIM36.ram ;
  wire [0:0]\DEVICE_7SERIES.NO_BMM_INFO.SDP.SIMPLE_PRIM36.ram_0 ;
  wire \DEVICE_7SERIES.NO_BMM_INFO.SDP.SIMPLE_PRIM36.ram_1 ;
  wire \DEVICE_7SERIES.NO_BMM_INFO.SDP.SIMPLE_PRIM36.ram_2 ;
  wire [11:0]\DEVICE_7SERIES.NO_BMM_INFO.SDP.SIMPLE_PRIM36.ram_3 ;
  wire [11:0]Q;
  wire [1:0]WEA;
  wire clk;
  wire [8:0]din;
  wire srst;

  fifo_32_blk_mem_gen_prim_wrapper__parameterized9 \prim_noinit.ram 
       (.\DEVICE_7SERIES.NO_BMM_INFO.SDP.SIMPLE_PRIM36.ram_0 (\DEVICE_7SERIES.NO_BMM_INFO.SDP.SIMPLE_PRIM36.ram ),
        .\DEVICE_7SERIES.NO_BMM_INFO.SDP.SIMPLE_PRIM36.ram_1 (\DEVICE_7SERIES.NO_BMM_INFO.SDP.SIMPLE_PRIM36.ram_0 ),
        .\DEVICE_7SERIES.NO_BMM_INFO.SDP.SIMPLE_PRIM36.ram_2 (\DEVICE_7SERIES.NO_BMM_INFO.SDP.SIMPLE_PRIM36.ram_1 ),
        .\DEVICE_7SERIES.NO_BMM_INFO.SDP.SIMPLE_PRIM36.ram_3 (\DEVICE_7SERIES.NO_BMM_INFO.SDP.SIMPLE_PRIM36.ram_2 ),
        .\DEVICE_7SERIES.NO_BMM_INFO.SDP.SIMPLE_PRIM36.ram_4 (\DEVICE_7SERIES.NO_BMM_INFO.SDP.SIMPLE_PRIM36.ram_3 ),
        .Q(Q),
        .WEA(WEA),
        .clk(clk),
        .din(din),
        .srst(srst));
endmodule

(* ORIG_REF_NAME = "blk_mem_gen_prim_wrapper" *) 
module fifo_32_blk_mem_gen_prim_wrapper
   (dout,
    clk,
    \DEVICE_7SERIES.NO_BMM_INFO.SDP.SIMPLE_PRIM18.ram_0 ,
    \DEVICE_7SERIES.NO_BMM_INFO.SDP.SIMPLE_PRIM18.ram_1 ,
    srst,
    Q,
    \DEVICE_7SERIES.NO_BMM_INFO.SDP.SIMPLE_PRIM18.ram_2 ,
    din,
    \DEVICE_7SERIES.NO_BMM_INFO.SDP.SIMPLE_PRIM18.ram_3 );
  output [0:0]dout;
  input clk;
  input \DEVICE_7SERIES.NO_BMM_INFO.SDP.SIMPLE_PRIM18.ram_0 ;
  input \DEVICE_7SERIES.NO_BMM_INFO.SDP.SIMPLE_PRIM18.ram_1 ;
  input srst;
  input [13:0]Q;
  input [13:0]\DEVICE_7SERIES.NO_BMM_INFO.SDP.SIMPLE_PRIM18.ram_2 ;
  input [0:0]din;
  input [0:0]\DEVICE_7SERIES.NO_BMM_INFO.SDP.SIMPLE_PRIM18.ram_3 ;

  wire \DEVICE_7SERIES.NO_BMM_INFO.SDP.SIMPLE_PRIM18.ram_0 ;
  wire \DEVICE_7SERIES.NO_BMM_INFO.SDP.SIMPLE_PRIM18.ram_1 ;
  wire [13:0]\DEVICE_7SERIES.NO_BMM_INFO.SDP.SIMPLE_PRIM18.ram_2 ;
  wire [0:0]\DEVICE_7SERIES.NO_BMM_INFO.SDP.SIMPLE_PRIM18.ram_3 ;
  wire [13:0]Q;
  wire clk;
  wire [0:0]din;
  wire [0:0]dout;
  wire srst;
  wire [15:0]\NLW_DEVICE_7SERIES.NO_BMM_INFO.SDP.SIMPLE_PRIM18.ram_DOADO_UNCONNECTED ;
  wire [15:1]\NLW_DEVICE_7SERIES.NO_BMM_INFO.SDP.SIMPLE_PRIM18.ram_DOBDO_UNCONNECTED ;
  wire [1:0]\NLW_DEVICE_7SERIES.NO_BMM_INFO.SDP.SIMPLE_PRIM18.ram_DOPADOP_UNCONNECTED ;
  wire [1:0]\NLW_DEVICE_7SERIES.NO_BMM_INFO.SDP.SIMPLE_PRIM18.ram_DOPBDOP_UNCONNECTED ;

  (* box_type = "PRIMITIVE" *) 
  RAMB18E1 #(
    .DOA_REG(0),
    .DOB_REG(0),
    .INITP_00(256'h0000000000000000000000000000000000000000000000000000000000000000),
    .INITP_01(256'h0000000000000000000000000000000000000000000000000000000000000000),
    .INITP_02(256'h0000000000000000000000000000000000000000000000000000000000000000),
    .INITP_03(256'h0000000000000000000000000000000000000000000000000000000000000000),
    .INITP_04(256'h0000000000000000000000000000000000000000000000000000000000000000),
    .INITP_05(256'h0000000000000000000000000000000000000000000000000000000000000000),
    .INITP_06(256'h0000000000000000000000000000000000000000000000000000000000000000),
    .INITP_07(256'h0000000000000000000000000000000000000000000000000000000000000000),
    .INIT_00(256'h0000000000000000000000000000000000000000000000000000000000000000),
    .INIT_01(256'h0000000000000000000000000000000000000000000000000000000000000000),
    .INIT_02(256'h0000000000000000000000000000000000000000000000000000000000000000),
    .INIT_03(256'h0000000000000000000000000000000000000000000000000000000000000000),
    .INIT_04(256'h0000000000000000000000000000000000000000000000000000000000000000),
    .INIT_05(256'h0000000000000000000000000000000000000000000000000000000000000000),
    .INIT_06(256'h0000000000000000000000000000000000000000000000000000000000000000),
    .INIT_07(256'h0000000000000000000000000000000000000000000000000000000000000000),
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
    .INIT_3A(256'h0000000000000000000000000000000000000000000000000000000000000000),
    .INIT_3B(256'h0000000000000000000000000000000000000000000000000000000000000000),
    .INIT_3C(256'h0000000000000000000000000000000000000000000000000000000000000000),
    .INIT_3D(256'h0000000000000000000000000000000000000000000000000000000000000000),
    .INIT_3E(256'h0000000000000000000000000000000000000000000000000000000000000000),
    .INIT_3F(256'h0000000000000000000000000000000000000000000000000000000000000000),
    .INIT_A(18'h00000),
    .INIT_B(18'h00000),
    .INIT_FILE("NONE"),
    .IS_CLKARDCLK_INVERTED(1'b0),
    .IS_CLKBWRCLK_INVERTED(1'b0),
    .IS_ENARDEN_INVERTED(1'b0),
    .IS_ENBWREN_INVERTED(1'b0),
    .IS_RSTRAMARSTRAM_INVERTED(1'b0),
    .IS_RSTRAMB_INVERTED(1'b0),
    .IS_RSTREGARSTREG_INVERTED(1'b0),
    .IS_RSTREGB_INVERTED(1'b0),
    .RAM_MODE("TDP"),
    .RDADDR_COLLISION_HWCONFIG("DELAYED_WRITE"),
    .READ_WIDTH_A(1),
    .READ_WIDTH_B(1),
    .RSTREG_PRIORITY_A("REGCE"),
    .RSTREG_PRIORITY_B("REGCE"),
    .SIM_COLLISION_CHECK("ALL"),
    .SIM_DEVICE("7SERIES"),
    .SRVAL_A(18'h00000),
    .SRVAL_B(18'h00000),
    .WRITE_MODE_A("WRITE_FIRST"),
    .WRITE_MODE_B("WRITE_FIRST"),
    .WRITE_WIDTH_A(1),
    .WRITE_WIDTH_B(1)) 
    \DEVICE_7SERIES.NO_BMM_INFO.SDP.SIMPLE_PRIM18.ram 
       (.ADDRARDADDR(Q),
        .ADDRBWRADDR(\DEVICE_7SERIES.NO_BMM_INFO.SDP.SIMPLE_PRIM18.ram_2 ),
        .CLKARDCLK(clk),
        .CLKBWRCLK(clk),
        .DIADI({1'b0,1'b0,1'b0,1'b0,1'b0,1'b0,1'b0,1'b0,1'b0,1'b0,1'b0,1'b0,1'b0,1'b0,1'b0,din}),
        .DIBDI({1'b0,1'b0,1'b0,1'b0,1'b0,1'b0,1'b0,1'b0,1'b0,1'b0,1'b0,1'b0,1'b0,1'b0,1'b0,1'b0}),
        .DIPADIP({1'b0,1'b0}),
        .DIPBDIP({1'b0,1'b0}),
        .DOADO(\NLW_DEVICE_7SERIES.NO_BMM_INFO.SDP.SIMPLE_PRIM18.ram_DOADO_UNCONNECTED [15:0]),
        .DOBDO({\NLW_DEVICE_7SERIES.NO_BMM_INFO.SDP.SIMPLE_PRIM18.ram_DOBDO_UNCONNECTED [15:1],dout}),
        .DOPADOP(\NLW_DEVICE_7SERIES.NO_BMM_INFO.SDP.SIMPLE_PRIM18.ram_DOPADOP_UNCONNECTED [1:0]),
        .DOPBDOP(\NLW_DEVICE_7SERIES.NO_BMM_INFO.SDP.SIMPLE_PRIM18.ram_DOPBDOP_UNCONNECTED [1:0]),
        .ENARDEN(\DEVICE_7SERIES.NO_BMM_INFO.SDP.SIMPLE_PRIM18.ram_0 ),
        .ENBWREN(\DEVICE_7SERIES.NO_BMM_INFO.SDP.SIMPLE_PRIM18.ram_1 ),
        .REGCEAREGCE(1'b0),
        .REGCEB(1'b0),
        .RSTRAMARSTRAM(1'b0),
        .RSTRAMB(srst),
        .RSTREGARSTREG(1'b0),
        .RSTREGB(1'b0),
        .WEA({\DEVICE_7SERIES.NO_BMM_INFO.SDP.SIMPLE_PRIM18.ram_3 ,\DEVICE_7SERIES.NO_BMM_INFO.SDP.SIMPLE_PRIM18.ram_3 }),
        .WEBWE({1'b0,1'b0,1'b0,1'b0}));
endmodule

(* ORIG_REF_NAME = "blk_mem_gen_prim_wrapper" *) 
module fifo_32_blk_mem_gen_prim_wrapper__parameterized0
   (dout,
    clk,
    \DEVICE_7SERIES.NO_BMM_INFO.SDP.SIMPLE_PRIM36.ram_0 ,
    \DEVICE_7SERIES.NO_BMM_INFO.SDP.SIMPLE_PRIM36.ram_1 ,
    srst,
    Q,
    \DEVICE_7SERIES.NO_BMM_INFO.SDP.SIMPLE_PRIM36.ram_2 ,
    din,
    \DEVICE_7SERIES.NO_BMM_INFO.SDP.SIMPLE_PRIM36.ram_3 );
  output [1:0]dout;
  input clk;
  input \DEVICE_7SERIES.NO_BMM_INFO.SDP.SIMPLE_PRIM36.ram_0 ;
  input \DEVICE_7SERIES.NO_BMM_INFO.SDP.SIMPLE_PRIM36.ram_1 ;
  input srst;
  input [13:0]Q;
  input [13:0]\DEVICE_7SERIES.NO_BMM_INFO.SDP.SIMPLE_PRIM36.ram_2 ;
  input [1:0]din;
  input [0:0]\DEVICE_7SERIES.NO_BMM_INFO.SDP.SIMPLE_PRIM36.ram_3 ;

  wire \DEVICE_7SERIES.NO_BMM_INFO.SDP.SIMPLE_PRIM36.ram_0 ;
  wire \DEVICE_7SERIES.NO_BMM_INFO.SDP.SIMPLE_PRIM36.ram_1 ;
  wire [13:0]\DEVICE_7SERIES.NO_BMM_INFO.SDP.SIMPLE_PRIM36.ram_2 ;
  wire [0:0]\DEVICE_7SERIES.NO_BMM_INFO.SDP.SIMPLE_PRIM36.ram_3 ;
  wire [13:0]Q;
  wire clk;
  wire [1:0]din;
  wire [1:0]dout;
  wire srst;
  wire \NLW_DEVICE_7SERIES.NO_BMM_INFO.SDP.SIMPLE_PRIM36.ram_CASCADEOUTA_UNCONNECTED ;
  wire \NLW_DEVICE_7SERIES.NO_BMM_INFO.SDP.SIMPLE_PRIM36.ram_CASCADEOUTB_UNCONNECTED ;
  wire \NLW_DEVICE_7SERIES.NO_BMM_INFO.SDP.SIMPLE_PRIM36.ram_DBITERR_UNCONNECTED ;
  wire \NLW_DEVICE_7SERIES.NO_BMM_INFO.SDP.SIMPLE_PRIM36.ram_SBITERR_UNCONNECTED ;
  wire [31:0]\NLW_DEVICE_7SERIES.NO_BMM_INFO.SDP.SIMPLE_PRIM36.ram_DOADO_UNCONNECTED ;
  wire [31:2]\NLW_DEVICE_7SERIES.NO_BMM_INFO.SDP.SIMPLE_PRIM36.ram_DOBDO_UNCONNECTED ;
  wire [3:0]\NLW_DEVICE_7SERIES.NO_BMM_INFO.SDP.SIMPLE_PRIM36.ram_DOPADOP_UNCONNECTED ;
  wire [3:0]\NLW_DEVICE_7SERIES.NO_BMM_INFO.SDP.SIMPLE_PRIM36.ram_DOPBDOP_UNCONNECTED ;
  wire [7:0]\NLW_DEVICE_7SERIES.NO_BMM_INFO.SDP.SIMPLE_PRIM36.ram_ECCPARITY_UNCONNECTED ;
  wire [8:0]\NLW_DEVICE_7SERIES.NO_BMM_INFO.SDP.SIMPLE_PRIM36.ram_RDADDRECC_UNCONNECTED ;

  (* box_type = "PRIMITIVE" *) 
  RAMB36E1 #(
    .DOA_REG(0),
    .DOB_REG(0),
    .EN_ECC_READ("FALSE"),
    .EN_ECC_WRITE("FALSE"),
    .INITP_00(256'h0000000000000000000000000000000000000000000000000000000000000000),
    .INITP_01(256'h0000000000000000000000000000000000000000000000000000000000000000),
    .INITP_02(256'h0000000000000000000000000000000000000000000000000000000000000000),
    .INITP_03(256'h0000000000000000000000000000000000000000000000000000000000000000),
    .INITP_04(256'h0000000000000000000000000000000000000000000000000000000000000000),
    .INITP_05(256'h0000000000000000000000000000000000000000000000000000000000000000),
    .INITP_06(256'h0000000000000000000000000000000000000000000000000000000000000000),
    .INITP_07(256'h0000000000000000000000000000000000000000000000000000000000000000),
    .INITP_08(256'h0000000000000000000000000000000000000000000000000000000000000000),
    .INITP_09(256'h0000000000000000000000000000000000000000000000000000000000000000),
    .INITP_0A(256'h0000000000000000000000000000000000000000000000000000000000000000),
    .INITP_0B(256'h0000000000000000000000000000000000000000000000000000000000000000),
    .INITP_0C(256'h0000000000000000000000000000000000000000000000000000000000000000),
    .INITP_0D(256'h0000000000000000000000000000000000000000000000000000000000000000),
    .INITP_0E(256'h0000000000000000000000000000000000000000000000000000000000000000),
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
    .INIT_77(256'h0000000000000000000000000000000000000000000000000000000000000000),
    .INIT_78(256'h0000000000000000000000000000000000000000000000000000000000000000),
    .INIT_79(256'h0000000000000000000000000000000000000000000000000000000000000000),
    .INIT_7A(256'h0000000000000000000000000000000000000000000000000000000000000000),
    .INIT_7B(256'h0000000000000000000000000000000000000000000000000000000000000000),
    .INIT_7C(256'h0000000000000000000000000000000000000000000000000000000000000000),
    .INIT_7D(256'h0000000000000000000000000000000000000000000000000000000000000000),
    .INIT_7E(256'h0000000000000000000000000000000000000000000000000000000000000000),
    .INIT_7F(256'h0000000000000000000000000000000000000000000000000000000000000000),
    .INIT_A(36'h000000000),
    .INIT_B(36'h000000000),
    .INIT_FILE("NONE"),
    .IS_CLKARDCLK_INVERTED(1'b0),
    .IS_CLKBWRCLK_INVERTED(1'b0),
    .IS_ENARDEN_INVERTED(1'b0),
    .IS_ENBWREN_INVERTED(1'b0),
    .IS_RSTRAMARSTRAM_INVERTED(1'b0),
    .IS_RSTRAMB_INVERTED(1'b0),
    .IS_RSTREGARSTREG_INVERTED(1'b0),
    .IS_RSTREGB_INVERTED(1'b0),
    .RAM_EXTENSION_A("NONE"),
    .RAM_EXTENSION_B("NONE"),
    .RAM_MODE("TDP"),
    .RDADDR_COLLISION_HWCONFIG("DELAYED_WRITE"),
    .READ_WIDTH_A(2),
    .READ_WIDTH_B(2),
    .RSTREG_PRIORITY_A("REGCE"),
    .RSTREG_PRIORITY_B("REGCE"),
    .SIM_COLLISION_CHECK("ALL"),
    .SIM_DEVICE("7SERIES"),
    .SRVAL_A(36'h000000000),
    .SRVAL_B(36'h000000000),
    .WRITE_MODE_A("WRITE_FIRST"),
    .WRITE_MODE_B("WRITE_FIRST"),
    .WRITE_WIDTH_A(2),
    .WRITE_WIDTH_B(2)) 
    \DEVICE_7SERIES.NO_BMM_INFO.SDP.SIMPLE_PRIM36.ram 
       (.ADDRARDADDR({1'b1,Q,1'b1}),
        .ADDRBWRADDR({1'b1,\DEVICE_7SERIES.NO_BMM_INFO.SDP.SIMPLE_PRIM36.ram_2 ,1'b1}),
        .CASCADEINA(1'b0),
        .CASCADEINB(1'b0),
        .CASCADEOUTA(\NLW_DEVICE_7SERIES.NO_BMM_INFO.SDP.SIMPLE_PRIM36.ram_CASCADEOUTA_UNCONNECTED ),
        .CASCADEOUTB(\NLW_DEVICE_7SERIES.NO_BMM_INFO.SDP.SIMPLE_PRIM36.ram_CASCADEOUTB_UNCONNECTED ),
        .CLKARDCLK(clk),
        .CLKBWRCLK(clk),
        .DBITERR(\NLW_DEVICE_7SERIES.NO_BMM_INFO.SDP.SIMPLE_PRIM36.ram_DBITERR_UNCONNECTED ),
        .DIADI({1'b0,1'b0,1'b0,1'b0,1'b0,1'b0,1'b0,1'b0,1'b0,1'b0,1'b0,1'b0,1'b0,1'b0,1'b0,1'b0,1'b0,1'b0,1'b0,1'b0,1'b0,1'b0,1'b0,1'b0,1'b0,1'b0,1'b0,1'b0,1'b0,1'b0,din}),
        .DIBDI({1'b0,1'b0,1'b0,1'b0,1'b0,1'b0,1'b0,1'b0,1'b0,1'b0,1'b0,1'b0,1'b0,1'b0,1'b0,1'b0,1'b0,1'b0,1'b0,1'b0,1'b0,1'b0,1'b0,1'b0,1'b0,1'b0,1'b0,1'b0,1'b0,1'b0,1'b0,1'b0}),
        .DIPADIP({1'b0,1'b0,1'b0,1'b0}),
        .DIPBDIP({1'b0,1'b0,1'b0,1'b0}),
        .DOADO(\NLW_DEVICE_7SERIES.NO_BMM_INFO.SDP.SIMPLE_PRIM36.ram_DOADO_UNCONNECTED [31:0]),
        .DOBDO({\NLW_DEVICE_7SERIES.NO_BMM_INFO.SDP.SIMPLE_PRIM36.ram_DOBDO_UNCONNECTED [31:2],dout}),
        .DOPADOP(\NLW_DEVICE_7SERIES.NO_BMM_INFO.SDP.SIMPLE_PRIM36.ram_DOPADOP_UNCONNECTED [3:0]),
        .DOPBDOP(\NLW_DEVICE_7SERIES.NO_BMM_INFO.SDP.SIMPLE_PRIM36.ram_DOPBDOP_UNCONNECTED [3:0]),
        .ECCPARITY(\NLW_DEVICE_7SERIES.NO_BMM_INFO.SDP.SIMPLE_PRIM36.ram_ECCPARITY_UNCONNECTED [7:0]),
        .ENARDEN(\DEVICE_7SERIES.NO_BMM_INFO.SDP.SIMPLE_PRIM36.ram_0 ),
        .ENBWREN(\DEVICE_7SERIES.NO_BMM_INFO.SDP.SIMPLE_PRIM36.ram_1 ),
        .INJECTDBITERR(1'b0),
        .INJECTSBITERR(1'b0),
        .RDADDRECC(\NLW_DEVICE_7SERIES.NO_BMM_INFO.SDP.SIMPLE_PRIM36.ram_RDADDRECC_UNCONNECTED [8:0]),
        .REGCEAREGCE(1'b0),
        .REGCEB(1'b0),
        .RSTRAMARSTRAM(1'b0),
        .RSTRAMB(srst),
        .RSTREGARSTREG(1'b0),
        .RSTREGB(1'b0),
        .SBITERR(\NLW_DEVICE_7SERIES.NO_BMM_INFO.SDP.SIMPLE_PRIM36.ram_SBITERR_UNCONNECTED ),
        .WEA({\DEVICE_7SERIES.NO_BMM_INFO.SDP.SIMPLE_PRIM36.ram_3 ,\DEVICE_7SERIES.NO_BMM_INFO.SDP.SIMPLE_PRIM36.ram_3 ,\DEVICE_7SERIES.NO_BMM_INFO.SDP.SIMPLE_PRIM36.ram_3 ,\DEVICE_7SERIES.NO_BMM_INFO.SDP.SIMPLE_PRIM36.ram_3 }),
        .WEBWE({1'b0,1'b0,1'b0,1'b0,1'b0,1'b0,1'b0,1'b0}));
endmodule
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
