alwaysmy/Artix-7_GTP_USB3_WCH_MCU/2_Firmware/Artix-7_GTP_USB3_WCH_MCU_XillyUSB-USBC_SpeedTest/vivado-essentials/fifo_32/fifo_32_sim_netlist.vhdl

-- Copyright 1986-2019 Xilinx, Inc. All Rights Reserved.
-- --------------------------------------------------------------------------------
-- Tool Version: Vivado v.2018.3.1 (win64) Build 2489853 Tue Mar 26 04:20:25 MDT 2019
-- Date        : Mon May 19 22:49:03 2025
-- Host        : TS-Always running 64-bit major release  (build 9200)
-- Command     : write_vhdl -force -mode funcsim
--               D:/MyProjects/2_MyDesigns/USB3_Artix_GTP/xillyusb-bundle-artix7-trenz-1.10/vivado-essentials/fifo_32/fifo_32_sim_netlist.vhdl
-- Design      : fifo_32
-- Purpose     : This VHDL netlist is a functional simulation representation of the design and should not be modified or
--               synthesized. This netlist cannot be used for SDF annotated simulation.
-- Device      : xc7a35tcsg325-2
-- --------------------------------------------------------------------------------
library IEEE;
use IEEE.STD_LOGIC_1164.ALL;
library UNISIM;
use UNISIM.VCOMPONENTS.ALL;
entity \fifo_32_blk_mem_gen_mux__parameterized0\ is
  port (
    dout : out STD_LOGIC_VECTOR ( 26 downto 0 );
    \no_softecc_sel_reg.ce_pri.sel_pipe_reg[1]_0\ : in STD_LOGIC_VECTOR ( 1 downto 0 );
    \out\ : in STD_LOGIC;
    rd_en : in STD_LOGIC;
    srst : in STD_LOGIC;
    clk : in STD_LOGIC;
    DOPBDOP : in STD_LOGIC_VECTOR ( 0 to 0 );
    \dout[31]\ : in STD_LOGIC_VECTOR ( 0 to 0 );
    \dout[31]_0\ : in STD_LOGIC_VECTOR ( 0 to 0 );
    \dout[31]_1\ : in STD_LOGIC_VECTOR ( 0 to 0 );
    DOBDO : in STD_LOGIC_VECTOR ( 7 downto 0 );
    \dout[30]\ : in STD_LOGIC_VECTOR ( 7 downto 0 );
    \dout[30]_0\ : in STD_LOGIC_VECTOR ( 7 downto 0 );
    \dout[30]_1\ : in STD_LOGIC_VECTOR ( 7 downto 0 );
    \dout[22]\ : in STD_LOGIC_VECTOR ( 0 to 0 );
    \dout[22]_0\ : in STD_LOGIC_VECTOR ( 0 to 0 );
    \dout[22]_1\ : in STD_LOGIC_VECTOR ( 0 to 0 );
    \dout[22]_2\ : in STD_LOGIC_VECTOR ( 0 to 0 );
    \dout[21]\ : in STD_LOGIC_VECTOR ( 7 downto 0 );
    \dout[21]_0\ : in STD_LOGIC_VECTOR ( 7 downto 0 );
    \dout[21]_1\ : in STD_LOGIC_VECTOR ( 7 downto 0 );
    \dout[21]_2\ : in STD_LOGIC_VECTOR ( 7 downto 0 );
    \dout[13]\ : in STD_LOGIC_VECTOR ( 0 to 0 );
    \dout[13]_0\ : in STD_LOGIC_VECTOR ( 0 to 0 );
    \dout[13]_1\ : in STD_LOGIC_VECTOR ( 0 to 0 );
    \dout[13]_2\ : in STD_LOGIC_VECTOR ( 0 to 0 );
    \dout[12]\ : in STD_LOGIC_VECTOR ( 7 downto 0 );
    \dout[12]_0\ : in STD_LOGIC_VECTOR ( 7 downto 0 );
    \dout[12]_1\ : in STD_LOGIC_VECTOR ( 7 downto 0 );
    \dout[12]_2\ : in STD_LOGIC_VECTOR ( 7 downto 0 )
  );
  attribute ORIG_REF_NAME : string;
  attribute ORIG_REF_NAME of \fifo_32_blk_mem_gen_mux__parameterized0\ : entity is "blk_mem_gen_mux";
end \fifo_32_blk_mem_gen_mux__parameterized0\;

architecture STRUCTURE of \fifo_32_blk_mem_gen_mux__parameterized0\ is
  signal \no_softecc_sel_reg.ce_pri.sel_pipe[0]_i_1_n_0\ : STD_LOGIC;
  signal \no_softecc_sel_reg.ce_pri.sel_pipe[1]_i_1_n_0\ : STD_LOGIC;
  signal sel_pipe : STD_LOGIC_VECTOR ( 1 downto 0 );
begin
\dout[10]_INST_0\: unisim.vcomponents.LUT6
    generic map(
      INIT => X"CCFFAAF0CC00AAF0"
    )
        port map (
      I0 => \dout[12]\(5),
      I1 => \dout[12]_0\(5),
      I2 => \dout[12]_1\(5),
      I3 => sel_pipe(1),
      I4 => sel_pipe(0),
      I5 => \dout[12]_2\(5),
      O => dout(5)
    );
\dout[11]_INST_0\: unisim.vcomponents.LUT6
    generic map(
      INIT => X"CCFFAAF0CC00AAF0"
    )
        port map (
      I0 => \dout[12]\(6),
      I1 => \dout[12]_0\(6),
      I2 => \dout[12]_1\(6),
      I3 => sel_pipe(1),
      I4 => sel_pipe(0),
      I5 => \dout[12]_2\(6),
      O => dout(6)
    );
\dout[12]_INST_0\: unisim.vcomponents.LUT6
    generic map(
      INIT => X"CCFFAAF0CC00AAF0"
    )
        port map (
      I0 => \dout[12]\(7),
      I1 => \dout[12]_0\(7),
      I2 => \dout[12]_1\(7),
      I3 => sel_pipe(1),
      I4 => sel_pipe(0),
      I5 => \dout[12]_2\(7),
      O => dout(7)
    );
\dout[13]_INST_0\: unisim.vcomponents.LUT6
    generic map(
      INIT => X"CCFFAAF0CC00AAF0"
    )
        port map (
      I0 => \dout[13]\(0),
      I1 => \dout[13]_0\(0),
      I2 => \dout[13]_1\(0),
      I3 => sel_pipe(1),
      I4 => sel_pipe(0),
      I5 => \dout[13]_2\(0),
      O => dout(8)
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
    generic map(
      INIT => X"AAEFAA20"
    )
        port map (
      I0 => \no_softecc_sel_reg.ce_pri.sel_pipe_reg[1]_0\(0),
      I1 => \out\,
      I2 => rd_en,
      I3 => srst,
      I4 => sel_pipe(0),
      O => \no_softecc_sel_reg.ce_pri.sel_pipe[0]_i_1_n_0\
    );
\no_softecc_sel_reg.ce_pri.sel_pipe[1]_i_1\: unisim.vcomponents.LUT5
    generic map(
      INIT => X"AAEFAA20"
    )
        port map (
      I0 => \no_softecc_sel_reg.ce_pri.sel_pipe_reg[1]_0\(1),
      I1 => \out\,
      I2 => rd_en,
      I3 => srst,
      I4 => sel_pipe(1),
      O => \no_softecc_sel_reg.ce_pri.sel_pipe[1]_i_1_n_0\
    );
\no_softecc_sel_reg.ce_pri.sel_pipe_reg[0]\: unisim.vcomponents.FDRE
    generic map(
      INIT => '0'
    )
        port map (
      C => clk,
      CE => '1',
      D => \no_softecc_sel_reg.ce_pri.sel_pipe[0]_i_1_n_0\,
      Q => sel_pipe(0),
      R => '0'
    );
\no_softecc_sel_reg.ce_pri.sel_pipe_reg[1]\: unisim.vcomponents.FDRE
    generic map(
      INIT => '0'
    )
        port map (
      C => clk,
      CE => '1',
      D => \no_softecc_sel_reg.ce_pri.sel_pipe[1]_i_1_n_0\,
      Q => sel_pipe(1),
      R => '0'
    );
end STRUCTURE;
library IEEE;
use IEEE.STD_LOGIC_1164.ALL;
library UNISIM;
use UNISIM.VCOMPONENTS.ALL;
entity fifo_32_blk_mem_gen_prim_wrapper is
  port (
    dout : out STD_LOGIC_VECTOR ( 0 to 0 );
    clk : in STD_LOGIC;
    \DEVICE_7SERIES.NO_BMM_INFO.SDP.SIMPLE_PRIM18.ram_0\ : in STD_LOGIC;
    \DEVICE_7SERIES.NO_BMM_INFO.SDP.SIMPLE_PRIM18.ram_1\ : in STD_LOGIC;
    srst : in STD_LOGIC;
    Q : in STD_LOGIC_VECTOR ( 13 downto 0 );
    \DEVICE_7SERIES.NO_BMM_INFO.SDP.SIMPLE_PRIM18.ram_2\ : in STD_LOGIC_VECTOR ( 13 downto 0 );
    din : in STD_LOGIC_VECTOR ( 0 to 0 );
    \DEVICE_7SERIES.NO_BMM_INFO.SDP.SIMPLE_PRIM18.ram_3\ : in STD_LOGIC_VECTOR ( 0 to 0 )
  );
  attribute ORIG_REF_NAME : string;
  attribute ORIG_REF_NAME of fifo_32_blk_mem_gen_prim_wrapper : entity is "blk_mem_gen_prim_wrapper";
end fifo_32_blk_mem_gen_prim_wrapper;

architecture STRUCTURE of fifo_32_blk_mem_gen_prim_wrapper is
  signal \NLW_DEVICE_7SERIES.NO_BMM_INFO.SDP.SIMPLE_PRIM18.ram_DOADO_UNCONNECTED\ : STD_LOGIC_VECTOR ( 15 downto 0 );
  signal \NLW_DEVICE_7SERIES.NO_BMM_INFO.SDP.SIMPLE_PRIM18.ram_DOBDO_UNCONNECTED\ : STD_LOGIC_VECTOR ( 15 downto 1 );
  signal \NLW_DEVICE_7SERIES.NO_BMM_INFO.SDP.SIMPLE_PRIM18.ram_DOPADOP_UNCONNECTED\ : STD_LOGIC_VECTOR ( 1 downto 0 );
  signal \NLW_DEVICE_7SERIES.NO_BMM_INFO.SDP.SIMPLE_PRIM18.ram_DOPBDOP_UNCONNECTED\ : STD_LOGIC_VECTOR ( 1 downto 0 );
  attribute box_type : string;
  attribute box_type of \DEVICE_7SERIES.NO_BMM_INFO.SDP.SIMPLE_PRIM18.ram\ : label is "PRIMITIVE";
begin
\DEVICE_7SERIES.NO_BMM_INFO.SDP.SIMPLE_PRIM18.ram\: unisim.vcomponents.RAMB18E1
    generic map(
      DOA_REG => 0,
      DOB_REG => 0,
      INITP_00 => X"0000000000000000000000000000000000000000000000000000000000000000",
      INITP_01 => X"0000000000000000000000000000000000000000000000000000000000000000",
      INITP_02 => X"0000000000000000000000000000000000000000000000000000000000000000",
      INITP_03 => X"0000000000000000000000000000000000000000000000000000000000000000",
      INITP_04 => X"0000000000000000000000000000000000000000000000000000000000000000",
      INITP_05 => X"0000000000000000000000000000000000000000000000000000000000000000",
      INITP_06 => X"0000000000000000000000000000000000000000000000000000000000000000",
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
      INIT_30 => X"0000000000000000000000000000000000000000000000000000000000000000",
      INIT_31 => X"0000000000000000000000000000000000000000000000000000000000000000",
      INIT_32 => X"0000000000000000000000000000000000000000000000000000000000000000",
      INIT_33 => X"0000000000000000000000000000000000000000000000000000000000000000",
      INIT_34 => X"0000000000000000000000000000000000000000000000000000000000000000",
      INIT_35 => X"0000000000000000000000000000000000000000000000000000000000000000",
      INIT_36 => X"0000000000000000000000000000000000000000000000000000000000000000",
      INIT_37 => X"0000000000000000000000000000000000000000000000000000000000000000",
      INIT_38 => X"0000000000000000000000000000000000000000000000000000000000000000",
      INIT_39 => X"0000000000000000000000000000000000000000000000000000000000000000",
      INIT_3A => X"0000000000000000000000000000000000000000000000000000000000000000",
      INIT_3B => X"0000000000000000000000000000000000000000000000000000000000000000",
      INIT_3C => X"0000000000000000000000000000000000000000000000000000000000000000",
      INIT_3D => X"0000000000000000000000000000000000000000000000000000000000000000",
      INIT_3E => X"0000000000000000000000000000000000000000000000000000000000000000",
      INIT_3F => X"0000000000000000000000000000000000000000000000000000000000000000",
      INIT_A => X"00000",
      INIT_B => X"00000",
      INIT_FILE => "NONE",
      IS_CLKARDCLK_INVERTED => '0',
      IS_CLKBWRCLK_INVERTED => '0',
      IS_ENARDEN_INVERTED => '0',
      IS_ENBWREN_INVERTED => '0',
      IS_RSTRAMARSTRAM_INVERTED => '0',
      IS_RSTRAMB_INVERTED => '0',
      IS_RSTREGARSTREG_INVERTED => '0',
      IS_RSTREGB_INVERTED => '0',
      RAM_MODE => "TDP",
      RDADDR_COLLISION_HWCONFIG => "DELAYED_WRITE",
      READ_WIDTH_A => 1,
      READ_WIDTH_B => 1,
      RSTREG_PRIORITY_A => "REGCE",
      RSTREG_PRIORITY_B => "REGCE",
      SIM_COLLISION_CHECK => "ALL",
      SIM_DEVICE => "7SERIES",
      SRVAL_A => X"00000",
      SRVAL_B => X"00000",
      WRITE_MODE_A => "WRITE_FIRST",
      WRITE_MODE_B => "WRITE_FIRST",
      WRITE_WIDTH_A => 1,
      WRITE_WIDTH_B => 1
    )
        port map (
      ADDRARDADDR(13 downto 0) => Q(13 downto 0),
      ADDRBWRADDR(13 downto 0) => \DEVICE_7SERIES.NO_BMM_INFO.SDP.SIMPLE_PRIM18.ram_2\(13 downto 0),
      CLKARDCLK => clk,
      CLKBWRCLK => clk,
      DIADI(15 downto 1) => B"000000000000000",
      DIADI(0) => din(0),
      DIBDI(15 downto 0) => B"0000000000000000",
      DIPADIP(1 downto 0) => B"00",
      DIPBDIP(1 downto 0) => B"00",
      DOADO(15 downto 0) => \NLW_DEVICE_7SERIES.NO_BMM_INFO.SDP.SIMPLE_PRIM18.ram_DOADO_UNCONNECTED\(15 downto 0),
      DOBDO(15 downto 1) => \NLW_DEVICE_7SERIES.NO_BMM_INFO.SDP.SIMPLE_PRIM18.ram_DOBDO_UNCONNECTED\(15 downto 1),
      DOBDO(0) => dout(0),
      DOPADOP(1 downto 0) => \NLW_DEVICE_7SERIES.NO_BMM_INFO.SDP.SIMPLE_PRIM18.ram_DOPADOP_UNCONNECTED\(1 downto 0),
      DOPBDOP(1 downto 0) => \NLW_DEVICE_7SERIES.NO_BMM_INFO.SDP.SIMPLE_PRIM18.ram_DOPBDOP_UNCONNECTED\(1 downto 0),
      ENARDEN => \DEVICE_7SERIES.NO_BMM_INFO.SDP.SIMPLE_PRIM18.ram_0\,
      ENBWREN => \DEVICE_7SERIES.NO_BMM_INFO.SDP.SIMPLE_PRIM18.ram_1\,
      REGCEAREGCE => '0',
      REGCEB => '0',
      RSTRAMARSTRAM => '0',
      RSTRAMB => srst,
      RSTREGARSTREG => '0',
      RSTREGB => '0',
      WEA(1) => \DEVICE_7SERIES.NO_BMM_INFO.SDP.SIMPLE_PRIM18.ram_3\(0),
      WEA(0) => \DEVICE_7SERIES.NO_BMM_INFO.SDP.SIMPLE_PRIM18.ram_3\(0),
      WEBWE(3 downto 0) => B"0000"
    );
end STRUCTURE;
library IEEE;
use IEEE.STD_LOGIC_1164.ALL;
library UNISIM;
use UNISIM.VCOMPONENTS.ALL;
entity \fifo_32_blk_mem_gen_prim_wrapper__parameterized0\ is
  port (
    dout : out STD_LOGIC_VECTOR ( 1 downto 0 );
    clk : in STD_LOGIC;
    \DEVICE_7SERIES.NO_BMM_INFO.SDP.SIMPLE_PRIM36.ram_0\ : in STD_LOGIC;
    \DEVICE_7SERIES.NO_BMM_INFO.SDP.SIMPLE_PRIM36.ram_1\ : in STD_LOGIC;
    srst : in STD_LOGIC;
    Q : in STD_LOGIC_VECTOR ( 13 downto 0 );
    \DEVICE_7SERIES.NO_BMM_INFO.SDP.SIMPLE_PRIM36.ram_2\ : in STD_LOGIC_VECTOR ( 13 downto 0 );
    din : in STD_LOGIC_VECTOR ( 1 downto 0 );
    \DEVICE_7SERIES.NO_BMM_INFO.SDP.SIMPLE_PRIM36.ram_3\ : in STD_LOGIC_VECTOR ( 0 to 0 )
  );
  attribute ORIG_REF_NAME : string;
  attribute ORIG_REF_NAME of \fifo_32_blk_mem_gen_prim_wrapper__parameterized0\ : entity is "blk_mem_gen_prim_wrapper";
end \fifo_32_blk_mem_gen_prim_wrapper__parameterized0\;

architecture STRUCTURE of \fifo_32_blk_mem_gen_prim_wrapper__parameterized0\ is
  signal \NLW_DEVICE_7SERIES.NO_BMM_INFO.SDP.SIMPLE_PRIM36.ram_CASCADEOUTA_UNCONNECTED\ : STD_LOGIC;
  signal \NLW_DEVICE_7SERIES.NO_BMM_INFO.SDP.SIMPLE_PRIM36.ram_CASCADEOUTB_UNCONNECTED\ : STD_LOGIC;
  signal \NLW_DEVICE_7SERIES.NO_BMM_INFO.SDP.SIMPLE_PRIM36.ram_DBITERR_UNCONNECTED\ : STD_LOGIC;
  signal \NLW_DEVICE_7SERIES.NO_BMM_INFO.SDP.SIMPLE_PRIM36.ram_SBITERR_UNCONNECTED\ : STD_LOGIC;
  signal \NLW_DEVICE_7SERIES.NO_BMM_INFO.SDP.SIMPLE_PRIM36.ram_DOADO_UNCONNECTED\ : STD_LOGIC_VECTOR ( 31 downto 0 );
  signal \NLW_DEVICE_7SERIES.NO_BMM_INFO.SDP.SIMPLE_PRIM36.ram_DOBDO_UNCONNECTED\ : STD_LOGIC_VECTOR ( 31 downto 2 );
  signal \NLW_DEVICE_7SERIES.NO_BMM_INFO.SDP.SIMPLE_PRIM36.ram_DOPADOP_UNCONNECTED\ : STD_LOGIC_VECTOR ( 3 downto 0 );
  signal \NLW_DEVICE_7SERIES.NO_BMM_INFO.SDP.SIMPLE_PRIM36.ram_DOPBDOP_UNCONNECTED\ : STD_LOGIC_VECTOR ( 3 downto 0 );
  signal \NLW_DEVICE_7SERIES.NO_BMM_INFO.SDP.SIMPLE_PRIM36.ram_ECCPARITY_UNCONNECTED\ : STD_LOGIC_VECTOR ( 7 downto 0 );
  signal \NLW_DEVICE_7SERIES.NO_BMM_INFO.SDP.SIMPLE_PRIM36.ram_RDADDRECC_UNCONNECTED\ : STD_LOGIC_VECTOR ( 8 downto 0 );
  attribute box_type : string;
  attribute box_type of \DEVICE_7SERIES.NO_BMM_INFO.SDP.SIMPLE_PRIM36.ram\ : label is "PRIMITIVE";
begin
\DEVICE_7SERIES.NO_BMM_INFO.SDP.SIMPLE_PRIM36.ram\: unisim.vcomponents.RAMB36E1
    generic map(
      DOA_REG => 0,
      DOB_REG => 0,
      EN_ECC_READ => false,
      EN_ECC_WRITE => false,
      INITP_00 => X"0000000000000000000000000000000000000000000000000000000000000000",
      INITP_01 => X"0000000000000000000000000000000000000000000000000000000000000000",
      INITP_02 => X"0000000000000000000000000000000000000000000000000000000000000000",
      INITP_03 => X"0000000000000000000000000000000000000000000000000000000000000000",
      INITP_04 => X"0000000000000000000000000000000000000000000000000000000000000000",
      INITP_05 => X"0000000000000000000000000000000000000000000000000000000000000000",
      INITP_06 => X"0000000000000000000000000000000000000000000000000000000000000000",
      INITP_07 => X"0000000000000000000000000000000000000000000000000000000000000000",
      INITP_08 => X"0000000000000000000000000000000000000000000000000000000000000000",
      INITP_09 => X"0000000000000000000000000000000000000000000000000000000000000000",
      INITP_0A => X"0000000000000000000000000000000000000000000000000000000000000000",
      INITP_0B => X"0000000000000000000000000000000000000000000000000000000000000000",
      INITP_0C => X"0000000000000000000000000000000000000000000000000000000000000000",
      INITP_0D => X"0000000000000000000000000000000000000000000000000000000000000000",
      INITP_0E => X"0000000000000000000000000000000000000000000000000000000000000000",
      INITP_0F => X"0000000000000000000000000000000000000000000000000000000000000000",
      INIT_00 => X"0000000000000000000000000000000000000000000000000000000000000000",
      INIT_01 => X"0000000000000000000000000000000000000000000000000000000000000000",
      INIT_02 => X"0000000000000000000000000000000000000000000000000000000000000000",
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
      INIT_77 => X"0000000000000000000000000000000000000000000000000000000000000000",
      INIT_78 => X"0000000000000000000000000000000000000000000000000000000000000000",
      INIT_79 => X"0000000000000000000000000000000000000000000000000000000000000000",
      INIT_7A => X"0000000000000000000000000000000000000000000000000000000000000000",
      INIT_7B => X"0000000000000000000000000000000000000000000000000000000000000000",
      INIT_7C => X"0000000000000000000000000000000000000000000000000000000000000000",
      INIT_7D => X"0000000000000000000000000000000000000000000000000000000000000000",
      INIT_7E => X"0000000000000000000000000000000000000000000000000000000000000000",
      INIT_7F => X"0000000000000000000000000000000000000000000000000000000000000000",
      INIT_A => X"000000000",
      INIT_B => X"000000000",
      INIT_FILE => "NONE",
      IS_CLKARDCLK_INVERTED => '0',
      IS_CLKBWRCLK_INVERTED => '0',
      IS_ENARDEN_INVERTED => '0',
      IS_ENBWREN_INVERTED => '0',
      IS_RSTRAMARSTRAM_INVERTED => '0',
      IS_RSTRAMB_INVERTED => '0',
      IS_RSTREGARSTREG_INVERTED => '0',
      IS_RSTREGB_INVERTED => '0',
      RAM_EXTENSION_A => "NONE",
      RAM_EXTENSION_B => "NONE",
      RAM_MODE => "TDP",
      RDADDR_COLLISION_HWCONFIG => "DELAYED_WRITE",
      READ_WIDTH_A => 2,
      READ_WIDTH_B => 2,
      RSTREG_PRIORITY_A => "REGCE",
      RSTREG_PRIORITY_B => "REGCE",
      SIM_COLLISION_CHECK => "ALL",
      SIM_DEVICE => "7SERIES",
      SRVAL_A => X"000000000",
      SRVAL_B => X"000000000",
      WRITE_MODE_A => "WRITE_FIRST",
      WRITE_MODE_B => "WRITE_FIRST",
      WRITE_WIDTH_A => 2,
      WRITE_WIDTH_B => 2
    )
        port map (
      ADDRARDADDR(15) => '1',
      ADDRARDADDR(14 downto 1) => Q(13 downto 0),
      ADDRARDADDR(0) => '1',
      ADDRBWRADDR(15) => '1',
      ADDRBWRADDR(14 downto 1) => \DEVICE_7SERIES.NO_BMM_INFO.SDP.SIMPLE_PRIM36.ram_2\(13 downto 0),
      ADDRBWRADDR(0) => '1',
      CASCADEINA => '0',
      CASCADEINB => '0',
      CASCADEOUTA => \NLW_DEVICE_7SERIES.NO_BMM_INFO.SDP.SIMPLE_PRIM36.ram_CASCADEOUTA_UNCONNECTED\,
      CASCADEOUTB => \NLW_DEVICE_7SERIES.NO_BMM_INFO.SDP.SIMPLE_PRIM36.ram_CASCADEOUTB_UNCONNECTED\,
      CLKARDCLK => clk,
      CLKBWRCLK => clk,
      DBITERR => \NLW_DEVICE_7SERIES.NO_BMM_INFO.SDP.SIMPLE_PRIM36.ram_DBITERR_UNCONNECTED\,
      DIADI(31 downto 2) => B"000000000000000000000000000000",
      DIADI(1 downto 0) => din(1 downto 0),
      DIBDI(31 downto 0) => B"00000000000000000000000000000000",
      DIPADIP(3 downto 0) => B"0000",
      DIPBDIP(3 downto 0) => B"0000",
      DOADO(31 downto 0) => \NLW_DEVICE_7SERIES.NO_BMM_INFO.SDP.SIMPLE_PRIM36.ram_DOADO_UNCONNECTED\(31 downto 0),
      DOBDO(31 downto 2) => \NLW_DEVICE_7SERIES.NO_BMM_INFO.SDP.SIMPLE_PRIM36.ram_DOBDO_UNCONNECTED\(31 downto 2),
      DOBDO(1 downto 0) => dout(1 downto 0),
      DOPADOP(3 downto 0) => \NLW_DEVICE_7SERIES.NO_BMM_INFO.SDP.SIMPLE_PRIM36.ram_DOPADOP_UNCONNECTED\(3 downto 0),
      DOPBDOP(3 downto 0) => \NLW_DEVICE_7SERIES.NO_BMM_INFO.SDP.SIMPLE_PRIM36.ram_DOPBDOP_UNCONNECTED\(3 downto 0),
      ECCPARITY(7 downto 0) => \NLW_DEVICE_7SERIES.NO_BMM_INFO.SDP.SIMPLE_PRIM36.ram_ECCPARITY_UNCONNECTED\(7 downto 0),
      ENARDEN => \DEVICE_7SERIES.NO_BMM_INFO.SDP.SIMPLE_PRIM36.ram_0\,
      ENBWREN => \DEVICE_7SERIES.NO_BMM_INFO.SDP.SIMPLE_PRIM36.ram_1\,
      INJECTDBITERR => '0',
      INJECTSBITERR => '0',
      RDADDRECC(8 downto 0) => \NLW_DEVICE_7SERIES.NO_BMM_INFO.SDP.SIMPLE_PRIM36.ram_RDADDRECC_UNCONNECTED\(8 downto 0),
      REGCEAREGCE => '0',
      REGCEB => '0',
      RSTRAMARSTRAM => '0',
      RSTRAMB => srst,
      RSTREGARSTREG => '0',
      RSTREGB => '0',
      SBITERR => \NLW_DEVICE_7SERIES.NO_BMM_INFO.SDP.SIMPLE_PRIM36.ram_SBITERR_UNCONNECTED\,
      WEA(3) => \DEVICE_7SERIES.NO_BMM_INFO.SDP.SIMPLE_PRIM36.ram_3\(0),
      WEA(2) => \DEVICE_7SERIES.NO_BMM_INFO.SDP.SIMPLE_PRIM36.ram_3\(0),
      WEA(1) => \DEVICE_7SERIES.NO_BMM_INFO.SDP.SIMPLE_PRIM36.ram_3\(0),
      WEA(0) => \DEVICE_7SERIES.NO_BMM_INFO.SDP.SIMPLE_PRIM36.ram_3\(0),
      WEBWE(7 downto 0) => B"00000000"
    );
end STRUCTURE;
library IEEE;
use IEEE.STD_LOGIC_1164.ALL;
library UNISIM;
use UNISIM.VCOMPONENTS.ALL;
entity \fifo_32_blk_mem_gen_prim_wrapper__parameterized1\ is
  port (
    dout : out STD_LOGIC_VECTOR ( 1 downto 0 );
    clk : in STD_LOGIC;
    \DEVICE_7SERIES.NO_BMM_INFO.SDP.SIMPLE_PRIM36.ram_0\ : in STD_LOGIC;
    \DEVICE_7SERIES.NO_BMM_INFO.SDP.SIMPLE_PRIM36.ram_1\ : in STD_LOGIC;
    srst : in STD_LOGIC;
    Q : in STD_LOGIC_VECTOR ( 13 downto 0 );
    \DEVICE_7SERIES.NO_BMM_INFO.SDP.SIMPLE_PRIM36.ram_2\ : in STD_LOGIC_VECTOR ( 13 downto 0 );
    din : in STD_LOGIC_VECTOR ( 1 downto 0 );
    \DEVICE_7SERIES.NO_BMM_INFO.SDP.SIMPLE_PRIM36.ram_3\ : in STD_LOGIC_VECTOR ( 0 to 0 )
  );
  attribute ORIG_REF_NAME : string;
  attribute ORIG_REF_NAME of \fifo_32_blk_mem_gen_prim_wrapper__parameterized1\ : entity is "blk_mem_gen_prim_wrapper";
end \fifo_32_blk_mem_gen_prim_wrapper__parameterized1\;

architecture STRUCTURE of \fifo_32_blk_mem_gen_prim_wrapper__parameterized1\ is
  signal \NLW_DEVICE_7SERIES.NO_BMM_INFO.SDP.SIMPLE_PRIM36.ram_CASCADEOUTA_UNCONNECTED\ : STD_LOGIC;
  signal \NLW_DEVICE_7SERIES.NO_BMM_INFO.SDP.SIMPLE_PRIM36.ram_CASCADEOUTB_UNCONNECTED\ : STD_LOGIC;
  signal \NLW_DEVICE_7SERIES.NO_BMM_INFO.SDP.SIMPLE_PRIM36.ram_DBITERR_UNCONNECTED\ : STD_LOGIC;
  signal \NLW_DEVICE_7SERIES.NO_BMM_INFO.SDP.SIMPLE_PRIM36.ram_SBITERR_UNCONNECTED\ : STD_LOGIC;
  signal \NLW_DEVICE_7SERIES.NO_BMM_INFO.SDP.SIMPLE_PRIM36.ram_DOADO_UNCONNECTED\ : STD_LOGIC_VECTOR ( 31 downto 0 );
  signal \NLW_DEVICE_7SERIES.NO_BMM_INFO.SDP.SIMPLE_PRIM36.ram_DOBDO_UNCONNECTED\ : STD_LOGIC_VECTOR ( 31 downto 2 );
  signal \NLW_DEVICE_7SERIES.NO_BMM_INFO.SDP.SIMPLE_PRIM36.ram_DOPADOP_UNCONNECTED\ : STD_LOGIC_VECTOR ( 3 downto 0 );
  signal \NLW_DEVICE_7SERIES.NO_BMM_INFO.SDP.SIMPLE_PRIM36.ram_DOPBDOP_UNCONNECTED\ : STD_LOGIC_VECTOR ( 3 downto 0 );
  signal \NLW_DEVICE_7SERIES.NO_BMM_INFO.SDP.SIMPLE_PRIM36.ram_ECCPARITY_UNCONNECTED\ : STD_LOGIC_VECTOR ( 7 downto 0 );
  signal \NLW_DEVICE_7SERIES.NO_BMM_INFO.SDP.SIMPLE_PRIM36.ram_RDADDRECC_UNCONNECTED\ : STD_LOGIC_VECTOR ( 8 downto 0 );
  attribute box_type : string;
  attribute box_type of \DEVICE_7SERIES.NO_BMM_INFO.SDP.SIMPLE_PRIM36.ram\ : label is "PRIMITIVE";
begin
\DEVICE_7SERIES.NO_BMM_INFO.SDP.SIMPLE_PRIM36.ram\: unisim.vcomponents.RAMB36E1
    generic map(
      DOA_REG => 0,
      DOB_REG => 0,
      EN_ECC_READ => false,
      EN_ECC_WRITE => false,
      INITP_00 => X"0000000000000000000000000000000000000000000000000000000000000000",
      INITP_01 => X"0000000000000000000000000000000000000000000000000000000000000000",
      INITP_02 => X"0000000000000000000000000000000000000000000000000000000000000000",
      INITP_03 => X"0000000000000000000000000000000000000000000000000000000000000000",
      INITP_04 => X"0000000000000000000000000000000000000000000000000000000000000000",
      INITP_05 => X"0000000000000000000000000000000000000000000000000000000000000000",
      INITP_06 => X"0000000000000000000000000000000000000000000000000000000000000000",
      INITP_07 => X"0000000000000000000000000000000000000000000000000000000000000000",
      INITP_08 => X"0000000000000000000000000000000000000000000000000000000000000000",
      INITP_09 => X"0000000000000000000000000000000000000000000000000000000000000000",
      INITP_0A => X"0000000000000000000000000000000000000000000000000000000000000000",
      INITP_0B => X"0000000000000000000000000000000000000000000000000000000000000000",
      INITP_0C => X"0000000000000000000000000000000000000000000000000000000000000000",
      INITP_0D => X"0000000000000000000000000000000000000000000000000000000000000000",
      INITP_0E => X"0000000000000000000000000000000000000000000000000000000000000000",
      INITP_0F => X"0000000000000000000000000000000000000000000000000000000000000000",
      INIT_00 => X"0000000000000000000000000000000000000000000000000000000000000000",
      INIT_01 => X"0000000000000000000000000000000000000000000000000000000000000000",
      INIT_02 => X"0000000000000000000000000000000000000000000000000000000000000000",
      INIT_03 => X"0000000000000000000000000000000000000000000000000000000000000000",
      INIT_04 => X"0000000000000000000000000000000000000000000000000000000000000000",
      INIT_05 => X"0000000000000000000000000000000000000000000000000000000000000000",
      INIT_06 => X"0000000000000000000000000000000000000000000000000000000000000000",
      INIT_07 => X"0000000000000000000000000000000000000000000000000000000000000000",
      INIT_08 => X"0000000000000000000000000000000000000000000000000000000000000000",
      INIT_09 => X"0000000000000000000000000000000000000000000000000000000000000000",
      INIT_0A => X"0000000000000000000000000000000000000000000000000000000000000000",
      INIT_0B => X"0000000000000000000000000000000000000000000000000000000000000000",
      INIT_0C => X"0000000000000000000000000000000000000000000000000000000000000000",
      INIT_0D => X"0000000000000000000000000000000000000000000000000000000000000000",
      INIT_0E => X"0000000000000000000000000000000000000000000000000000000000000000",
      INIT_0F => X"0000000000000000000000000000000000000000000000000000000000000000",
      INIT_10 => X"0000000000000000000000000000000000000000000000000000000000000000",
      INIT_11 => X"0000000000000000000000000000000000000000000000000000000000000000",
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
      RSTREG_PRIORITY_A => "REGCE",
      RSTREG_PRIORITY_B => "REGCE",
      SIM_COLLISION_CHECK => "ALL",
      SIM_DEVICE => "7SERIES",
      SRVAL_A => X"000000000",
      SRVAL_B => X"000000000",
      WRITE_MODE_A => "WRITE_FIRST",
      WRITE_MODE_B => "WRITE_FIRST",
      WRITE_WIDTH_A => 2,
      WRITE_WIDTH_B => 2
    )
        port map (
      ADDRARDADDR(15) => '1',
      ADDRARDADDR(14 downto 1) => Q(13 downto 0),
      ADDRARDADDR(0) => '1',
      ADDRBWRADDR(15) => '1',
      ADDRBWRADDR(14 downto 1) => \DEVICE_7SERIES.NO_BMM_INFO.SDP.SIMPLE_PRIM36.ram_2\(13 downto 0),
      ADDRBWRADDR(0) => '1',
      CASCADEINA => '0',
      CASCADEINB => '0',
      CASCADEOUTA => \NLW_DEVICE_7SERIES.NO_BMM_INFO.SDP.SIMPLE_PRIM36.ram_CASCADEOUTA_UNCONNECTED\,
      CASCADEOUTB => \NLW_DEVICE_7SERIES.NO_BMM_INFO.SDP.SIMPLE_PRIM36.ram_CASCADEOUTB_UNCONNECTED\,
      CLKARDCLK => clk,
      CLKBWRCLK => clk,
      DBITERR => \NLW_DEVICE_7SERIES.NO_BMM_INFO.SDP.SIMPLE_PRIM36.ram_DBITERR_UNCONNECTED\,
      DIADI(31 downto 2) => B"000000000000000000000000000000",
      DIADI(1 downto 0) => din(1 downto 0),
      DIBDI(31 downto 0) => B"00000000000000000000000000000000",
      DIPADIP(3 downto 0) => B"0000",
      DIPBDIP(3 downto 0) => B"0000",
      DOADO(31 downto 0) => \NLW_DEVICE_7SERIES.NO_BMM_INFO.SDP.SIMPLE_PRIM36.ram_DOADO_UNCONNECTED\(31 downto 0),
      DOBDO(31 downto 2) => \NLW_DEVICE_7SERIES.NO_BMM_INFO.SDP.SIMPLE_PRIM36.ram_DOBDO_UNCONNECTED\(31 downto 2),
      DOBDO(1 downto 0) => dout(1 downto 0),
      DOPADOP(3 downto 0) => \NLW_DEVICE_7SERIES.NO_BMM_INFO.SDP.SIMPLE_PRIM36.ram_DOPADOP_UNCONNECTED\(3 downto 0),
      DOPBDOP(3 downto 0) => \NLW_DEVICE_7SERIES.NO_BMM_INFO.SDP.SIMPLE_PRIM36.ram_DOPBDOP_UNCONNECTED\(3 downto 0),
      ECCPARITY(7 downto 0) => \NLW_DEVICE_7SERIES.NO_BMM_INFO.SDP.SIMPLE_PRIM36.ram_ECCPARITY_UNCONNECTED\(7 downto 0),
      ENARDEN => \DEVICE_7SERIES.NO_BMM_INFO.SDP.SIMPLE_PRIM36.ram_0\,
      ENBWREN => \DEVICE_7SERIES.NO_BMM_INFO.SDP.SIMPLE_PRIM36.ram_1\,
      INJECTDBITERR => '0',
      INJECTSBITERR => '0',
      RDADDRECC(8 downto 0) => \NLW_DEVICE_7SERIES.NO_BMM_INFO.SDP.SIMPLE_PRIM36.ram_RDADDRECC_UNCONNECTED\(8 downto 0),
      REGCEAREGCE => '0',
      REGCEB => '0',
      RSTRAMARSTRAM => '0',
      RSTRAMB => srst,
      RSTREGARSTREG => '0',
      RSTREGB => '0',
      SBITERR => \NLW_DEVICE_7SERIES.NO_BMM_INFO.SDP.SIMPLE_PRIM36.ram_SBITERR_UNCONNECTED\,
      WEA(3) => \DEVICE_7SERIES.NO_BMM_INFO.SDP.SIMPLE_PRIM36.ram_3\(0),
      WEA(2) => \DEVICE_7SERIES.NO_BMM_INFO.SDP.SIMPLE_PRIM36.ram_3\(0),
      WEA(1) => \DEVICE_7SERIES.NO_BMM_INFO.SDP.SIMPLE_PRIM36.ram_3\(0),
      WEA(0) => \DEVICE_7SERIES.NO_BMM_INFO.SDP.SIMPLE_PRIM36.ram_3\(0),
      WEBWE(7 downto 0) => B"00000000"
    );
end STRUCTURE;
library IEEE;
use IEEE.STD_LOGIC_1164.ALL;
library UNISIM;
use UNISIM.VCOMPONENTS.ALL;
entity \fifo_32_blk_mem_gen_prim_wrapper__parameterized10\ is
  port (
    \DEVICE_7SERIES.NO_BMM_INFO.SDP.SIMPLE_PRIM36.ram_0\ : out STD_LOGIC_VECTOR ( 7 downto 0 );
    \DEVICE_7SERIES.NO_BMM_INFO.SDP.SIMPLE_PRIM36.ram_1\ : out STD_LOGIC_VECTOR ( 0 to 0 );
    clk : in STD_LOGIC;
    ena_array : in STD_LOGIC_VECTOR ( 0 to 0 );
    enb_array : in STD_LOGIC_VECTOR ( 0 to 0 );
    srst : in STD_LOGIC;
    Q : in STD_LOGIC_VECTOR ( 11 downto 0 );
    \DEVICE_7SERIES.NO_BMM_INFO.SDP.SIMPLE_PRIM36.ram_2\ : in STD_LOGIC_VECTOR ( 11 downto 0 );
    din : in STD_LOGIC_VECTOR ( 8 downto 0 );
    \DEVICE_7SERIES.NO_BMM_INFO.SDP.SIMPLE_PRIM36.ram_3\ : in STD_LOGIC_VECTOR ( 0 to 0 )
  );
  attribute ORIG_REF_NAME : string;
  attribute ORIG_REF_NAME of \fifo_32_blk_mem_gen_prim_wrapper__parameterized10\ : entity is "blk_mem_gen_prim_wrapper";
end \fifo_32_blk_mem_gen_prim_wrapper__parameterized10\;

architecture STRUCTURE of \fifo_32_blk_mem_gen_prim_wrapper__parameterized10\ is
  signal \NLW_DEVICE_7SERIES.NO_BMM_INFO.SDP.SIMPLE_PRIM36.ram_CASCADEOUTA_UNCONNECTED\ : STD_LOGIC;
  signal \NLW_DEVICE_7SERIES.NO_BMM_INFO.SDP.SIMPLE_PRIM36.ram_CASCADEOUTB_UNCONNECTED\ : STD_LOGIC;
  signal \NLW_DEVICE_7SERIES.NO_BMM_INFO.SDP.SIMPLE_PRIM36.ram_DBITERR_UNCONNECTED\ : STD_LOGIC;
  signal \NLW_DEVICE_7SERIES.NO_BMM_INFO.SDP.SIMPLE_PRIM36.ram_SBITERR_UNCONNECTED\ : STD_LOGIC;
  signal \NLW_DEVICE_7SERIES.NO_BMM_INFO.SDP.SIMPLE_PRIM36.ram_DOADO_UNCONNECTED\ : STD_LOGIC_VECTOR ( 31 downto 0 );
  signal \NLW_DEVICE_7SERIES.NO_BMM_INFO.SDP.SIMPLE_PRIM36.ram_DOBDO_UNCONNECTED\ : STD_LOGIC_VECTOR ( 31 downto 8 );
  signal \NLW_DEVICE_7SERIES.NO_BMM_INFO.SDP.SIMPLE_PRIM36.ram_DOPADOP_UNCONNECTED\ : STD_LOGIC_VECTOR ( 3 downto 0 );
  signal \NLW_DEVICE_7SERIES.NO_BMM_INFO.SDP.SIMPLE_PRIM36.ram_DOPBDOP_UNCONNECTED\ : STD_LOGIC_VECTOR ( 3 downto 1 );
  signal \NLW_DEVICE_7SERIES.NO_BMM_INFO.SDP.SIMPLE_PRIM36.ram_ECCPARITY_UNCONNECTED\ : STD_LOGIC_VECTOR ( 7 downto 0 );
  signal \NLW_DEVICE_7SERIES.NO_BMM_INFO.SDP.SIMPLE_PRIM36.ram_RDADDRECC_UNCONNECTED\ : STD_LOGIC_VECTOR ( 8 downto 0 );
  attribute box_type : string;
  attribute box_type of \DEVICE_7SERIES.NO_BMM_INFO.SDP.SIMPLE_PRIM36.ram\ : label is "PRIMITIVE";
begin
\DEVICE_7SERIES.NO_BMM_INFO.SDP.SIMPLE_PRIM36.ram\: unisim.vcomponents.RAMB36E1
    generic map(
      DOA_REG => 0,
      DOB_REG => 0,
      EN_ECC_READ => false,
      EN_ECC_WRITE => false,
      INITP_00 => X"0000000000000000000000000000000000000000000000000000000000000000",
      INITP_01 => X"0000000000000000000000000000000000000000000000000000000000000000",
      INITP_02 => X"0000000000000000000000000000000000000000000000000000000000000000",
      INITP_03 => X"0000000000000000000000000000000000000000000000000000000000000000",
      INITP_04 => X"0000000000000000000000000000000000000000000000000000000000000000",
      INITP_05 => X"0000000000000000000000000000000000000000000000000000000000000000",
      INITP_06 => X"0000000000000000000000000000000000000000000000000000000000000000",
      INITP_07 => X"0000000000000000000000000000000000000000000000000000000000000000",
      INITP_08 => X"0000000000000000000000000000000000000000000000000000000000000000",
      INITP_09 => X"0000000000000000000000000000000000000000000000000000000000000000",
      INITP_0A => X"0000000000000000000000000000000000000000000000000000000000000000",
      INITP_0B => X"0000000000000000000000000000000000000000000000000000000000000000",
      INITP_0C => X"0000000000000000000000000000000000000000000000000000000000000000",
      INITP_0D => X"0000000000000000000000000000000000000000000000000000000000000000",
      INITP_0E => X"0000000000000000000000000000000000000000000000000000000000000000",
      INITP_0F => X"0000000000000000000000000000000000000000000000000000000000000000",
      INIT_00 => X"0000000000000000000000000000000000000000000000000000000000000000",
      INIT_01 => X"0000000000000000000000000000000000000000000000000000000000000000",
      INIT_02 => X"0000000000000000000000000000000000000000000000000000000000000000",
      INIT_03 => X"0000000000000000000000000000000000000000000000000000000000000000",
      INIT_04 => X"0000000000000000000000000000000000000000000000000000000000000000",
      INIT_05 => X"0000000000000000000000000000000000000000000000000000000000000000",
      INIT_06 => X"0000000000000000000000000000000000000000000000000000000000000000",
      INIT_07 => X"0000000000000000000000000000000000000000000000000000000000000000",
      INIT_08 => X"0000000000000000000000000000000000000000000000000000000000000000",
      INIT_09 => X"0000000000000000000000000000000000000000000000000000000000000000",
      INIT_0A => X"0000000000000000000000000000000000000000000000000000000000000000",
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
      INIT_A => X"000000000",
      INIT_B => X"000000000",
      INIT_FILE => "NONE",
      IS_CLKARDCLK_INVERTED => '0',
      IS_CLKBWRCLK_INVERTED => '0',
      IS_ENARDEN_INVERTED => '0',
      IS_ENBWREN_INVERTED => '0',
      IS_RSTRAMARSTRAM_INVERTED => '0',
      IS_RSTRAMB_INVERTED => '0',
      IS_RSTREGARSTREG_INVERTED => '0',
      IS_RSTREGB_INVERTED => '0',
      RAM_EXTENSION_A => "NONE",
      RAM_EXTENSION_B => "NONE",
      RAM_MODE => "TDP",
      RDADDR_COLLISION_HWCONFIG => "DELAYED_WRITE",
      READ_WIDTH_A => 9,
      READ_WIDTH_B => 9,
      RSTREG_PRIORITY_A => "REGCE",
      RSTREG_PRIORITY_B => "REGCE",
      SIM_COLLISION_CHECK => "ALL",
      SIM_DEVICE => "7SERIES",
      SRVAL_A => X"000000000",
      SRVAL_B => X"000000000",
      WRITE_MODE_A => "WRITE_FIRST",
      WRITE_MODE_B => "WRITE_FIRST",
      WRITE_WIDTH_A => 9,
      WRITE_WIDTH_B => 9
    )
        port map (
      ADDRARDADDR(15) => '1',
      ADDRARDADDR(14 downto 3) => Q(11 downto 0),
      ADDRARDADDR(2 downto 0) => B"111",
      ADDRBWRADDR(15) => '1',
      ADDRBWRADDR(14 downto 3) => \DEVICE_7SERIES.NO_BMM_INFO.SDP.SIMPLE_PRIM36.ram_2\(11 downto 0),
      ADDRBWRADDR(2 downto 0) => B"111",
      CASCADEINA => '0',
      CASCADEINB => '0',
      CASCADEOUTA => \NLW_DEVICE_7SERIES.NO_BMM_INFO.SDP.SIMPLE_PRIM36.ram_CASCADEOUTA_UNCONNECTED\,
      CASCADEOUTB => \NLW_DEVICE_7SERIES.NO_BMM_INFO.SDP.SIMPLE_PRIM36.ram_CASCADEOUTB_UNCONNECTED\,
      CLKARDCLK => clk,
      CLKBWRCLK => clk,
      DBITERR => \NLW_DEVICE_7SERIES.NO_BMM_INFO.SDP.SIMPLE_PRIM36.ram_DBITERR_UNCONNECTED\,
      DIADI(31 downto 8) => B"000000000000000000000000",
      DIADI(7 downto 0) => din(7 downto 0),
      DIBDI(31 downto 0) => B"00000000000000000000000000000000",
      DIPADIP(3 downto 1) => B"000",
      DIPADIP(0) => din(8),
      DIPBDIP(3 downto 0) => B"0000",
      DOADO(31 downto 0) => \NLW_DEVICE_7SERIES.NO_BMM_INFO.SDP.SIMPLE_PRIM36.ram_DOADO_UNCONNECTED\(31 downto 0),
      DOBDO(31 downto 8) => \NLW_DEVICE_7SERIES.NO_BMM_INFO.SDP.SIMPLE_PRIM36.ram_DOBDO_UNCONNECTED\(31 downto 8),
      DOBDO(7 downto 0) => \DEVICE_7SERIES.NO_BMM_INFO.SDP.SIMPLE_PRIM36.ram_0\(7 downto 0),
      DOPADOP(3 downto 0) => \NLW_DEVICE_7SERIES.NO_BMM_INFO.SDP.SIMPLE_PRIM36.ram_DOPADOP_UNCONNECTED\(3 downto 0),
      DOPBDOP(3 downto 1) => \NLW_DEVICE_7SERIES.NO_BMM_INFO.SDP.SIMPLE_PRIM36.ram_DOPBDOP_UNCONNECTED\(3 downto 1),
      DOPBDOP(0) => \DEVICE_7SERIES.NO_BMM_INFO.SDP.SIMPLE_PRIM36.ram_1\(0),
      ECCPARITY(7 downto 0) => \NLW_DEVICE_7SERIES.NO_BMM_INFO.SDP.SIMPLE_PRIM36.ram_ECCPARITY_UNCONNECTED\(7 downto 0),
      ENARDEN => ena_array(0),
      ENBWREN => enb_array(0),
      INJECTDBITERR => '0',
      INJECTSBITERR => '0',
      RDADDRECC(8 downto 0) => \NLW_DEVICE_7SERIES.NO_BMM_INFO.SDP.SIMPLE_PRIM36.ram_RDADDRECC_UNCONNECTED\(8 downto 0),
      REGCEAREGCE => '0',
      REGCEB => '0',
      RSTRAMARSTRAM => '0',
      RSTRAMB => srst,
      RSTREGARSTREG => '0',
      RSTREGB => '0',
      SBITERR => \NLW_DEVICE_7SERIES.NO_BMM_INFO.SDP.SIMPLE_PRIM36.ram_SBITERR_UNCONNECTED\,
      WEA(3) => \DEVICE_7SERIES.NO_BMM_INFO.SDP.SIMPLE_PRIM36.ram_3\(0),
      WEA(2) => \DEVICE_7SERIES.NO_BMM_INFO.SDP.SIMPLE_PRIM36.ram_3\(0),
      WEA(1) => \DEVICE_7SERIES.NO_BMM_INFO.SDP.SIMPLE_PRIM36.ram_3\(0),
      WEA(0) => \DEVICE_7SERIES.NO_BMM_INFO.SDP.SIMPLE_PRIM36.ram_3\(0),
      WEBWE(7 downto 0) => B"00000000"
    );
end STRUCTURE;
library IEEE;
use IEEE.STD_LOGIC_1164.ALL;
library UNISIM;
use UNISIM.VCOMPONENTS.ALL;
entity \fifo_32_blk_mem_gen_prim_wrapper__parameterized11\ is
  port (
    \DEVICE_7SERIES.NO_BMM_INFO.SDP.SIMPLE_PRIM36.ram_0\ : out STD_LOGIC_VECTOR ( 7 downto 0 );
    \DEVICE_7SERIES.NO_BMM_INFO.SDP.SIMPLE_PRIM36.ram_1\ : out STD_LOGIC_VECTOR ( 0 to 0 );
    clk : in STD_LOGIC;
    ena_array : in STD_LOGIC_VECTOR ( 0 to 0 );
    enb_array : in STD_LOGIC_VECTOR ( 0 to 0 );
    srst : in STD_LOGIC;
    Q : in STD_LOGIC_VECTOR ( 11 downto 0 );
    \DEVICE_7SERIES.NO_BMM_INFO.SDP.SIMPLE_PRIM36.ram_2\ : in STD_LOGIC_VECTOR ( 11 downto 0 );
    din : in STD_LOGIC_VECTOR ( 8 downto 0 );
    WEA : in STD_LOGIC_VECTOR ( 0 to 0 )
  );
  attribute ORIG_REF_NAME : string;
  attribute ORIG_REF_NAME of \fifo_32_blk_mem_gen_prim_wrapper__parameterized11\ : entity is "blk_mem_gen_prim_wrapper";
end \fifo_32_blk_mem_gen_prim_wrapper__parameterized11\;

architecture STRUCTURE of \fifo_32_blk_mem_gen_prim_wrapper__parameterized11\ is
  signal \NLW_DEVICE_7SERIES.NO_BMM_INFO.SDP.SIMPLE_PRIM36.ram_CASCADEOUTA_UNCONNECTED\ : STD_LOGIC;
  signal \NLW_DEVICE_7SERIES.NO_BMM_INFO.SDP.SIMPLE_PRIM36.ram_CASCADEOUTB_UNCONNECTED\ : STD_LOGIC;
  signal \NLW_DEVICE_7SERIES.NO_BMM_INFO.SDP.SIMPLE_PRIM36.ram_DBITERR_UNCONNECTED\ : STD_LOGIC;
  signal \NLW_DEVICE_7SERIES.NO_BMM_INFO.SDP.SIMPLE_PRIM36.ram_SBITERR_UNCONNECTED\ : STD_LOGIC;
  signal \NLW_DEVICE_7SERIES.NO_BMM_INFO.SDP.SIMPLE_PRIM36.ram_DOADO_UNCONNECTED\ : STD_LOGIC_VECTOR ( 31 downto 0 );
  signal \NLW_DEVICE_7SERIES.NO_BMM_INFO.SDP.SIMPLE_PRIM36.ram_DOBDO_UNCONNECTED\ : STD_LOGIC_VECTOR ( 31 downto 8 );
  signal \NLW_DEVICE_7SERIES.NO_BMM_INFO.SDP.SIMPLE_PRIM36.ram_DOPADOP_UNCONNECTED\ : STD_LOGIC_VECTOR ( 3 downto 0 );
  signal \NLW_DEVICE_7SERIES.NO_BMM_INFO.SDP.SIMPLE_PRIM36.ram_DOPBDOP_UNCONNECTED\ : STD_LOGIC_VECTOR ( 3 downto 1 );
  signal \NLW_DEVICE_7SERIES.NO_BMM_INFO.SDP.SIMPLE_PRIM36.ram_ECCPARITY_UNCONNECTED\ : STD_LOGIC_VECTOR ( 7 downto 0 );
  signal \NLW_DEVICE_7SERIES.NO_BMM_INFO.SDP.SIMPLE_PRIM36.ram_RDADDRECC_UNCONNECTED\ : STD_LOGIC_VECTOR ( 8 downto 0 );
  attribute box_type : string;
  attribute box_type of \DEVICE_7SERIES.NO_BMM_INFO.SDP.SIMPLE_PRIM36.ram\ : label is "PRIMITIVE";
begin
\DEVICE_7SERIES.NO_BMM_INFO.SDP.SIMPLE_PRIM36.ram\: unisim.vcomponents.RAMB36E1
    generic map(
      DOA_REG => 0,
      DOB_REG => 0,
      EN_ECC_READ => false,
      EN_ECC_WRITE => false,
      INITP_00 => X"0000000000000000000000000000000000000000000000000000000000000000",
      INITP_01 => X"0000000000000000000000000000000000000000000000000000000000000000",
      INITP_02 => X"0000000000000000000000000000000000000000000000000000000000000000",
      INITP_03 => X"0000000000000000000000000000000000000000000000000000000000000000",
      INITP_04 => X"0000000000000000000000000000000000000000000000000000000000000000",
      INITP_05 => X"0000000000000000000000000000000000000000000000000000000000000000",
      INITP_06 => X"0000000000000000000000000000000000000000000000000000000000000000",
      INITP_07 => X"0000000000000000000000000000000000000000000000000000000000000000",
      INITP_08 => X"0000000000000000000000000000000000000000000000000000000000000000",
      INITP_09 => X"0000000000000000000000000000000000000000000000000000000000000000",
      INITP_0A => X"0000000000000000000000000000000000000000000000000000000000000000",
      INITP_0B => X"0000000000000000000000000000000000000000000000000000000000000000",
      INITP_0C => X"0000000000000000000000000000000000000000000000000000000000000000",
      INITP_0D => X"0000000000000000000000000000000000000000000000000000000000000000",
      INITP_0E => X"0000000000000000000000000000000000000000000000000000000000000000",
      INITP_0F => X"0000000000000000000000000000000000000000000000000000000000000000",
      INIT_00 => X"0000000000000000000000000000000000000000000000000000000000000000",
      INIT_01 => X"0000000000000000000000000000000000000000000000000000000000000000",
      INIT_02 => X"0000000000000000000000000000000000000000000000000000000000000000",
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
      INIT_77 => X"0000000000000000000000000000000000000000000000000000000000000000",
      INIT_78 => X"0000000000000000000000000000000000000000000000000000000000000000",
      INIT_79 => X"0000000000000000000000000000000000000000000000000000000000000000",
      INIT_7A => X"0000000000000000000000000000000000000000000000000000000000000000",
      INIT_7B => X"0000000000000000000000000000000000000000000000000000000000000000",
      INIT_7C => X"0000000000000000000000000000000000000000000000000000000000000000",
      INIT_7D => X"0000000000000000000000000000000000000000000000000000000000000000",
      INIT_7E => X"0000000000000000000000000000000000000000000000000000000000000000",
      INIT_7F => X"0000000000000000000000000000000000000000000000000000000000000000",
      INIT_A => X"000000000",
      INIT_B => X"000000000",
      INIT_FILE => "NONE",
      IS_CLKARDCLK_INVERTED => '0',
      IS_CLKBWRCLK_INVERTED => '0',
      IS_ENARDEN_INVERTED => '0',
      IS_ENBWREN_INVERTED => '0',
      IS_RSTRAMARSTRAM_INVERTED => '0',
      IS_RSTRAMB_INVERTED => '0',
      IS_RSTREGARSTREG_INVERTED => '0',
      IS_RSTREGB_INVERTED => '0',
      RAM_EXTENSION_A => "NONE",
      RAM_EXTENSION_B => "NONE",
      RAM_MODE => "TDP",
      RDADDR_COLLISION_HWCONFIG => "DELAYED_WRITE",
      READ_WIDTH_A => 9,
      READ_WIDTH_B => 9,
      RSTREG_PRIORITY_A => "REGCE",
      RSTREG_PRIORITY_B => "REGCE",
      SIM_COLLISION_CHECK => "ALL",
      SIM_DEVICE => "7SERIES",
      SRVAL_A => X"000000000",
      SRVAL_B => X"000000000",
      WRITE_MODE_A => "WRITE_FIRST",
      WRITE_MODE_B => "WRITE_FIRST",
      WRITE_WIDTH_A => 9,
      WRITE_WIDTH_B => 9
    )
        port map (
      ADDRARDADDR(15) => '1',
      ADDRARDADDR(14 downto 3) => Q(11 downto 0),
      ADDRARDADDR(2 downto 0) => B"111",
      ADDRBWRADDR(15) => '1',
      ADDRBWRADDR(14 downto 3) => \DEVICE_7SERIES.NO_BMM_INFO.SDP.SIMPLE_PRIM36.ram_2\(11 downto 0),
      ADDRBWRADDR(2 downto 0) => B"111",
      CASCADEINA => '0',
      CASCADEINB => '0',
      CASCADEOUTA => \NLW_DEVICE_7SERIES.NO_BMM_INFO.SDP.SIMPLE_PRIM36.ram_CASCADEOUTA_UNCONNECTED\,
      CASCADEOUTB => \NLW_DEVICE_7SERIES.NO_BMM_INFO.SDP.SIMPLE_PRIM36.ram_CASCADEOUTB_UNCONNECTED\,
      CLKARDCLK => clk,
      CLKBWRCLK => clk,
      DBITERR => \NLW_DEVICE_7SERIES.NO_BMM_INFO.SDP.SIMPLE_PRIM36.ram_DBITERR_UNCONNECTED\,
      DIADI(31 downto 8) => B"000000000000000000000000",
      DIADI(7 downto 0) => din(7 downto 0),
      DIBDI(31 downto 0) => B"00000000000000000000000000000000",
      DIPADIP(3 downto 1) => B"000",
      DIPADIP(0) => din(8),
      DIPBDIP(3 downto 0) => B"0000",
      DOADO(31 downto 0) => \NLW_DEVICE_7SERIES.NO_BMM_INFO.SDP.SIMPLE_PRIM36.ram_DOADO_UNCONNECTED\(31 downto 0),
      DOBDO(31 downto 8) => \NLW_DEVICE_7SERIES.NO_BMM_INFO.SDP.SIMPLE_PRIM36.ram_DOBDO_UNCONNECTED\(31 downto 8),
      DOBDO(7 downto 0) => \DEVICE_7SERIES.NO_BMM_INFO.SDP.SIMPLE_PRIM36.ram_0\(7 downto 0),
      DOPADOP(3 downto 0) => \NLW_DEVICE_7SERIES.NO_BMM_INFO.SDP.SIMPLE_PRIM36.ram_DOPADOP_UNCONNECTED\(3 downto 0),
      DOPBDOP(3 downto 1) => \NLW_DEVICE_7SERIES.NO_BMM_INFO.SDP.SIMPLE_PRIM36.ram_DOPBDOP_UNCONNECTED\(3 downto 1),
      DOPBDOP(0) => \DEVICE_7SERIES.NO_BMM_INFO.SDP.SIMPLE_PRIM36.ram_1\(0),
      ECCPARITY(7 downto 0) => \NLW_DEVICE_7SERIES.NO_BMM_INFO.SDP.SIMPLE_PRIM36.ram_ECCPARITY_UNCONNECTED\(7 downto 0),
      ENARDEN => ena_array(0),
      ENBWREN => enb_array(0),
      INJECTDBITERR => '0',
      INJECTSBITERR => '0',
      RDADDRECC(8 downto 0) => \NLW_DEVICE_7SERIES.NO_BMM_INFO.SDP.SIMPLE_PRIM36.ram_RDADDRECC_UNCONNECTED\(8 downto 0),
      REGCEAREGCE => '0',
      REGCEB => '0',
      RSTRAMARSTRAM => '0',
      RSTRAMB => srst,
      RSTREGARSTREG => '0',
      RSTREGB => '0',
      SBITERR => \NLW_DEVICE_7SERIES.NO_BMM_INFO.SDP.SIMPLE_PRIM36.ram_SBITERR_UNCONNECTED\,
      WEA(3) => WEA(0),
      WEA(2) => WEA(0),
      WEA(1) => WEA(0),
      WEA(0) => WEA(0),
      WEBWE(7 downto 0) => B"00000000"
    );
end STRUCTURE;
library IEEE;
use IEEE.STD_LOGIC_1164.ALL;
library UNISIM;
use UNISIM.VCOMPONENTS.ALL;
entity \fifo_32_blk_mem_gen_prim_wrapper__parameterized12\ is
  port (
    DOBDO : out STD_LOGIC_VECTOR ( 7 downto 0 );
    DOPBDOP : out STD_LOGIC_VECTOR ( 0 to 0 );
    clk : in STD_LOGIC;
    ena_array : in STD_LOGIC_VECTOR ( 0 to 0 );
    enb_array : in STD_LOGIC_VECTOR ( 0 to 0 );
    srst : in STD_LOGIC;
    Q : in STD_LOGIC_VECTOR ( 11 downto 0 );
    \DEVICE_7SERIES.NO_BMM_INFO.SDP.SIMPLE_PRIM36.ram_0\ : in STD_LOGIC_VECTOR ( 11 downto 0 );
    din : in STD_LOGIC_VECTOR ( 8 downto 0 );
    \DEVICE_7SERIES.NO_BMM_INFO.SDP.SIMPLE_PRIM36.ram_1\ : in STD_LOGIC_VECTOR ( 0 to 0 )
  );
  attribute ORIG_REF_NAME : string;
  attribute ORIG_REF_NAME of \fifo_32_blk_mem_gen_prim_wrapper__parameterized12\ : entity is "blk_mem_gen_prim_wrapper";
end \fifo_32_blk_mem_gen_prim_wrapper__parameterized12\;

architecture STRUCTURE of \fifo_32_blk_mem_gen_prim_wrapper__parameterized12\ is
  signal \NLW_DEVICE_7SERIES.NO_BMM_INFO.SDP.SIMPLE_PRIM36.ram_CASCADEOUTA_UNCONNECTED\ : STD_LOGIC;
  signal \NLW_DEVICE_7SERIES.NO_BMM_INFO.SDP.SIMPLE_PRIM36.ram_CASCADEOUTB_UNCONNECTED\ : STD_LOGIC;
  signal \NLW_DEVICE_7SERIES.NO_BMM_INFO.SDP.SIMPLE_PRIM36.ram_DBITERR_UNCONNECTED\ : STD_LOGIC;
  signal \NLW_DEVICE_7SERIES.NO_BMM_INFO.SDP.SIMPLE_PRIM36.ram_SBITERR_UNCONNECTED\ : STD_LOGIC;
  signal \NLW_DEVICE_7SERIES.NO_BMM_INFO.SDP.SIMPLE_PRIM36.ram_DOADO_UNCONNECTED\ : STD_LOGIC_VECTOR ( 31 downto 0 );
  signal \NLW_DEVICE_7SERIES.NO_BMM_INFO.SDP.SIMPLE_PRIM36.ram_DOBDO_UNCONNECTED\ : STD_LOGIC_VECTOR ( 31 downto 8 );
  signal \NLW_DEVICE_7SERIES.NO_BMM_INFO.SDP.SIMPLE_PRIM36.ram_DOPADOP_UNCONNECTED\ : STD_LOGIC_VECTOR ( 3 downto 0 );
  signal \NLW_DEVICE_7SERIES.NO_BMM_INFO.SDP.SIMPLE_PRIM36.ram_DOPBDOP_UNCONNECTED\ : STD_LOGIC_VECTOR ( 3 downto 1 );
  signal \NLW_DEVICE_7SERIES.NO_BMM_INFO.SDP.SIMPLE_PRIM36.ram_ECCPARITY_UNCONNECTED\ : STD_LOGIC_VECTOR ( 7 downto 0 );
  signal \NLW_DEVICE_7SERIES.NO_BMM_INFO.SDP.SIMPLE_PRIM36.ram_RDADDRECC_UNCONNECTED\ : STD_LOGIC_VECTOR ( 8 downto 0 );
  attribute box_type : string;
  attribute box_type of \DEVICE_7SERIES.NO_BMM_INFO.SDP.SIMPLE_PRIM36.ram\ : label is "PRIMITIVE";
begin
\DEVICE_7SERIES.NO_BMM_INFO.SDP.SIMPLE_PRIM36.ram\: unisim.vcomponents.RAMB36E1
    generic map(
      DOA_REG => 0,
      DOB_REG => 0,
      EN_ECC_READ => false,
      EN_ECC_WRITE => false,
      INITP_00 => X"0000000000000000000000000000000000000000000000000000000000000000",
      INITP_01 => X"0000000000000000000000000000000000000000000000000000000000000000",
      INITP_02 => X"0000000000000000000000000000000000000000000000000000000000000000",
      INITP_03 => X"0000000000000000000000000000000000000000000000000000000000000000",
      INITP_04 => X"0000000000000000000000000000000000000000000000000000000000000000",
      INITP_05 => X"0000000000000000000000000000000000000000000000000000000000000000",
      INITP_06 => X"0000000000000000000000000000000000000000000000000000000000000000",
      INITP_07 => X"0000000000000000000000000000000000000000000000000000000000000000",
      INITP_08 => X"0000000000000000000000000000000000000000000000000000000000000000",
      INITP_09 => X"0000000000000000000000000000000000000000000000000000000000000000",
      INITP_0A => X"0000000000000000000000000000000000000000000000000000000000000000",
      INITP_0B => X"0000000000000000000000000000000000000000000000000000000000000000",
      INITP_0C => X"0000000000000000000000000000000000000000000000000000000000000000",
      INITP_0D => X"0000000000000000000000000000000000000000000000000000000000000000",
      INITP_0E => X"0000000000000000000000000000000000000000000000000000000000000000",
      INITP_0F => X"0000000000000000000000000000000000000000000000000000000000000000",
      INIT_00 => X"0000000000000000000000000000000000000000000000000000000000000000",
      INIT_01 => X"0000000000000000000000000000000000000000000000000000000000000000",
      INIT_02 => X"0000000000000000000000000000000000000000000000000000000000000000",
      INIT_03 => X"0000000000000000000000000000000000000000000000000000000000000000",
      INIT_04 => X"0000000000000000000000000000000000000000000000000000000000000000",
      INIT_05 => X"0000000000000000000000000000000000000000000000000000000000000000",
      INIT_06 => X"0000000000000000000000000000000000000000000000000000000000000000",
      INIT_07 => X"0000000000000000000000000000000000000000000000000000000000000000",
      INIT_08 => X"0000000000000000000000000000000000000000000000000000000000000000",
      INIT_09 => X"0000000000000000000000000000000000000000000000000000000000000000",
      INIT_0A => X"0000000000000000000000000000000000000000000000000000000000000000",
      INIT_0B => X"0000000000000000000000000000000000000000000000000000000000000000",
      INIT_0C => X"0000000000000000000000000000000000000000000000000000000000000000",
      INIT_0D => X"0000000000000000000000000000000000000000000000000000000000000000",
      INIT_0E => X"0000000000000000000000000000000000000000000000000000000000000000",
      INIT_0F => X"0000000000000000000000000000000000000000000000000000000000000000",
      INIT_10 => X"0000000000000000000000000000000000000000000000000000000000000000",
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
      RAM_MODE => "TDP",
      RDADDR_COLLISION_HWCONFIG => "DELAYED_WRITE",
      READ_WIDTH_A => 9,
      READ_WIDTH_B => 9,
      RSTREG_PRIORITY_A => "REGCE",
      RSTREG_PRIORITY_B => "REGCE",
      SIM_COLLISION_CHECK => "ALL",
      SIM_DEVICE => "7SERIES",
      SRVAL_A => X"000000000",
      SRVAL_B => X"000000000",
      WRITE_MODE_A => "WRITE_FIRST",
      WRITE_MODE_B => "WRITE_FIRST",
      WRITE_WIDTH_A => 9,
      WRITE_WIDTH_B => 9
    )
        port map (
      ADDRARDADDR(15) => '1',
      ADDRARDADDR(14 downto 3) => Q(11 downto 0),
      ADDRARDADDR(2 downto 0) => B"111",
      ADDRBWRADDR(15) => '1',
      ADDRBWRADDR(14 downto 3) => \DEVICE_7SERIES.NO_BMM_INFO.SDP.SIMPLE_PRIM36.ram_0\(11 downto 0),
      ADDRBWRADDR(2 downto 0) => B"111",
      CASCADEINA => '0',
      CASCADEINB => '0',
      CASCADEOUTA => \NLW_DEVICE_7SERIES.NO_BMM_INFO.SDP.SIMPLE_PRIM36.ram_CASCADEOUTA_UNCONNECTED\,
      CASCADEOUTB => \NLW_DEVICE_7SERIES.NO_BMM_INFO.SDP.SIMPLE_PRIM36.ram_CASCADEOUTB_UNCONNECTED\,
      CLKARDCLK => clk,
      CLKBWRCLK => clk,
      DBITERR => \NLW_DEVICE_7SERIES.NO_BMM_INFO.SDP.SIMPLE_PRIM36.ram_DBITERR_UNCONNECTED\,
      DIADI(31 downto 8) => B"000000000000000000000000",
      DIADI(7 downto 0) => din(7 downto 0),
      DIBDI(31 downto 0) => B"00000000000000000000000000000000",
      DIPADIP(3 downto 1) => B"000",
      DIPADIP(0) => din(8),
      DIPBDIP(3 downto 0) => B"0000",
      DOADO(31 downto 0) => \NLW_DEVICE_7SERIES.NO_BMM_INFO.SDP.SIMPLE_PRIM36.ram_DOADO_UNCONNECTED\(31 downto 0),
      DOBDO(31 downto 8) => \NLW_DEVICE_7SERIES.NO_BMM_INFO.SDP.SIMPLE_PRIM36.ram_DOBDO_UNCONNECTED\(31 downto 8),
      DOBDO(7 downto 0) => DOBDO(7 downto 0),
      DOPADOP(3 downto 0) => \NLW_DEVICE_7SERIES.NO_BMM_INFO.SDP.SIMPLE_PRIM36.ram_DOPADOP_UNCONNECTED\(3 downto 0),
      DOPBDOP(3 downto 1) => \NLW_DEVICE_7SERIES.NO_BMM_INFO.SDP.SIMPLE_PRIM36.ram_DOPBDOP_UNCONNECTED\(3 downto 1),
      DOPBDOP(0) => DOPBDOP(0),
      ECCPARITY(7 downto 0) => \NLW_DEVICE_7SERIES.NO_BMM_INFO.SDP.SIMPLE_PRIM36.ram_ECCPARITY_UNCONNECTED\(7 downto 0),
      ENARDEN => ena_array(0),
      ENBWREN => enb_array(0),
      INJECTDBITERR => '0',
      INJECTSBITERR => '0',
      RDADDRECC(8 downto 0) => \NLW_DEVICE_7SERIES.NO_BMM_INFO.SDP.SIMPLE_PRIM36.ram_RDADDRECC_UNCONNECTED\(8 downto 0),
      REGCEAREGCE => '0',
      REGCEB => '0',
      RSTRAMARSTRAM => '0',
      RSTRAMB => srst,
      RSTREGARSTREG => '0',
      RSTREGB => '0',
      SBITERR => \NLW_DEVICE_7SERIES.NO_BMM_INFO.SDP.SIMPLE_PRIM36.ram_SBITERR_UNCONNECTED\,
      WEA(3) => \DEVICE_7SERIES.NO_BMM_INFO.SDP.SIMPLE_PRIM36.ram_1\(0),
      WEA(2) => \DEVICE_7SERIES.NO_BMM_INFO.SDP.SIMPLE_PRIM36.ram_1\(0),
      WEA(1) => \DEVICE_7SERIES.NO_BMM_INFO.SDP.SIMPLE_PRIM36.ram_1\(0),
      WEA(0) => \DEVICE_7SERIES.NO_BMM_INFO.SDP.SIMPLE_PRIM36.ram_1\(0),
      WEBWE(7 downto 0) => B"00000000"
    );
end STRUCTURE;
library IEEE;
use IEEE.STD_LOGIC_1164.ALL;
library UNISIM;
use UNISIM.VCOMPONENTS.ALL;
entity \fifo_32_blk_mem_gen_prim_wrapper__parameterized13\ is
  port (
    \DEVICE_7SERIES.NO_BMM_INFO.SDP.SIMPLE_PRIM36.ram_0\ : out STD_LOGIC_VECTOR ( 7 downto 0 );
    \DEVICE_7SERIES.NO_BMM_INFO.SDP.SIMPLE_PRIM36.ram_1\ : out STD_LOGIC_VECTOR ( 0 to 0 );
    clk : in STD_LOGIC;
    \DEVICE_7SERIES.NO_BMM_INFO.SDP.SIMPLE_PRIM36.ram_2\ : in STD_LOGIC;
    \DEVICE_7SERIES.NO_BMM_INFO.SDP.SIMPLE_PRIM36.ram_3\ : in STD_LOGIC;
    srst : in STD_LOGIC;
    Q : in STD_LOGIC_VECTOR ( 11 downto 0 );
    \DEVICE_7SERIES.NO_BMM_INFO.SDP.SIMPLE_PRIM36.ram_4\ : in STD_LOGIC_VECTOR ( 11 downto 0 );
    din : in STD_LOGIC_VECTOR ( 8 downto 0 );
    WEA : in STD_LOGIC_VECTOR ( 0 to 0 )
  );
  attribute ORIG_REF_NAME : string;
  attribute ORIG_REF_NAME of \fifo_32_blk_mem_gen_prim_wrapper__parameterized13\ : entity is "blk_mem_gen_prim_wrapper";
end \fifo_32_blk_mem_gen_prim_wrapper__parameterized13\;
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
