alwaysmy/Artix-7_GTP_USB3_WCH_MCU/2_Firmware/Artix-7_GTP_USB3_WCH_MCU_XillyUSB-USBC_SpeedTest/vivado-essentials/fifo_8/fifo_8_sim_netlist.vhdl

-- Copyright 1986-2019 Xilinx, Inc. All Rights Reserved.
-- --------------------------------------------------------------------------------
-- Tool Version: Vivado v.2018.3.1 (win64) Build 2489853 Tue Mar 26 04:20:25 MDT 2019
-- Date        : Mon May 19 22:48:53 2025
-- Host        : TS-Always running 64-bit major release  (build 9200)
-- Command     : write_vhdl -force -mode funcsim
--               D:/MyProjects/2_MyDesigns/USB3_Artix_GTP/xillyusb-bundle-artix7-trenz-1.10/vivado-essentials/fifo_8/fifo_8_sim_netlist.vhdl
-- Design      : fifo_8
-- Purpose     : This VHDL netlist is a functional simulation representation of the design and should not be modified or
--               synthesized. This netlist cannot be used for SDF annotated simulation.
-- Device      : xc7a35tcsg325-2
-- --------------------------------------------------------------------------------
library IEEE;
use IEEE.STD_LOGIC_1164.ALL;
library UNISIM;
use UNISIM.VCOMPONENTS.ALL;
entity \fifo_8_blk_mem_gen_mux__parameterized0\ is
  port (
    dout : out STD_LOGIC_VECTOR ( 7 downto 0 );
    \no_softecc_sel_reg.ce_pri.sel_pipe_reg[1]_0\ : in STD_LOGIC_VECTOR ( 1 downto 0 );
    \out\ : in STD_LOGIC;
    rd_en : in STD_LOGIC;
    srst : in STD_LOGIC;
    clk : in STD_LOGIC;
    doutb_array : in STD_LOGIC_VECTOR ( 31 downto 0 )
  );
  attribute ORIG_REF_NAME : string;
  attribute ORIG_REF_NAME of \fifo_8_blk_mem_gen_mux__parameterized0\ : entity is "blk_mem_gen_mux";
end \fifo_8_blk_mem_gen_mux__parameterized0\;

architecture STRUCTURE of \fifo_8_blk_mem_gen_mux__parameterized0\ is
  signal \no_softecc_sel_reg.ce_pri.sel_pipe[0]_i_1_n_0\ : STD_LOGIC;
  signal \no_softecc_sel_reg.ce_pri.sel_pipe[1]_i_1_n_0\ : STD_LOGIC;
  signal sel_pipe : STD_LOGIC_VECTOR ( 1 downto 0 );
begin
\dout[0]_INST_0\: unisim.vcomponents.LUT6
    generic map(
      INIT => X"CCFFAAF0CC00AAF0"
    )
        port map (
      I0 => doutb_array(16),
      I1 => doutb_array(24),
      I2 => doutb_array(0),
      I3 => sel_pipe(1),
      I4 => sel_pipe(0),
      I5 => doutb_array(8),
      O => dout(0)
    );
\dout[1]_INST_0\: unisim.vcomponents.LUT6
    generic map(
      INIT => X"CCFFAAF0CC00AAF0"
    )
        port map (
      I0 => doutb_array(17),
      I1 => doutb_array(25),
      I2 => doutb_array(1),
      I3 => sel_pipe(1),
      I4 => sel_pipe(0),
      I5 => doutb_array(9),
      O => dout(1)
    );
\dout[2]_INST_0\: unisim.vcomponents.LUT6
    generic map(
      INIT => X"CCFFAAF0CC00AAF0"
    )
        port map (
      I0 => doutb_array(18),
      I1 => doutb_array(26),
      I2 => doutb_array(2),
      I3 => sel_pipe(1),
      I4 => sel_pipe(0),
      I5 => doutb_array(10),
      O => dout(2)
    );
\dout[3]_INST_0\: unisim.vcomponents.LUT6
    generic map(
      INIT => X"CCFFAAF0CC00AAF0"
    )
        port map (
      I0 => doutb_array(19),
      I1 => doutb_array(27),
      I2 => doutb_array(3),
      I3 => sel_pipe(1),
      I4 => sel_pipe(0),
      I5 => doutb_array(11),
      O => dout(3)
    );
\dout[4]_INST_0\: unisim.vcomponents.LUT6
    generic map(
      INIT => X"CCFFAAF0CC00AAF0"
    )
        port map (
      I0 => doutb_array(20),
      I1 => doutb_array(28),
      I2 => doutb_array(4),
      I3 => sel_pipe(1),
      I4 => sel_pipe(0),
      I5 => doutb_array(12),
      O => dout(4)
    );
\dout[5]_INST_0\: unisim.vcomponents.LUT6
    generic map(
      INIT => X"CCFFAAF0CC00AAF0"
    )
        port map (
      I0 => doutb_array(21),
      I1 => doutb_array(29),
      I2 => doutb_array(5),
      I3 => sel_pipe(1),
      I4 => sel_pipe(0),
      I5 => doutb_array(13),
      O => dout(5)
    );
\dout[6]_INST_0\: unisim.vcomponents.LUT6
    generic map(
      INIT => X"CCFFAAF0CC00AAF0"
    )
        port map (
      I0 => doutb_array(22),
      I1 => doutb_array(30),
      I2 => doutb_array(6),
      I3 => sel_pipe(1),
      I4 => sel_pipe(0),
      I5 => doutb_array(14),
      O => dout(6)
    );
\dout[7]_INST_0\: unisim.vcomponents.LUT6
    generic map(
      INIT => X"CCFFAAF0CC00AAF0"
    )
        port map (
      I0 => doutb_array(23),
      I1 => doutb_array(31),
      I2 => doutb_array(7),
      I3 => sel_pipe(1),
      I4 => sel_pipe(0),
      I5 => doutb_array(15),
      O => dout(7)
    );
\no_softecc_sel_reg.ce_pri.sel_pipe[0]_i_1\: unisim.vcomponents.LUT5
    generic map(
      INIT => X"AAEFAA20"
    )
        port map (
      I0 => \no_softecc_sel_reg.ce_pri.sel_pipe_reg[1]_0\(0),
      I1 => \out\,
      I2 => rd_en,
      I3 => srst,
      I4 => sel_pipe(0),
      O => \no_softecc_sel_reg.ce_pri.sel_pipe[0]_i_1_n_0\
    );
\no_softecc_sel_reg.ce_pri.sel_pipe[1]_i_1\: unisim.vcomponents.LUT5
    generic map(
      INIT => X"AAEFAA20"
    )
        port map (
      I0 => \no_softecc_sel_reg.ce_pri.sel_pipe_reg[1]_0\(1),
      I1 => \out\,
      I2 => rd_en,
      I3 => srst,
      I4 => sel_pipe(1),
      O => \no_softecc_sel_reg.ce_pri.sel_pipe[1]_i_1_n_0\
    );
\no_softecc_sel_reg.ce_pri.sel_pipe_reg[0]\: unisim.vcomponents.FDRE
    generic map(
      INIT => '0'
    )
        port map (
      C => clk,
      CE => '1',
      D => \no_softecc_sel_reg.ce_pri.sel_pipe[0]_i_1_n_0\,
      Q => sel_pipe(0),
      R => '0'
    );
\no_softecc_sel_reg.ce_pri.sel_pipe_reg[1]\: unisim.vcomponents.FDRE
    generic map(
      INIT => '0'
    )
        port map (
      C => clk,
      CE => '1',
      D => \no_softecc_sel_reg.ce_pri.sel_pipe[1]_i_1_n_0\,
      Q => sel_pipe(1),
      R => '0'
    );
end STRUCTURE;
library IEEE;
use IEEE.STD_LOGIC_1164.ALL;
library UNISIM;
use UNISIM.VCOMPONENTS.ALL;
entity fifo_8_blk_mem_gen_prim_wrapper is
  port (
    doutb_array : out STD_LOGIC_VECTOR ( 7 downto 0 );
    clk : in STD_LOGIC;
    ena_array : in STD_LOGIC_VECTOR ( 0 to 0 );
    enb_array : in STD_LOGIC_VECTOR ( 0 to 0 );
    srst : in STD_LOGIC;
    Q : in STD_LOGIC_VECTOR ( 11 downto 0 );
    \DEVICE_7SERIES.NO_BMM_INFO.SDP.SIMPLE_PRIM36.ram_0\ : in STD_LOGIC_VECTOR ( 11 downto 0 );
    din : in STD_LOGIC_VECTOR ( 7 downto 0 );
    p_17_out : in STD_LOGIC
  );
  attribute ORIG_REF_NAME : string;
  attribute ORIG_REF_NAME of fifo_8_blk_mem_gen_prim_wrapper : entity is "blk_mem_gen_prim_wrapper";
end fifo_8_blk_mem_gen_prim_wrapper;

architecture STRUCTURE of fifo_8_blk_mem_gen_prim_wrapper is
  signal \DEVICE_7SERIES.NO_BMM_INFO.SDP.SIMPLE_PRIM36.ram_n_75\ : STD_LOGIC;
  signal \NLW_DEVICE_7SERIES.NO_BMM_INFO.SDP.SIMPLE_PRIM36.ram_CASCADEOUTA_UNCONNECTED\ : STD_LOGIC;
  signal \NLW_DEVICE_7SERIES.NO_BMM_INFO.SDP.SIMPLE_PRIM36.ram_CASCADEOUTB_UNCONNECTED\ : STD_LOGIC;
  signal \NLW_DEVICE_7SERIES.NO_BMM_INFO.SDP.SIMPLE_PRIM36.ram_DBITERR_UNCONNECTED\ : STD_LOGIC;
  signal \NLW_DEVICE_7SERIES.NO_BMM_INFO.SDP.SIMPLE_PRIM36.ram_SBITERR_UNCONNECTED\ : STD_LOGIC;
  signal \NLW_DEVICE_7SERIES.NO_BMM_INFO.SDP.SIMPLE_PRIM36.ram_DOADO_UNCONNECTED\ : STD_LOGIC_VECTOR ( 31 downto 0 );
  signal \NLW_DEVICE_7SERIES.NO_BMM_INFO.SDP.SIMPLE_PRIM36.ram_DOBDO_UNCONNECTED\ : STD_LOGIC_VECTOR ( 31 downto 8 );
  signal \NLW_DEVICE_7SERIES.NO_BMM_INFO.SDP.SIMPLE_PRIM36.ram_DOPADOP_UNCONNECTED\ : STD_LOGIC_VECTOR ( 3 downto 0 );
  signal \NLW_DEVICE_7SERIES.NO_BMM_INFO.SDP.SIMPLE_PRIM36.ram_DOPBDOP_UNCONNECTED\ : STD_LOGIC_VECTOR ( 3 downto 1 );
  signal \NLW_DEVICE_7SERIES.NO_BMM_INFO.SDP.SIMPLE_PRIM36.ram_ECCPARITY_UNCONNECTED\ : STD_LOGIC_VECTOR ( 7 downto 0 );
  signal \NLW_DEVICE_7SERIES.NO_BMM_INFO.SDP.SIMPLE_PRIM36.ram_RDADDRECC_UNCONNECTED\ : STD_LOGIC_VECTOR ( 8 downto 0 );
  attribute box_type : string;
  attribute box_type of \DEVICE_7SERIES.NO_BMM_INFO.SDP.SIMPLE_PRIM36.ram\ : label is "PRIMITIVE";
begin
\DEVICE_7SERIES.NO_BMM_INFO.SDP.SIMPLE_PRIM36.ram\: unisim.vcomponents.RAMB36E1
    generic map(
      DOA_REG => 0,
      DOB_REG => 0,
      EN_ECC_READ => false,
      EN_ECC_WRITE => false,
      INITP_00 => X"0000000000000000000000000000000000000000000000000000000000000000",
      INITP_01 => X"0000000000000000000000000000000000000000000000000000000000000000",
      INITP_02 => X"0000000000000000000000000000000000000000000000000000000000000000",
      INITP_03 => X"0000000000000000000000000000000000000000000000000000000000000000",
      INITP_04 => X"0000000000000000000000000000000000000000000000000000000000000000",
      INITP_05 => X"0000000000000000000000000000000000000000000000000000000000000000",
      INITP_06 => X"0000000000000000000000000000000000000000000000000000000000000000",
      INITP_07 => X"0000000000000000000000000000000000000000000000000000000000000000",
      INITP_08 => X"0000000000000000000000000000000000000000000000000000000000000000",
      INITP_09 => X"0000000000000000000000000000000000000000000000000000000000000000",
      INITP_0A => X"0000000000000000000000000000000000000000000000000000000000000000",
      INITP_0B => X"0000000000000000000000000000000000000000000000000000000000000000",
      INITP_0C => X"0000000000000000000000000000000000000000000000000000000000000000",
      INITP_0D => X"0000000000000000000000000000000000000000000000000000000000000000",
      INITP_0E => X"0000000000000000000000000000000000000000000000000000000000000000",
      INITP_0F => X"0000000000000000000000000000000000000000000000000000000000000000",
      INIT_00 => X"0000000000000000000000000000000000000000000000000000000000000000",
      INIT_01 => X"0000000000000000000000000000000000000000000000000000000000000000",
      INIT_02 => X"0000000000000000000000000000000000000000000000000000000000000000",
      INIT_03 => X"0000000000000000000000000000000000000000000000000000000000000000",
      INIT_04 => X"0000000000000000000000000000000000000000000000000000000000000000",
      INIT_05 => X"0000000000000000000000000000000000000000000000000000000000000000",
      INIT_06 => X"0000000000000000000000000000000000000000000000000000000000000000",
      INIT_07 => X"0000000000000000000000000000000000000000000000000000000000000000",
      INIT_08 => X"0000000000000000000000000000000000000000000000000000000000000000",
      INIT_09 => X"0000000000000000000000000000000000000000000000000000000000000000",
      INIT_0A => X"0000000000000000000000000000000000000000000000000000000000000000",
      INIT_0B => X"0000000000000000000000000000000000000000000000000000000000000000",
      INIT_0C => X"0000000000000000000000000000000000000000000000000000000000000000",
      INIT_0D => X"0000000000000000000000000000000000000000000000000000000000000000",
      INIT_0E => X"0000000000000000000000000000000000000000000000000000000000000000",
      INIT_0F => X"0000000000000000000000000000000000000000000000000000000000000000",
      INIT_10 => X"0000000000000000000000000000000000000000000000000000000000000000",
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
      RAM_MODE => "TDP",
      RDADDR_COLLISION_HWCONFIG => "DELAYED_WRITE",
      READ_WIDTH_A => 9,
      READ_WIDTH_B => 9,
      RSTREG_PRIORITY_A => "REGCE",
      RSTREG_PRIORITY_B => "REGCE",
      SIM_COLLISION_CHECK => "ALL",
      SIM_DEVICE => "7SERIES",
      SRVAL_A => X"000000000",
      SRVAL_B => X"000000000",
      WRITE_MODE_A => "WRITE_FIRST",
      WRITE_MODE_B => "WRITE_FIRST",
      WRITE_WIDTH_A => 9,
      WRITE_WIDTH_B => 9
    )
        port map (
      ADDRARDADDR(15) => '1',
      ADDRARDADDR(14 downto 3) => Q(11 downto 0),
      ADDRARDADDR(2 downto 0) => B"111",
      ADDRBWRADDR(15) => '1',
      ADDRBWRADDR(14 downto 3) => \DEVICE_7SERIES.NO_BMM_INFO.SDP.SIMPLE_PRIM36.ram_0\(11 downto 0),
      ADDRBWRADDR(2 downto 0) => B"111",
      CASCADEINA => '0',
      CASCADEINB => '0',
      CASCADEOUTA => \NLW_DEVICE_7SERIES.NO_BMM_INFO.SDP.SIMPLE_PRIM36.ram_CASCADEOUTA_UNCONNECTED\,
      CASCADEOUTB => \NLW_DEVICE_7SERIES.NO_BMM_INFO.SDP.SIMPLE_PRIM36.ram_CASCADEOUTB_UNCONNECTED\,
      CLKARDCLK => clk,
      CLKBWRCLK => clk,
      DBITERR => \NLW_DEVICE_7SERIES.NO_BMM_INFO.SDP.SIMPLE_PRIM36.ram_DBITERR_UNCONNECTED\,
      DIADI(31 downto 8) => B"000000000000000000000000",
      DIADI(7 downto 0) => din(7 downto 0),
      DIBDI(31 downto 0) => B"00000000000000000000000000000000",
      DIPADIP(3 downto 0) => B"0000",
      DIPBDIP(3 downto 0) => B"0000",
      DOADO(31 downto 0) => \NLW_DEVICE_7SERIES.NO_BMM_INFO.SDP.SIMPLE_PRIM36.ram_DOADO_UNCONNECTED\(31 downto 0),
      DOBDO(31 downto 8) => \NLW_DEVICE_7SERIES.NO_BMM_INFO.SDP.SIMPLE_PRIM36.ram_DOBDO_UNCONNECTED\(31 downto 8),
      DOBDO(7 downto 0) => doutb_array(7 downto 0),
      DOPADOP(3 downto 0) => \NLW_DEVICE_7SERIES.NO_BMM_INFO.SDP.SIMPLE_PRIM36.ram_DOPADOP_UNCONNECTED\(3 downto 0),
      DOPBDOP(3 downto 1) => \NLW_DEVICE_7SERIES.NO_BMM_INFO.SDP.SIMPLE_PRIM36.ram_DOPBDOP_UNCONNECTED\(3 downto 1),
      DOPBDOP(0) => \DEVICE_7SERIES.NO_BMM_INFO.SDP.SIMPLE_PRIM36.ram_n_75\,
      ECCPARITY(7 downto 0) => \NLW_DEVICE_7SERIES.NO_BMM_INFO.SDP.SIMPLE_PRIM36.ram_ECCPARITY_UNCONNECTED\(7 downto 0),
      ENARDEN => ena_array(0),
      ENBWREN => enb_array(0),
      INJECTDBITERR => '0',
      INJECTSBITERR => '0',
      RDADDRECC(8 downto 0) => \NLW_DEVICE_7SERIES.NO_BMM_INFO.SDP.SIMPLE_PRIM36.ram_RDADDRECC_UNCONNECTED\(8 downto 0),
      REGCEAREGCE => '0',
      REGCEB => '0',
      RSTRAMARSTRAM => '0',
      RSTRAMB => srst,
      RSTREGARSTREG => '0',
      RSTREGB => '0',
      SBITERR => \NLW_DEVICE_7SERIES.NO_BMM_INFO.SDP.SIMPLE_PRIM36.ram_SBITERR_UNCONNECTED\,
      WEA(3) => p_17_out,
      WEA(2) => p_17_out,
      WEA(1) => p_17_out,
      WEA(0) => p_17_out,
      WEBWE(7 downto 0) => B"00000000"
    );
end STRUCTURE;
library IEEE;
use IEEE.STD_LOGIC_1164.ALL;
library UNISIM;
use UNISIM.VCOMPONENTS.ALL;
entity \fifo_8_blk_mem_gen_prim_wrapper__parameterized0\ is
  port (
    doutb_array : out STD_LOGIC_VECTOR ( 7 downto 0 );
    clk : in STD_LOGIC;
    ena_array : in STD_LOGIC_VECTOR ( 0 to 0 );
    enb_array : in STD_LOGIC_VECTOR ( 0 to 0 );
    srst : in STD_LOGIC;
    Q : in STD_LOGIC_VECTOR ( 11 downto 0 );
    \DEVICE_7SERIES.NO_BMM_INFO.SDP.SIMPLE_PRIM36.ram_0\ : in STD_LOGIC_VECTOR ( 11 downto 0 );
    din : in STD_LOGIC_VECTOR ( 7 downto 0 );
    p_17_out : in STD_LOGIC
  );
  attribute ORIG_REF_NAME : string;
  attribute ORIG_REF_NAME of \fifo_8_blk_mem_gen_prim_wrapper__parameterized0\ : entity is "blk_mem_gen_prim_wrapper";
end \fifo_8_blk_mem_gen_prim_wrapper__parameterized0\;

architecture STRUCTURE of \fifo_8_blk_mem_gen_prim_wrapper__parameterized0\ is
  signal \DEVICE_7SERIES.NO_BMM_INFO.SDP.SIMPLE_PRIM36.ram_n_75\ : STD_LOGIC;
  signal \NLW_DEVICE_7SERIES.NO_BMM_INFO.SDP.SIMPLE_PRIM36.ram_CASCADEOUTA_UNCONNECTED\ : STD_LOGIC;
  signal \NLW_DEVICE_7SERIES.NO_BMM_INFO.SDP.SIMPLE_PRIM36.ram_CASCADEOUTB_UNCONNECTED\ : STD_LOGIC;
  signal \NLW_DEVICE_7SERIES.NO_BMM_INFO.SDP.SIMPLE_PRIM36.ram_DBITERR_UNCONNECTED\ : STD_LOGIC;
  signal \NLW_DEVICE_7SERIES.NO_BMM_INFO.SDP.SIMPLE_PRIM36.ram_SBITERR_UNCONNECTED\ : STD_LOGIC;
  signal \NLW_DEVICE_7SERIES.NO_BMM_INFO.SDP.SIMPLE_PRIM36.ram_DOADO_UNCONNECTED\ : STD_LOGIC_VECTOR ( 31 downto 0 );
  signal \NLW_DEVICE_7SERIES.NO_BMM_INFO.SDP.SIMPLE_PRIM36.ram_DOBDO_UNCONNECTED\ : STD_LOGIC_VECTOR ( 31 downto 8 );
  signal \NLW_DEVICE_7SERIES.NO_BMM_INFO.SDP.SIMPLE_PRIM36.ram_DOPADOP_UNCONNECTED\ : STD_LOGIC_VECTOR ( 3 downto 0 );
  signal \NLW_DEVICE_7SERIES.NO_BMM_INFO.SDP.SIMPLE_PRIM36.ram_DOPBDOP_UNCONNECTED\ : STD_LOGIC_VECTOR ( 3 downto 1 );
  signal \NLW_DEVICE_7SERIES.NO_BMM_INFO.SDP.SIMPLE_PRIM36.ram_ECCPARITY_UNCONNECTED\ : STD_LOGIC_VECTOR ( 7 downto 0 );
  signal \NLW_DEVICE_7SERIES.NO_BMM_INFO.SDP.SIMPLE_PRIM36.ram_RDADDRECC_UNCONNECTED\ : STD_LOGIC_VECTOR ( 8 downto 0 );
  attribute box_type : string;
  attribute box_type of \DEVICE_7SERIES.NO_BMM_INFO.SDP.SIMPLE_PRIM36.ram\ : label is "PRIMITIVE";
begin
\DEVICE_7SERIES.NO_BMM_INFO.SDP.SIMPLE_PRIM36.ram\: unisim.vcomponents.RAMB36E1
    generic map(
      DOA_REG => 0,
      DOB_REG => 0,
      EN_ECC_READ => false,
      EN_ECC_WRITE => false,
      INITP_00 => X"0000000000000000000000000000000000000000000000000000000000000000",
      INITP_01 => X"0000000000000000000000000000000000000000000000000000000000000000",
      INITP_02 => X"0000000000000000000000000000000000000000000000000000000000000000",
      INITP_03 => X"0000000000000000000000000000000000000000000000000000000000000000",
      INITP_04 => X"0000000000000000000000000000000000000000000000000000000000000000",
      INITP_05 => X"0000000000000000000000000000000000000000000000000000000000000000",
      INITP_06 => X"0000000000000000000000000000000000000000000000000000000000000000",
      INITP_07 => X"0000000000000000000000000000000000000000000000000000000000000000",
      INITP_08 => X"0000000000000000000000000000000000000000000000000000000000000000",
      INITP_09 => X"0000000000000000000000000000000000000000000000000000000000000000",
      INITP_0A => X"0000000000000000000000000000000000000000000000000000000000000000",
      INITP_0B => X"0000000000000000000000000000000000000000000000000000000000000000",
      INITP_0C => X"0000000000000000000000000000000000000000000000000000000000000000",
      INITP_0D => X"0000000000000000000000000000000000000000000000000000000000000000",
      INITP_0E => X"0000000000000000000000000000000000000000000000000000000000000000",
      INITP_0F => X"0000000000000000000000000000000000000000000000000000000000000000",
      INIT_00 => X"0000000000000000000000000000000000000000000000000000000000000000",
      INIT_01 => X"0000000000000000000000000000000000000000000000000000000000000000",
      INIT_02 => X"0000000000000000000000000000000000000000000000000000000000000000",
      INIT_03 => X"0000000000000000000000000000000000000000000000000000000000000000",
      INIT_04 => X"0000000000000000000000000000000000000000000000000000000000000000",
      INIT_05 => X"0000000000000000000000000000000000000000000000000000000000000000",
      INIT_06 => X"0000000000000000000000000000000000000000000000000000000000000000",
      INIT_07 => X"0000000000000000000000000000000000000000000000000000000000000000",
      INIT_08 => X"0000000000000000000000000000000000000000000000000000000000000000",
      INIT_09 => X"0000000000000000000000000000000000000000000000000000000000000000",
      INIT_0A => X"0000000000000000000000000000000000000000000000000000000000000000",
      INIT_0B => X"0000000000000000000000000000000000000000000000000000000000000000",
      INIT_0C => X"0000000000000000000000000000000000000000000000000000000000000000",
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
      IS_CLKBWRCLK_INVERTED => '0',
      IS_ENARDEN_INVERTED => '0',
      IS_ENBWREN_INVERTED => '0',
      IS_RSTRAMARSTRAM_INVERTED => '0',
      IS_RSTRAMB_INVERTED => '0',
      IS_RSTREGARSTREG_INVERTED => '0',
      IS_RSTREGB_INVERTED => '0',
      RAM_EXTENSION_A => "NONE",
      RAM_EXTENSION_B => "NONE",
      RAM_MODE => "TDP",
      RDADDR_COLLISION_HWCONFIG => "DELAYED_WRITE",
      READ_WIDTH_A => 9,
      READ_WIDTH_B => 9,
      RSTREG_PRIORITY_A => "REGCE",
      RSTREG_PRIORITY_B => "REGCE",
      SIM_COLLISION_CHECK => "ALL",
      SIM_DEVICE => "7SERIES",
      SRVAL_A => X"000000000",
      SRVAL_B => X"000000000",
      WRITE_MODE_A => "WRITE_FIRST",
      WRITE_MODE_B => "WRITE_FIRST",
      WRITE_WIDTH_A => 9,
      WRITE_WIDTH_B => 9
    )
        port map (
      ADDRARDADDR(15) => '1',
      ADDRARDADDR(14 downto 3) => Q(11 downto 0),
      ADDRARDADDR(2 downto 0) => B"111",
      ADDRBWRADDR(15) => '1',
      ADDRBWRADDR(14 downto 3) => \DEVICE_7SERIES.NO_BMM_INFO.SDP.SIMPLE_PRIM36.ram_0\(11 downto 0),
      ADDRBWRADDR(2 downto 0) => B"111",
      CASCADEINA => '0',
      CASCADEINB => '0',
      CASCADEOUTA => \NLW_DEVICE_7SERIES.NO_BMM_INFO.SDP.SIMPLE_PRIM36.ram_CASCADEOUTA_UNCONNECTED\,
      CASCADEOUTB => \NLW_DEVICE_7SERIES.NO_BMM_INFO.SDP.SIMPLE_PRIM36.ram_CASCADEOUTB_UNCONNECTED\,
      CLKARDCLK => clk,
      CLKBWRCLK => clk,
      DBITERR => \NLW_DEVICE_7SERIES.NO_BMM_INFO.SDP.SIMPLE_PRIM36.ram_DBITERR_UNCONNECTED\,
      DIADI(31 downto 8) => B"000000000000000000000000",
      DIADI(7 downto 0) => din(7 downto 0),
      DIBDI(31 downto 0) => B"00000000000000000000000000000000",
      DIPADIP(3 downto 0) => B"0000",
      DIPBDIP(3 downto 0) => B"0000",
      DOADO(31 downto 0) => \NLW_DEVICE_7SERIES.NO_BMM_INFO.SDP.SIMPLE_PRIM36.ram_DOADO_UNCONNECTED\(31 downto 0),
      DOBDO(31 downto 8) => \NLW_DEVICE_7SERIES.NO_BMM_INFO.SDP.SIMPLE_PRIM36.ram_DOBDO_UNCONNECTED\(31 downto 8),
      DOBDO(7 downto 0) => doutb_array(7 downto 0),
      DOPADOP(3 downto 0) => \NLW_DEVICE_7SERIES.NO_BMM_INFO.SDP.SIMPLE_PRIM36.ram_DOPADOP_UNCONNECTED\(3 downto 0),
      DOPBDOP(3 downto 1) => \NLW_DEVICE_7SERIES.NO_BMM_INFO.SDP.SIMPLE_PRIM36.ram_DOPBDOP_UNCONNECTED\(3 downto 1),
      DOPBDOP(0) => \DEVICE_7SERIES.NO_BMM_INFO.SDP.SIMPLE_PRIM36.ram_n_75\,
      ECCPARITY(7 downto 0) => \NLW_DEVICE_7SERIES.NO_BMM_INFO.SDP.SIMPLE_PRIM36.ram_ECCPARITY_UNCONNECTED\(7 downto 0),
      ENARDEN => ena_array(0),
      ENBWREN => enb_array(0),
      INJECTDBITERR => '0',
      INJECTSBITERR => '0',
      RDADDRECC(8 downto 0) => \NLW_DEVICE_7SERIES.NO_BMM_INFO.SDP.SIMPLE_PRIM36.ram_RDADDRECC_UNCONNECTED\(8 downto 0),
      REGCEAREGCE => '0',
      REGCEB => '0',
      RSTRAMARSTRAM => '0',
      RSTRAMB => srst,
      RSTREGARSTREG => '0',
      RSTREGB => '0',
      SBITERR => \NLW_DEVICE_7SERIES.NO_BMM_INFO.SDP.SIMPLE_PRIM36.ram_SBITERR_UNCONNECTED\,
      WEA(3) => p_17_out,
      WEA(2) => p_17_out,
      WEA(1) => p_17_out,
      WEA(0) => p_17_out,
      WEBWE(7 downto 0) => B"00000000"
    );
end STRUCTURE;
library IEEE;
use IEEE.STD_LOGIC_1164.ALL;
library UNISIM;
use UNISIM.VCOMPONENTS.ALL;
entity \fifo_8_blk_mem_gen_prim_wrapper__parameterized1\ is
  port (
    doutb_array : out STD_LOGIC_VECTOR ( 7 downto 0 );
    clk : in STD_LOGIC;
    ena_array : in STD_LOGIC_VECTOR ( 0 to 0 );
    enb_array : in STD_LOGIC_VECTOR ( 0 to 0 );
    srst : in STD_LOGIC;
    Q : in STD_LOGIC_VECTOR ( 11 downto 0 );
    \DEVICE_7SERIES.NO_BMM_INFO.SDP.SIMPLE_PRIM36.ram_0\ : in STD_LOGIC_VECTOR ( 11 downto 0 );
    din : in STD_LOGIC_VECTOR ( 7 downto 0 );
    p_17_out : in STD_LOGIC
  );
  attribute ORIG_REF_NAME : string;
  attribute ORIG_REF_NAME of \fifo_8_blk_mem_gen_prim_wrapper__parameterized1\ : entity is "blk_mem_gen_prim_wrapper";
end \fifo_8_blk_mem_gen_prim_wrapper__parameterized1\;

architecture STRUCTURE of \fifo_8_blk_mem_gen_prim_wrapper__parameterized1\ is
  signal \DEVICE_7SERIES.NO_BMM_INFO.SDP.SIMPLE_PRIM36.ram_n_75\ : STD_LOGIC;
  signal \NLW_DEVICE_7SERIES.NO_BMM_INFO.SDP.SIMPLE_PRIM36.ram_CASCADEOUTA_UNCONNECTED\ : STD_LOGIC;
  signal \NLW_DEVICE_7SERIES.NO_BMM_INFO.SDP.SIMPLE_PRIM36.ram_CASCADEOUTB_UNCONNECTED\ : STD_LOGIC;
  signal \NLW_DEVICE_7SERIES.NO_BMM_INFO.SDP.SIMPLE_PRIM36.ram_DBITERR_UNCONNECTED\ : STD_LOGIC;
  signal \NLW_DEVICE_7SERIES.NO_BMM_INFO.SDP.SIMPLE_PRIM36.ram_SBITERR_UNCONNECTED\ : STD_LOGIC;
  signal \NLW_DEVICE_7SERIES.NO_BMM_INFO.SDP.SIMPLE_PRIM36.ram_DOADO_UNCONNECTED\ : STD_LOGIC_VECTOR ( 31 downto 0 );
  signal \NLW_DEVICE_7SERIES.NO_BMM_INFO.SDP.SIMPLE_PRIM36.ram_DOBDO_UNCONNECTED\ : STD_LOGIC_VECTOR ( 31 downto 8 );
  signal \NLW_DEVICE_7SERIES.NO_BMM_INFO.SDP.SIMPLE_PRIM36.ram_DOPADOP_UNCONNECTED\ : STD_LOGIC_VECTOR ( 3 downto 0 );
  signal \NLW_DEVICE_7SERIES.NO_BMM_INFO.SDP.SIMPLE_PRIM36.ram_DOPBDOP_UNCONNECTED\ : STD_LOGIC_VECTOR ( 3 downto 1 );
  signal \NLW_DEVICE_7SERIES.NO_BMM_INFO.SDP.SIMPLE_PRIM36.ram_ECCPARITY_UNCONNECTED\ : STD_LOGIC_VECTOR ( 7 downto 0 );
  signal \NLW_DEVICE_7SERIES.NO_BMM_INFO.SDP.SIMPLE_PRIM36.ram_RDADDRECC_UNCONNECTED\ : STD_LOGIC_VECTOR ( 8 downto 0 );
  attribute box_type : string;
  attribute box_type of \DEVICE_7SERIES.NO_BMM_INFO.SDP.SIMPLE_PRIM36.ram\ : label is "PRIMITIVE";
begin
\DEVICE_7SERIES.NO_BMM_INFO.SDP.SIMPLE_PRIM36.ram\: unisim.vcomponents.RAMB36E1
    generic map(
      DOA_REG => 0,
      DOB_REG => 0,
      EN_ECC_READ => false,
      EN_ECC_WRITE => false,
      INITP_00 => X"0000000000000000000000000000000000000000000000000000000000000000",
      INITP_01 => X"0000000000000000000000000000000000000000000000000000000000000000",
      INITP_02 => X"0000000000000000000000000000000000000000000000000000000000000000",
      INITP_03 => X"0000000000000000000000000000000000000000000000000000000000000000",
      INITP_04 => X"0000000000000000000000000000000000000000000000000000000000000000",
      INITP_05 => X"0000000000000000000000000000000000000000000000000000000000000000",
      INITP_06 => X"0000000000000000000000000000000000000000000000000000000000000000",
      INITP_07 => X"0000000000000000000000000000000000000000000000000000000000000000",
      INITP_08 => X"0000000000000000000000000000000000000000000000000000000000000000",
      INITP_09 => X"0000000000000000000000000000000000000000000000000000000000000000",
      INITP_0A => X"0000000000000000000000000000000000000000000000000000000000000000",
      INITP_0B => X"0000000000000000000000000000000000000000000000000000000000000000",
      INITP_0C => X"0000000000000000000000000000000000000000000000000000000000000000",
      INITP_0D => X"0000000000000000000000000000000000000000000000000000000000000000",
      INITP_0E => X"0000000000000000000000000000000000000000000000000000000000000000",
      INITP_0F => X"0000000000000000000000000000000000000000000000000000000000000000",
      INIT_00 => X"0000000000000000000000000000000000000000000000000000000000000000",
      INIT_01 => X"0000000000000000000000000000000000000000000000000000000000000000",
      INIT_02 => X"0000000000000000000000000000000000000000000000000000000000000000",
      INIT_03 => X"0000000000000000000000000000000000000000000000000000000000000000",
      INIT_04 => X"0000000000000000000000000000000000000000000000000000000000000000",
      INIT_05 => X"0000000000000000000000000000000000000000000000000000000000000000",
      INIT_06 => X"0000000000000000000000000000000000000000000000000000000000000000",
      INIT_07 => X"0000000000000000000000000000000000000000000000000000000000000000",
      INIT_08 => X"0000000000000000000000000000000000000000000000000000000000000000",
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
      INIT_7E => X"0000000000000000000000000000000000000000000000000000000000000000",
      INIT_7F => X"0000000000000000000000000000000000000000000000000000000000000000",
      INIT_A => X"000000000",
      INIT_B => X"000000000",
      INIT_FILE => "NONE",
      IS_CLKARDCLK_INVERTED => '0',
      IS_CLKBWRCLK_INVERTED => '0',
      IS_ENARDEN_INVERTED => '0',
      IS_ENBWREN_INVERTED => '0',
      IS_RSTRAMARSTRAM_INVERTED => '0',
      IS_RSTRAMB_INVERTED => '0',
      IS_RSTREGARSTREG_INVERTED => '0',
      IS_RSTREGB_INVERTED => '0',
      RAM_EXTENSION_A => "NONE",
      RAM_EXTENSION_B => "NONE",
      RAM_MODE => "TDP",
      RDADDR_COLLISION_HWCONFIG => "DELAYED_WRITE",
      READ_WIDTH_A => 9,
      READ_WIDTH_B => 9,
      RSTREG_PRIORITY_A => "REGCE",
      RSTREG_PRIORITY_B => "REGCE",
      SIM_COLLISION_CHECK => "ALL",
      SIM_DEVICE => "7SERIES",
      SRVAL_A => X"000000000",
      SRVAL_B => X"000000000",
      WRITE_MODE_A => "WRITE_FIRST",
      WRITE_MODE_B => "WRITE_FIRST",
      WRITE_WIDTH_A => 9,
      WRITE_WIDTH_B => 9
    )
        port map (
      ADDRARDADDR(15) => '1',
      ADDRARDADDR(14 downto 3) => Q(11 downto 0),
      ADDRARDADDR(2 downto 0) => B"111",
      ADDRBWRADDR(15) => '1',
      ADDRBWRADDR(14 downto 3) => \DEVICE_7SERIES.NO_BMM_INFO.SDP.SIMPLE_PRIM36.ram_0\(11 downto 0),
      ADDRBWRADDR(2 downto 0) => B"111",
      CASCADEINA => '0',
      CASCADEINB => '0',
      CASCADEOUTA => \NLW_DEVICE_7SERIES.NO_BMM_INFO.SDP.SIMPLE_PRIM36.ram_CASCADEOUTA_UNCONNECTED\,
      CASCADEOUTB => \NLW_DEVICE_7SERIES.NO_BMM_INFO.SDP.SIMPLE_PRIM36.ram_CASCADEOUTB_UNCONNECTED\,
      CLKARDCLK => clk,
      CLKBWRCLK => clk,
      DBITERR => \NLW_DEVICE_7SERIES.NO_BMM_INFO.SDP.SIMPLE_PRIM36.ram_DBITERR_UNCONNECTED\,
      DIADI(31 downto 8) => B"000000000000000000000000",
      DIADI(7 downto 0) => din(7 downto 0),
      DIBDI(31 downto 0) => B"00000000000000000000000000000000",
      DIPADIP(3 downto 0) => B"0000",
      DIPBDIP(3 downto 0) => B"0000",
      DOADO(31 downto 0) => \NLW_DEVICE_7SERIES.NO_BMM_INFO.SDP.SIMPLE_PRIM36.ram_DOADO_UNCONNECTED\(31 downto 0),
      DOBDO(31 downto 8) => \NLW_DEVICE_7SERIES.NO_BMM_INFO.SDP.SIMPLE_PRIM36.ram_DOBDO_UNCONNECTED\(31 downto 8),
      DOBDO(7 downto 0) => doutb_array(7 downto 0),
      DOPADOP(3 downto 0) => \NLW_DEVICE_7SERIES.NO_BMM_INFO.SDP.SIMPLE_PRIM36.ram_DOPADOP_UNCONNECTED\(3 downto 0),
      DOPBDOP(3 downto 1) => \NLW_DEVICE_7SERIES.NO_BMM_INFO.SDP.SIMPLE_PRIM36.ram_DOPBDOP_UNCONNECTED\(3 downto 1),
      DOPBDOP(0) => \DEVICE_7SERIES.NO_BMM_INFO.SDP.SIMPLE_PRIM36.ram_n_75\,
      ECCPARITY(7 downto 0) => \NLW_DEVICE_7SERIES.NO_BMM_INFO.SDP.SIMPLE_PRIM36.ram_ECCPARITY_UNCONNECTED\(7 downto 0),
      ENARDEN => ena_array(0),
      ENBWREN => enb_array(0),
      INJECTDBITERR => '0',
      INJECTSBITERR => '0',
      RDADDRECC(8 downto 0) => \NLW_DEVICE_7SERIES.NO_BMM_INFO.SDP.SIMPLE_PRIM36.ram_RDADDRECC_UNCONNECTED\(8 downto 0),
      REGCEAREGCE => '0',
      REGCEB => '0',
      RSTRAMARSTRAM => '0',
      RSTRAMB => srst,
      RSTREGARSTREG => '0',
      RSTREGB => '0',
      SBITERR => \NLW_DEVICE_7SERIES.NO_BMM_INFO.SDP.SIMPLE_PRIM36.ram_SBITERR_UNCONNECTED\,
      WEA(3) => p_17_out,
      WEA(2) => p_17_out,
      WEA(1) => p_17_out,
      WEA(0) => p_17_out,
      WEBWE(7 downto 0) => B"00000000"
    );
end STRUCTURE;
library IEEE;
use IEEE.STD_LOGIC_1164.ALL;
library UNISIM;
use UNISIM.VCOMPONENTS.ALL;
entity \fifo_8_blk_mem_gen_prim_wrapper__parameterized2\ is
  port (
    doutb_array : out STD_LOGIC_VECTOR ( 7 downto 0 );
    clk : in STD_LOGIC;
    \DEVICE_7SERIES.NO_BMM_INFO.SDP.SIMPLE_PRIM36.ram_0\ : in STD_LOGIC;
    \DEVICE_7SERIES.NO_BMM_INFO.SDP.SIMPLE_PRIM36.ram_1\ : in STD_LOGIC;
    srst : in STD_LOGIC;
    Q : in STD_LOGIC_VECTOR ( 11 downto 0 );
    \DEVICE_7SERIES.NO_BMM_INFO.SDP.SIMPLE_PRIM36.ram_2\ : in STD_LOGIC_VECTOR ( 11 downto 0 );
    din : in STD_LOGIC_VECTOR ( 7 downto 0 );
    p_17_out : in STD_LOGIC
  );
  attribute ORIG_REF_NAME : string;
  attribute ORIG_REF_NAME of \fifo_8_blk_mem_gen_prim_wrapper__parameterized2\ : entity is "blk_mem_gen_prim_wrapper";
end \fifo_8_blk_mem_gen_prim_wrapper__parameterized2\;

architecture STRUCTURE of \fifo_8_blk_mem_gen_prim_wrapper__parameterized2\ is
  signal \DEVICE_7SERIES.NO_BMM_INFO.SDP.SIMPLE_PRIM36.ram_n_75\ : STD_LOGIC;
  signal \NLW_DEVICE_7SERIES.NO_BMM_INFO.SDP.SIMPLE_PRIM36.ram_CASCADEOUTA_UNCONNECTED\ : STD_LOGIC;
  signal \NLW_DEVICE_7SERIES.NO_BMM_INFO.SDP.SIMPLE_PRIM36.ram_CASCADEOUTB_UNCONNECTED\ : STD_LOGIC;
  signal \NLW_DEVICE_7SERIES.NO_BMM_INFO.SDP.SIMPLE_PRIM36.ram_DBITERR_UNCONNECTED\ : STD_LOGIC;
  signal \NLW_DEVICE_7SERIES.NO_BMM_INFO.SDP.SIMPLE_PRIM36.ram_SBITERR_UNCONNECTED\ : STD_LOGIC;
  signal \NLW_DEVICE_7SERIES.NO_BMM_INFO.SDP.SIMPLE_PRIM36.ram_DOADO_UNCONNECTED\ : STD_LOGIC_VECTOR ( 31 downto 0 );
  signal \NLW_DEVICE_7SERIES.NO_BMM_INFO.SDP.SIMPLE_PRIM36.ram_DOBDO_UNCONNECTED\ : STD_LOGIC_VECTOR ( 31 downto 8 );
  signal \NLW_DEVICE_7SERIES.NO_BMM_INFO.SDP.SIMPLE_PRIM36.ram_DOPADOP_UNCONNECTED\ : STD_LOGIC_VECTOR ( 3 downto 0 );
  signal \NLW_DEVICE_7SERIES.NO_BMM_INFO.SDP.SIMPLE_PRIM36.ram_DOPBDOP_UNCONNECTED\ : STD_LOGIC_VECTOR ( 3 downto 1 );
  signal \NLW_DEVICE_7SERIES.NO_BMM_INFO.SDP.SIMPLE_PRIM36.ram_ECCPARITY_UNCONNECTED\ : STD_LOGIC_VECTOR ( 7 downto 0 );
  signal \NLW_DEVICE_7SERIES.NO_BMM_INFO.SDP.SIMPLE_PRIM36.ram_RDADDRECC_UNCONNECTED\ : STD_LOGIC_VECTOR ( 8 downto 0 );
  attribute box_type : string;
  attribute box_type of \DEVICE_7SERIES.NO_BMM_INFO.SDP.SIMPLE_PRIM36.ram\ : label is "PRIMITIVE";
begin
\DEVICE_7SERIES.NO_BMM_INFO.SDP.SIMPLE_PRIM36.ram\: unisim.vcomponents.RAMB36E1
    generic map(
      DOA_REG => 0,
      DOB_REG => 0,
      EN_ECC_READ => false,
      EN_ECC_WRITE => false,
      INITP_00 => X"0000000000000000000000000000000000000000000000000000000000000000",
      INITP_01 => X"0000000000000000000000000000000000000000000000000000000000000000",
      INITP_02 => X"0000000000000000000000000000000000000000000000000000000000000000",
      INITP_03 => X"0000000000000000000000000000000000000000000000000000000000000000",
      INITP_04 => X"0000000000000000000000000000000000000000000000000000000000000000",
      INITP_05 => X"0000000000000000000000000000000000000000000000000000000000000000",
      INITP_06 => X"0000000000000000000000000000000000000000000000000000000000000000",
      INITP_07 => X"0000000000000000000000000000000000000000000000000000000000000000",
      INITP_08 => X"0000000000000000000000000000000000000000000000000000000000000000",
      INITP_09 => X"0000000000000000000000000000000000000000000000000000000000000000",
      INITP_0A => X"0000000000000000000000000000000000000000000000000000000000000000",
      INITP_0B => X"0000000000000000000000000000000000000000000000000000000000000000",
      INITP_0C => X"0000000000000000000000000000000000000000000000000000000000000000",
      INITP_0D => X"0000000000000000000000000000000000000000000000000000000000000000",
      INITP_0E => X"0000000000000000000000000000000000000000000000000000000000000000",
      INITP_0F => X"0000000000000000000000000000000000000000000000000000000000000000",
      INIT_00 => X"0000000000000000000000000000000000000000000000000000000000000000",
      INIT_01 => X"0000000000000000000000000000000000000000000000000000000000000000",
      INIT_02 => X"0000000000000000000000000000000000000000000000000000000000000000",
      INIT_03 => X"0000000000000000000000000000000000000000000000000000000000000000",
      INIT_04 => X"0000000000000000000000000000000000000000000000000000000000000000",
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
      INIT_79 => X"0000000000000000000000000000000000000000000000000000000000000000",
      INIT_7A => X"0000000000000000000000000000000000000000000000000000000000000000",
      INIT_7B => X"0000000000000000000000000000000000000000000000000000000000000000",
      INIT_7C => X"0000000000000000000000000000000000000000000000000000000000000000",
      INIT_7D => X"0000000000000000000000000000000000000000000000000000000000000000",
      INIT_7E => X"0000000000000000000000000000000000000000000000000000000000000000",
      INIT_7F => X"0000000000000000000000000000000000000000000000000000000000000000",
      INIT_A => X"000000000",
      INIT_B => X"000000000",
      INIT_FILE => "NONE",
      IS_CLKARDCLK_INVERTED => '0',
      IS_CLKBWRCLK_INVERTED => '0',
      IS_ENARDEN_INVERTED => '0',
      IS_ENBWREN_INVERTED => '0',
      IS_RSTRAMARSTRAM_INVERTED => '0',
      IS_RSTRAMB_INVERTED => '0',
      IS_RSTREGARSTREG_INVERTED => '0',
      IS_RSTREGB_INVERTED => '0',
      RAM_EXTENSION_A => "NONE",
      RAM_EXTENSION_B => "NONE",
      RAM_MODE => "TDP",
      RDADDR_COLLISION_HWCONFIG => "DELAYED_WRITE",
      READ_WIDTH_A => 9,
      READ_WIDTH_B => 9,
      RSTREG_PRIORITY_A => "REGCE",
      RSTREG_PRIORITY_B => "REGCE",
      SIM_COLLISION_CHECK => "ALL",
      SIM_DEVICE => "7SERIES",
      SRVAL_A => X"000000000",
      SRVAL_B => X"000000000",
      WRITE_MODE_A => "WRITE_FIRST",
      WRITE_MODE_B => "WRITE_FIRST",
      WRITE_WIDTH_A => 9,
      WRITE_WIDTH_B => 9
    )
        port map (
      ADDRARDADDR(15) => '1',
      ADDRARDADDR(14 downto 3) => Q(11 downto 0),
      ADDRARDADDR(2 downto 0) => B"111",
      ADDRBWRADDR(15) => '1',
      ADDRBWRADDR(14 downto 3) => \DEVICE_7SERIES.NO_BMM_INFO.SDP.SIMPLE_PRIM36.ram_2\(11 downto 0),
      ADDRBWRADDR(2 downto 0) => B"111",
      CASCADEINA => '0',
      CASCADEINB => '0',
      CASCADEOUTA => \NLW_DEVICE_7SERIES.NO_BMM_INFO.SDP.SIMPLE_PRIM36.ram_CASCADEOUTA_UNCONNECTED\,
      CASCADEOUTB => \NLW_DEVICE_7SERIES.NO_BMM_INFO.SDP.SIMPLE_PRIM36.ram_CASCADEOUTB_UNCONNECTED\,
      CLKARDCLK => clk,
      CLKBWRCLK => clk,
      DBITERR => \NLW_DEVICE_7SERIES.NO_BMM_INFO.SDP.SIMPLE_PRIM36.ram_DBITERR_UNCONNECTED\,
      DIADI(31 downto 8) => B"000000000000000000000000",
      DIADI(7 downto 0) => din(7 downto 0),
      DIBDI(31 downto 0) => B"00000000000000000000000000000000",
      DIPADIP(3 downto 0) => B"0000",
      DIPBDIP(3 downto 0) => B"0000",
      DOADO(31 downto 0) => \NLW_DEVICE_7SERIES.NO_BMM_INFO.SDP.SIMPLE_PRIM36.ram_DOADO_UNCONNECTED\(31 downto 0),
      DOBDO(31 downto 8) => \NLW_DEVICE_7SERIES.NO_BMM_INFO.SDP.SIMPLE_PRIM36.ram_DOBDO_UNCONNECTED\(31 downto 8),
      DOBDO(7 downto 0) => doutb_array(7 downto 0),
      DOPADOP(3 downto 0) => \NLW_DEVICE_7SERIES.NO_BMM_INFO.SDP.SIMPLE_PRIM36.ram_DOPADOP_UNCONNECTED\(3 downto 0),
      DOPBDOP(3 downto 1) => \NLW_DEVICE_7SERIES.NO_BMM_INFO.SDP.SIMPLE_PRIM36.ram_DOPBDOP_UNCONNECTED\(3 downto 1),
      DOPBDOP(0) => \DEVICE_7SERIES.NO_BMM_INFO.SDP.SIMPLE_PRIM36.ram_n_75\,
      ECCPARITY(7 downto 0) => \NLW_DEVICE_7SERIES.NO_BMM_INFO.SDP.SIMPLE_PRIM36.ram_ECCPARITY_UNCONNECTED\(7 downto 0),
      ENARDEN => \DEVICE_7SERIES.NO_BMM_INFO.SDP.SIMPLE_PRIM36.ram_0\,
      ENBWREN => \DEVICE_7SERIES.NO_BMM_INFO.SDP.SIMPLE_PRIM36.ram_1\,
      INJECTDBITERR => '0',
      INJECTSBITERR => '0',
      RDADDRECC(8 downto 0) => \NLW_DEVICE_7SERIES.NO_BMM_INFO.SDP.SIMPLE_PRIM36.ram_RDADDRECC_UNCONNECTED\(8 downto 0),
      REGCEAREGCE => '0',
      REGCEB => '0',
      RSTRAMARSTRAM => '0',
      RSTRAMB => srst,
      RSTREGARSTREG => '0',
      RSTREGB => '0',
      SBITERR => \NLW_DEVICE_7SERIES.NO_BMM_INFO.SDP.SIMPLE_PRIM36.ram_SBITERR_UNCONNECTED\,
      WEA(3) => p_17_out,
      WEA(2) => p_17_out,
      WEA(1) => p_17_out,
      WEA(0) => p_17_out,
      WEBWE(7 downto 0) => B"00000000"
    );
end STRUCTURE;
library IEEE;
use IEEE.STD_LOGIC_1164.ALL;
library UNISIM;
use UNISIM.VCOMPONENTS.ALL;
entity fifo_8_compare is
  port (
    comp0 : out STD_LOGIC;
    v1_reg : in STD_LOGIC_VECTOR ( 6 downto 0 )
  );
  attribute ORIG_REF_NAME : string;
  attribute ORIG_REF_NAME of fifo_8_compare : entity is "compare";
end fifo_8_compare;

architecture STRUCTURE of fifo_8_compare is
  signal carrynet_0 : STD_LOGIC;
  signal carrynet_1 : STD_LOGIC;
  signal carrynet_2 : STD_LOGIC;
  signal carrynet_3 : STD_LOGIC;
  signal carrynet_4 : STD_LOGIC;
  signal carrynet_5 : STD_LOGIC;
  signal \NLW_gmux.gm[0].gm1.m1_CARRY4_O_UNCONNECTED\ : STD_LOGIC_VECTOR ( 3 downto 0 );
  signal \NLW_gmux.gm[4].gms.ms_CARRY4_CO_UNCONNECTED\ : STD_LOGIC_VECTOR ( 3 to 3 );
  signal \NLW_gmux.gm[4].gms.ms_CARRY4_DI_UNCONNECTED\ : STD_LOGIC_VECTOR ( 3 to 3 );
  signal \NLW_gmux.gm[4].gms.ms_CARRY4_O_UNCONNECTED\ : STD_LOGIC_VECTOR ( 3 downto 0 );
  signal \NLW_gmux.gm[4].gms.ms_CARRY4_S_UNCONNECTED\ : STD_LOGIC_VECTOR ( 3 to 3 );
  attribute OPT_MODIFIED : string;
  attribute OPT_MODIFIED of \gmux.gm[0].gm1.m1_CARRY4\ : label is "MLO ";
  attribute XILINX_LEGACY_PRIM : string;
  attribute XILINX_LEGACY_PRIM of \gmux.gm[0].gm1.m1_CARRY4\ : label is "(MUXCY,XORCY)";
  attribute box_type : string;
  attribute box_type of \gmux.gm[0].gm1.m1_CARRY4\ : label is "PRIMITIVE";
  attribute OPT_MODIFIED of \gmux.gm[4].gms.ms_CARRY4\ : label is "MLO ";
  attribute XILINX_LEGACY_PRIM of \gmux.gm[4].gms.ms_CARRY4\ : label is "(MUXCY,XORCY)";
  attribute box_type of \gmux.gm[4].gms.ms_CARRY4\ : label is "PRIMITIVE";
begin
\gmux.gm[0].gm1.m1_CARRY4\: unisim.vcomponents.CARRY4
     port map (
      CI => '0',
      CO(3) => carrynet_3,
      CO(2) => carrynet_2,
      CO(1) => carrynet_1,
      CO(0) => carrynet_0,
      CYINIT => '1',
      DI(3 downto 0) => B"0000",
      O(3 downto 0) => \NLW_gmux.gm[0].gm1.m1_CARRY4_O_UNCONNECTED\(3 downto 0),
      S(3 downto 0) => v1_reg(3 downto 0)
    );
\gmux.gm[4].gms.ms_CARRY4\: unisim.vcomponents.CARRY4
     port map (
      CI => carrynet_3,
      CO(3) => \NLW_gmux.gm[4].gms.ms_CARRY4_CO_UNCONNECTED\(3),
      CO(2) => comp0,
      CO(1) => carrynet_5,
      CO(0) => carrynet_4,
      CYINIT => '0',
      DI(3) => \NLW_gmux.gm[4].gms.ms_CARRY4_DI_UNCONNECTED\(3),
      DI(2 downto 0) => B"000",
      O(3 downto 0) => \NLW_gmux.gm[4].gms.ms_CARRY4_O_UNCONNECTED\(3 downto 0),
      S(3) => \NLW_gmux.gm[4].gms.ms_CARRY4_S_UNCONNECTED\(3),
      S(2 downto 0) => v1_reg(6 downto 4)
    );
end STRUCTURE;
library IEEE;
use IEEE.STD_LOGIC_1164.ALL;
library UNISIM;
use UNISIM.VCOMPONENTS.ALL;
entity fifo_8_compare_0 is
  port (
    ram_full_comb : out STD_LOGIC;
    v1_reg_0 : in STD_LOGIC_VECTOR ( 6 downto 0 );
    wr_en : in STD_LOGIC;
    comp0 : in STD_LOGIC;
    ram_full_i_reg : in STD_LOGIC;
    rd_en : in STD_LOGIC;
    \out\ : in STD_LOGIC
  );
  attribute ORIG_REF_NAME : string;
  attribute ORIG_REF_NAME of fifo_8_compare_0 : entity is "compare";
end fifo_8_compare_0;

architecture STRUCTURE of fifo_8_compare_0 is
  signal carrynet_0 : STD_LOGIC;
  signal carrynet_1 : STD_LOGIC;
  signal carrynet_2 : STD_LOGIC;
  signal carrynet_3 : STD_LOGIC;
  signal carrynet_4 : STD_LOGIC;
  signal carrynet_5 : STD_LOGIC;
  signal comp1 : STD_LOGIC;
  signal \NLW_gmux.gm[0].gm1.m1_CARRY4_O_UNCONNECTED\ : STD_LOGIC_VECTOR ( 3 downto 0 );
  signal \NLW_gmux.gm[4].gms.ms_CARRY4_CO_UNCONNECTED\ : STD_LOGIC_VECTOR ( 3 to 3 );
  signal \NLW_gmux.gm[4].gms.ms_CARRY4_DI_UNCONNECTED\ : STD_LOGIC_VECTOR ( 3 to 3 );
  signal \NLW_gmux.gm[4].gms.ms_CARRY4_O_UNCONNECTED\ : STD_LOGIC_VECTOR ( 3 downto 0 );
  signal \NLW_gmux.gm[4].gms.ms_CARRY4_S_UNCONNECTED\ : STD_LOGIC_VECTOR ( 3 to 3 );
  attribute OPT_MODIFIED : string;
  attribute OPT_MODIFIED of \gmux.gm[0].gm1.m1_CARRY4\ : label is "MLO ";
  attribute XILINX_LEGACY_PRIM : string;
  attribute XILINX_LEGACY_PRIM of \gmux.gm[0].gm1.m1_CARRY4\ : label is "(MUXCY,XORCY)";
  attribute box_type : string;
  attribute box_type of \gmux.gm[0].gm1.m1_CARRY4\ : label is "PRIMITIVE";
  attribute OPT_MODIFIED of \gmux.gm[4].gms.ms_CARRY4\ : label is "MLO ";
  attribute XILINX_LEGACY_PRIM of \gmux.gm[4].gms.ms_CARRY4\ : label is "(MUXCY,XORCY)";
  attribute box_type of \gmux.gm[4].gms.ms_CARRY4\ : label is "PRIMITIVE";
begin
\gmux.gm[0].gm1.m1_CARRY4\: unisim.vcomponents.CARRY4
     port map (
      CI => '0',
      CO(3) => carrynet_3,
      CO(2) => carrynet_2,
      CO(1) => carrynet_1,
      CO(0) => carrynet_0,
      CYINIT => '1',
      DI(3 downto 0) => B"0000",
      O(3 downto 0) => \NLW_gmux.gm[0].gm1.m1_CARRY4_O_UNCONNECTED\(3 downto 0),
      S(3 downto 0) => v1_reg_0(3 downto 0)
    );
\gmux.gm[4].gms.ms_CARRY4\: unisim.vcomponents.CARRY4
     port map (
      CI => carrynet_3,
      CO(3) => \NLW_gmux.gm[4].gms.ms_CARRY4_CO_UNCONNECTED\(3),
      CO(2) => comp1,
      CO(1) => carrynet_5,
      CO(0) => carrynet_4,
      CYINIT => '0',
      DI(3) => \NLW_gmux.gm[4].gms.ms_CARRY4_DI_UNCONNECTED\(3),
      DI(2 downto 0) => B"000",
      O(3 downto 0) => \NLW_gmux.gm[4].gms.ms_CARRY4_O_UNCONNECTED\(3 downto 0),
      S(3) => \NLW_gmux.gm[4].gms.ms_CARRY4_S_UNCONNECTED\(3),
      S(2 downto 0) => v1_reg_0(6 downto 4)
    );
ram_full_fb_i_i_1: unisim.vcomponents.LUT6
    generic map(
      INIT => X"FF0FFFFF88008888"
    )
        port map (
      I0 => wr_en,
      I1 => comp1,
      I2 => comp0,
      I3 => ram_full_i_reg,
      I4 => rd_en,
      I5 => \out\,
      O => ram_full_comb
    );
end STRUCTURE;
library IEEE;
use IEEE.STD_LOGIC_1164.ALL;
library UNISIM;
use UNISIM.VCOMPONENTS.ALL;
entity fifo_8_compare_1 is
  port (
    comp0 : out STD_LOGIC;
    \gmux.gm[1].gms.ms_0\ : in STD_LOGIC;
    \gmux.gm[2].gms.ms_0\ : in STD_LOGIC;
    \gmux.gm[3].gms.ms_0\ : in STD_LOGIC;
    \gmux.gm[4].gms.ms_0\ : in STD_LOGIC;
    \gmux.gm[5].gms.ms_0\ : in STD_LOGIC;
    \gmux.gm[6].gms.ms_0\ : in STD_LOGIC;
    ram_empty_i_reg : in STD_LOGIC
  );
  attribute ORIG_REF_NAME : string;
  attribute ORIG_REF_NAME of fifo_8_compare_1 : entity is "compare";
end fifo_8_compare_1;

architecture STRUCTURE of fifo_8_compare_1 is
  signal carrynet_0 : STD_LOGIC;
  signal carrynet_1 : STD_LOGIC;
  signal carrynet_2 : STD_LOGIC;
  signal carrynet_3 : STD_LOGIC;
  signal carrynet_4 : STD_LOGIC;
  signal carrynet_5 : STD_LOGIC;
  signal \NLW_gmux.gm[0].gm1.m1_CARRY4_O_UNCONNECTED\ : STD_LOGIC_VECTOR ( 3 downto 0 );
  signal \NLW_gmux.gm[4].gms.ms_CARRY4_CO_UNCONNECTED\ : STD_LOGIC_VECTOR ( 3 to 3 );
  signal \NLW_gmux.gm[4].gms.ms_CARRY4_DI_UNCONNECTED\ : STD_LOGIC_VECTOR ( 3 to 3 );
  signal \NLW_gmux.gm[4].gms.ms_CARRY4_O_UNCONNECTED\ : STD_LOGIC_VECTOR ( 3 downto 0 );
  signal \NLW_gmux.gm[4].gms.ms_CARRY4_S_UNCONNECTED\ : STD_LOGIC_VECTOR ( 3 to 3 );
  attribute OPT_MODIFIED : string;
  attribute OPT_MODIFIED of \gmux.gm[0].gm1.m1_CARRY4\ : label is "MLO ";
  attribute XILINX_LEGACY_PRIM : string;
  attribute XILINX_LEGACY_PRIM of \gmux.gm[0].gm1.m1_CARRY4\ : label is "(MUXCY,XORCY)";
  attribute box_type : string;
  attribute box_type of \gmux.gm[0].gm1.m1_CARRY4\ : label is "PRIMITIVE";
  attribute OPT_MODIFIED of \gmux.gm[4].gms.ms_CARRY4\ : label is "MLO ";
  attribute XILINX_LEGACY_PRIM of \gmux.gm[4].gms.ms_CARRY4\ : label is "(MUXCY,XORCY)";
  attribute box_type of \gmux.gm[4].gms.ms_CARRY4\ : label is "PRIMITIVE";
begin
\gmux.gm[0].gm1.m1_CARRY4\: unisim.vcomponents.CARRY4
     port map (
      CI => '0',
      CO(3) => carrynet_3,
      CO(2) => carrynet_2,
      CO(1) => carrynet_1,
      CO(0) => carrynet_0,
      CYINIT => '1',
      DI(3 downto 0) => B"0000",
      O(3 downto 0) => \NLW_gmux.gm[0].gm1.m1_CARRY4_O_UNCONNECTED\(3 downto 0),
      S(3) => \gmux.gm[4].gms.ms_0\,
      S(2) => \gmux.gm[3].gms.ms_0\,
      S(1) => \gmux.gm[2].gms.ms_0\,
      S(0) => \gmux.gm[1].gms.ms_0\
    );
\gmux.gm[4].gms.ms_CARRY4\: unisim.vcomponents.CARRY4
     port map (
      CI => carrynet_3,
      CO(3) => \NLW_gmux.gm[4].gms.ms_CARRY4_CO_UNCONNECTED\(3),
      CO(2) => comp0,
      CO(1) => carrynet_5,
      CO(0) => carrynet_4,
      CYINIT => '0',
      DI(3) => \NLW_gmux.gm[4].gms.ms_CARRY4_DI_UNCONNECTED\(3),
      DI(2 downto 0) => B"000",
      O(3 downto 0) => \NLW_gmux.gm[4].gms.ms_CARRY4_O_UNCONNECTED\(3 downto 0),
      S(3) => \NLW_gmux.gm[4].gms.ms_CARRY4_S_UNCONNECTED\(3),
      S(2) => ram_empty_i_reg,
      S(1) => \gmux.gm[6].gms.ms_0\,
      S(0) => \gmux.gm[5].gms.ms_0\
    );
end STRUCTURE;
library IEEE;
use IEEE.STD_LOGIC_1164.ALL;
library UNISIM;
use UNISIM.VCOMPONENTS.ALL;
entity fifo_8_compare_2 is
  port (
    rd_en_0 : out STD_LOGIC;
    v1_reg : in STD_LOGIC_VECTOR ( 6 downto 0 );
    rd_en : in STD_LOGIC;
    comp0 : in STD_LOGIC;
    ram_empty_i_reg : in STD_LOGIC;
    wr_en : in STD_LOGIC;
    \out\ : in STD_LOGIC
  );
  attribute ORIG_REF_NAME : string;
  attribute ORIG_REF_NAME of fifo_8_compare_2 : entity is "compare";
end fifo_8_compare_2;

architecture STRUCTURE of fifo_8_compare_2 is
  signal carrynet_0 : STD_LOGIC;
  signal carrynet_1 : STD_LOGIC;
  signal carrynet_2 : STD_LOGIC;
  signal carrynet_3 : STD_LOGIC;
  signal carrynet_4 : STD_LOGIC;
  signal carrynet_5 : STD_LOGIC;
  signal comp1 : STD_LOGIC;
  signal \NLW_gmux.gm[0].gm1.m1_CARRY4_O_UNCONNECTED\ : STD_LOGIC_VECTOR ( 3 downto 0 );
  signal \NLW_gmux.gm[4].gms.ms_CARRY4_CO_UNCONNECTED\ : STD_LOGIC_VECTOR ( 3 to 3 );
  signal \NLW_gmux.gm[4].gms.ms_CARRY4_DI_UNCONNECTED\ : STD_LOGIC_VECTOR ( 3 to 3 );
  signal \NLW_gmux.gm[4].gms.ms_CARRY4_O_UNCONNECTED\ : STD_LOGIC_VECTOR ( 3 downto 0 );
  signal \NLW_gmux.gm[4].gms.ms_CARRY4_S_UNCONNECTED\ : STD_LOGIC_VECTOR ( 3 to 3 );
  attribute OPT_MODIFIED : string;
  attribute OPT_MODIFIED of \gmux.gm[0].gm1.m1_CARRY4\ : label is "MLO ";
  attribute XILINX_LEGACY_PRIM : string;
  attribute XILINX_LEGACY_PRIM of \gmux.gm[0].gm1.m1_CARRY4\ : label is "(MUXCY,XORCY)";
  attribute box_type : string;
  attribute box_type of \gmux.gm[0].gm1.m1_CARRY4\ : label is "PRIMITIVE";
  attribute OPT_MODIFIED of \gmux.gm[4].gms.ms_CARRY4\ : label is "MLO ";
  attribute XILINX_LEGACY_PRIM of \gmux.gm[4].gms.ms_CARRY4\ : label is "(MUXCY,XORCY)";
  attribute box_type of \gmux.gm[4].gms.ms_CARRY4\ : label is "PRIMITIVE";
begin
\gmux.gm[0].gm1.m1_CARRY4\: unisim.vcomponents.CARRY4
     port map (
      CI => '0',
      CO(3) => carrynet_3,
      CO(2) => carrynet_2,
      CO(1) => carrynet_1,
      CO(0) => carrynet_0,
      CYINIT => '1',
      DI(3 downto 0) => B"0000",
      O(3 downto 0) => \NLW_gmux.gm[0].gm1.m1_CARRY4_O_UNCONNECTED\(3 downto 0),
      S(3 downto 0) => v1_reg(3 downto 0)
    );
\gmux.gm[4].gms.ms_CARRY4\: unisim.vcomponents.CARRY4
     port map (
      CI => carrynet_3,
      CO(3) => \NLW_gmux.gm[4].gms.ms_CARRY4_CO_UNCONNECTED\(3),
      CO(2) => comp1,
      CO(1) => carrynet_5,
      CO(0) => carrynet_4,
      CYINIT => '0',
      DI(3) => \NLW_gmux.gm[4].gms.ms_CARRY4_DI_UNCONNECTED\(3),
      DI(2 downto 0) => B"000",
      O(3 downto 0) => \NLW_gmux.gm[4].gms.ms_CARRY4_O_UNCONNECTED\(3 downto 0),
      S(3) => \NLW_gmux.gm[4].gms.ms_CARRY4_S_UNCONNECTED\(3),
      S(2 downto 0) => v1_reg(6 downto 4)
    );
ram_empty_fb_i_i_1: unisim.vcomponents.LUT6
    generic map(
      INIT => X"FF0FFFFF88008888"
    )
        port map (
      I0 => rd_en,
      I1 => comp1,
      I2 => comp0,
      I3 => ram_empty_i_reg,
      I4 => wr_en,
      I5 => \out\,
      O => rd_en_0
    );
end STRUCTURE;
library IEEE;
use IEEE.STD_LOGIC_1164.ALL;
library UNISIM;
use UNISIM.VCOMPONENTS.ALL;
entity fifo_8_rd_bin_cntr is
  port (
    \gc0.count_d1_reg[13]_0\ : out STD_LOGIC;
    Q : out STD_LOGIC_VECTOR ( 13 downto 0 );
    enb_array : out STD_LOGIC_VECTOR ( 2 downto 0 );
    v1_reg : out STD_LOGIC_VECTOR ( 6 downto 0 );
    v1_reg_1 : out STD_LOGIC_VECTOR ( 6 downto 0 );
    v1_reg_0 : out STD_LOGIC_VECTOR ( 6 downto 0 );
    \gc0.count_d1_reg[0]_0\ : out STD_LOGIC;
    \gc0.count_d1_reg[2]_0\ : out STD_LOGIC;
    \gc0.count_d1_reg[4]_0\ : out STD_LOGIC;
    \gc0.count_d1_reg[6]_0\ : out STD_LOGIC;
    \gc0.count_d1_reg[8]_0\ : out STD_LOGIC;
    \gc0.count_d1_reg[10]_0\ : out STD_LOGIC;
    \gc0.count_d1_reg[12]_0\ : out STD_LOGIC;
    srst : in STD_LOGIC;
    p_7_out : in STD_LOGIC;
    clk : in STD_LOGIC;
    \out\ : in STD_LOGIC;
    rd_en : in STD_LOGIC;
    \gmux.gm[6].gms.ms\ : in STD_LOGIC_VECTOR ( 13 downto 0 );
    D : in STD_LOGIC_VECTOR ( 13 downto 0 )
  );
  attribute ORIG_REF_NAME : string;
  attribute ORIG_REF_NAME of fifo_8_rd_bin_cntr : entity is "rd_bin_cntr";
end fifo_8_rd_bin_cntr;

architecture STRUCTURE of fifo_8_rd_bin_cntr is
  signal \^q\ : STD_LOGIC_VECTOR ( 13 downto 0 );
  signal \gc0.count[0]_i_2_n_0\ : STD_LOGIC;
  signal \gc0.count_reg[0]_i_1_n_0\ : STD_LOGIC;
  signal \gc0.count_reg[0]_i_1_n_1\ : STD_LOGIC;
  signal \gc0.count_reg[0]_i_1_n_2\ : STD_LOGIC;
  signal \gc0.count_reg[0]_i_1_n_3\ : STD_LOGIC;
  signal \gc0.count_reg[0]_i_1_n_4\ : STD_LOGIC;
  signal \gc0.count_reg[0]_i_1_n_5\ : STD_LOGIC;
  signal \gc0.count_reg[0]_i_1_n_6\ : STD_LOGIC;
  signal \gc0.count_reg[0]_i_1_n_7\ : STD_LOGIC;
  signal \gc0.count_reg[12]_i_1_n_3\ : STD_LOGIC;
  signal \gc0.count_reg[12]_i_1_n_6\ : STD_LOGIC;
  signal \gc0.count_reg[12]_i_1_n_7\ : STD_LOGIC;
  signal \gc0.count_reg[4]_i_1_n_0\ : STD_LOGIC;
  signal \gc0.count_reg[4]_i_1_n_1\ : STD_LOGIC;
  signal \gc0.count_reg[4]_i_1_n_2\ : STD_LOGIC;
  signal \gc0.count_reg[4]_i_1_n_3\ : STD_LOGIC;
  signal \gc0.count_reg[4]_i_1_n_4\ : STD_LOGIC;
  signal \gc0.count_reg[4]_i_1_n_5\ : STD_LOGIC;
  signal \gc0.count_reg[4]_i_1_n_6\ : STD_LOGIC;
  signal \gc0.count_reg[4]_i_1_n_7\ : STD_LOGIC;
  signal \gc0.count_reg[8]_i_1_n_0\ : STD_LOGIC;
  signal \gc0.count_reg[8]_i_1_n_1\ : STD_LOGIC;
  signal \gc0.count_reg[8]_i_1_n_2\ : STD_LOGIC;
  signal \gc0.count_reg[8]_i_1_n_3\ : STD_LOGIC;
  signal \gc0.count_reg[8]_i_1_n_4\ : STD_LOGIC;
  signal \gc0.count_reg[8]_i_1_n_5\ : STD_LOGIC;
  signal \gc0.count_reg[8]_i_1_n_6\ : STD_LOGIC;
  signal \gc0.count_reg[8]_i_1_n_7\ : STD_LOGIC;
  signal rd_pntr_plus1 : STD_LOGIC_VECTOR ( 13 downto 0 );
  signal \NLW_gc0.count_reg[12]_i_1_CO_UNCONNECTED\ : STD_LOGIC_VECTOR ( 3 downto 1 );
  signal \NLW_gc0.count_reg[12]_i_1_O_UNCONNECTED\ : STD_LOGIC_VECTOR ( 3 downto 2 );
begin
  Q(13 downto 0) <= \^q\(13 downto 0);
\DEVICE_7SERIES.NO_BMM_INFO.SDP.SIMPLE_PRIM36.ram_i_2\: unisim.vcomponents.LUT5
    generic map(
      INIT => X"55100000"
    )
        port map (
      I0 => \^q\(12),
      I1 => \out\,
      I2 => rd_en,
      I3 => srst,
      I4 => \^q\(13),
      O => enb_array(2)
    );
\DEVICE_7SERIES.NO_BMM_INFO.SDP.SIMPLE_PRIM36.ram_i_2__0\: unisim.vcomponents.LUT5
    generic map(
      INIT => X"000000AE"
    )
        port map (
      I0 => srst,
      I1 => rd_en,
      I2 => \out\,
      I3 => \^q\(12),
      I4 => \^q\(13),
      O => enb_array(0)
    );
\DEVICE_7SERIES.NO_BMM_INFO.SDP.SIMPLE_PRIM36.ram_i_2__1\: unisim.vcomponents.LUT5
    generic map(
      INIT => X"44440400"
    )
        port map (
      I0 => \^q\(13),
      I1 => \^q\(12),
      I2 => \out\,
      I3 => rd_en,
      I4 => srst,
      O => enb_array(1)
    );
\DEVICE_7SERIES.NO_BMM_INFO.SDP.SIMPLE_PRIM36.ram_i_2__2\: unisim.vcomponents.LUT5
    generic map(
      INIT => X"88880800"
    )
        port map (
      I0 => \^q\(13),
      I1 => \^q\(12),
      I2 => \out\,
      I3 => rd_en,
      I4 => srst,
      O => \gc0.count_d1_reg[13]_0\
    );
\gc0.count[0]_i_2\: unisim.vcomponents.LUT1
    generic map(
      INIT => X"1"
    )
        port map (
      I0 => rd_pntr_plus1(0),
      O => \gc0.count[0]_i_2_n_0\
    );
\gc0.count_d1_reg[0]\: unisim.vcomponents.FDRE
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
    srst : in STD_LOGIC;
    E : in STD_LOGIC_VECTOR ( 0 to 0 );
    clk : in STD_LOGIC;
    wr_en : in STD_LOGIC;
    \out\ : in STD_LOGIC
  );
  attribute ORIG_REF_NAME : string;
  attribute ORIG_REF_NAME of fifo_8_wr_bin_cntr : entity is "wr_bin_cntr";
end fifo_8_wr_bin_cntr;
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
