alwaysmy/Artix-7_GTP_USB3_WCH_MCU/2_Firmware/Artix-7_GTP_USB3_WCH_MCU_XillyUSB-USBC_SpeedTest/verilog/src/xillydemo.v

module xillydemo
  (
   input  gtx_refclk_n,
   input  gtx_refclk_p,
   input  gtx_rxn,
   input  gtx_rxp,
   output  gtx_txn,
   output  gtx_txp,
   output [7:0] gpio_led
   );

   // Clock and quiesce
   wire 	bus_clk;
   wire 	quiesce;

   // Memory array
   reg [7:0] 	demoarray[0:31];

   // Wires related to /dev/xillyusb_NN_mem_8
   wire       user_r_mem_8_rden;
   wire       user_r_mem_8_empty;
   reg [7:0]  user_r_mem_8_data;
   wire       user_r_mem_8_eof;
   wire       user_r_mem_8_open;
   wire       user_w_mem_8_wren;
   wire       user_w_mem_8_full;
   wire [7:0] user_w_mem_8_data;
   wire       user_w_mem_8_open;
   wire [4:0] user_mem_8_addr;
   wire       user_mem_8_addr_update;

   // Wires related to /dev/xillyusb_NN_read_32
   wire       user_r_read_32_rden;
   wire       user_r_read_32_empty;
   wire [31:0] user_r_read_32_data;
   wire        user_r_read_32_eof;
   wire        user_r_read_32_open;

   // Wires related to /dev/xillyusb_NN_read_8
   wire        user_r_read_8_rden;
   wire        user_r_read_8_empty;
   wire [7:0]  user_r_read_8_data;
   wire        user_r_read_8_eof;
   wire        user_r_read_8_open;

   // Wires related to /dev/xillyusb_NN_write_32
   wire        user_w_write_32_wren;
   wire        user_w_write_32_full;
   wire [31:0] user_w_write_32_data;
   wire        user_w_write_32_open;

   // Wires related to /dev/xillyusb_NN_write_8
   wire        user_w_write_8_wren;
   wire        user_w_write_8_full;
   wire [7:0]  user_w_write_8_data;
   wire        user_w_write_8_open;

   xillyusb xillyusb_ins (
			  // Ports related to /dev/xillyusb_NN_mem_8
			  // FPGA to CPU signals:
			  .user_r_mem_8_rden(user_r_mem_8_rden),
			  .user_r_mem_8_empty(user_r_mem_8_empty),
			  .user_r_mem_8_data(user_r_mem_8_data),
			  .user_r_mem_8_eof(user_r_mem_8_eof),
			  .user_r_mem_8_open(user_r_mem_8_open),

			  // CPU to FPGA signals:
			  .user_w_mem_8_wren(user_w_mem_8_wren),
			  .user_w_mem_8_full(user_w_mem_8_full),
			  .user_w_mem_8_data(user_w_mem_8_data),
			  .user_w_mem_8_open(user_w_mem_8_open),

			  // Address signals:
			  .user_mem_8_addr(user_mem_8_addr),
			  .user_mem_8_addr_update(user_mem_8_addr_update),

			  // Ports related to /dev/xillyusb_NN_read_32
			  // FPGA to CPU signals:
			  .user_r_read_32_rden(user_r_read_32_rden),
			  .user_r_read_32_empty(1'b0),//user_r_read_32_empty),
			  .user_r_read_32_data(user_r_read_32_data),
			  .user_r_read_32_eof(user_r_read_32_eof),
			  .user_r_read_32_open(user_r_read_32_open),

			  // Ports related to /dev/xillyusb_NN_write_32
			  // CPU to FPGA signals:
			  .user_w_write_32_wren(user_w_write_32_wren),
			  .user_w_write_32_full(1'b0),// user_w_write_32_full),
			  .user_w_write_32_data(user_w_write_32_data),
			  .user_w_write_32_open(user_w_write_32_open),

			  // Ports related to /dev/xillyusb_NN_read_8
			  // FPGA to CPU signals:
			  .user_r_read_8_rden(user_r_read_8_rden),
			  .user_r_read_8_empty(1'b0),// user_r_read_8_empty),
			  .user_r_read_8_data(user_r_read_8_data),
			  .user_r_read_8_eof(user_r_read_8_eof),
			  .user_r_read_8_open(user_r_read_8_open),

			  // Ports related to /dev/xillyusb_NN_write_8
			  // CPU to FPGA signals:
			  .user_w_write_8_wren(user_w_write_8_wren),
			  .user_w_write_8_full(1'b0),// user_w_write_8_full),
			  .user_w_write_8_data(user_w_write_8_data),
			  .user_w_write_8_open(user_w_write_8_open),

			  // General signals
			  .gtx_refclk_n(gtx_refclk_n),
			  .gtx_refclk_p(gtx_refclk_p),
			  .gtx_rxn(gtx_rxn),
			  .gtx_rxp(gtx_rxp),
			  .gtx_txn(gtx_txn),
			  .gtx_txp(gtx_txp),

			  .gpio_led(gpio_led),

			  .bus_clk(bus_clk),
			  .quiesce(quiesce)
			  );

   // A simple inferred RAM
   always @(posedge bus_clk)
     begin
	if (user_w_mem_8_wren)
	  demoarray[user_mem_8_addr] <= user_w_mem_8_data;

	if (user_r_mem_8_rden)
	  user_r_mem_8_data <= demoarray[user_mem_8_addr];
     end

   assign  user_r_mem_8_empty = 0;
   assign  user_r_mem_8_eof = 0;
   assign  user_w_mem_8_full = 0;

   // 32-bit loopback
   fifo_32 fifo_32_ins
     (
      .clk(bus_clk),
      .srst(!user_w_write_32_open && !user_r_read_32_open),
      .din(user_w_write_32_data),
      .wr_en(user_w_write_32_wren),
      .rd_en(user_r_read_32_rden),
      .dout(user_r_read_32_data),
      .full(user_w_write_32_full),
      .empty(user_r_read_32_empty)
      );

   assign  user_r_read_32_eof = 0;

   // 8-bit loopback
   fifo_8 fifo_8_ins
     (
      .clk(bus_clk),
      .srst(!user_w_write_8_open && !user_r_read_8_open),
      .din(user_w_write_8_data),
      .wr_en(user_w_write_8_wren),
      .rd_en(user_r_read_8_rden),
      .dout(user_r_read_8_data),
      .full(user_w_write_8_full),
      .empty(user_r_read_8_empty)
      );

   assign  user_r_read_8_eof = 0;

endmodule
