alwaysmy/Artix-7_GTP_USB3_WCH_MCU/(commit log)

2025-10-07 初次提交
    [ProDoc_XC7K35T_GTP_USB_Core_LiteRevB.1.brd_2025-10-08.epro]
2025-10-07 添加工程和说明
2025-10-12 更新readme
